jmharvey1/SdrCwXcvr/Eagle/SDR 74HC4052/SDR 74HC4052_Si5351R1Board.pdf

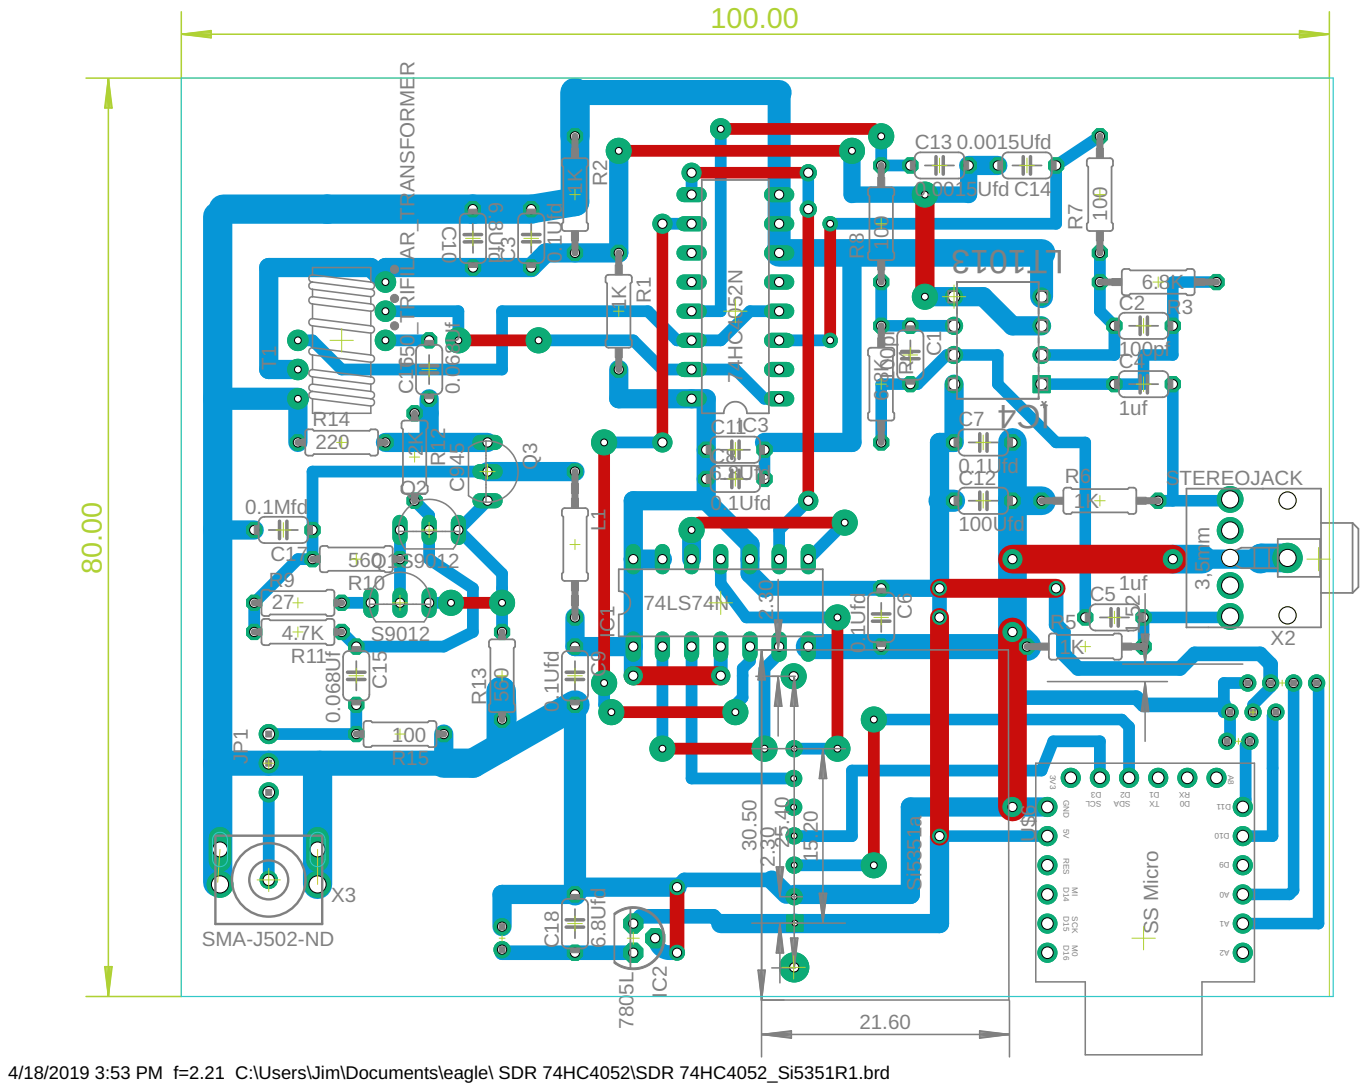
[picture p1: page 1]

4/18/2019 3:53 PM f=2.21 C:\Users\Jim\Documents\eagle\ SDR 74HC4052\SDR 74HC4052_Si5351R1.brd
