jmharvey1/SdrCwXcvr/Eagle/SDR 74HC4052/SDR 74HC4052_Si5351R1Schem.pdf

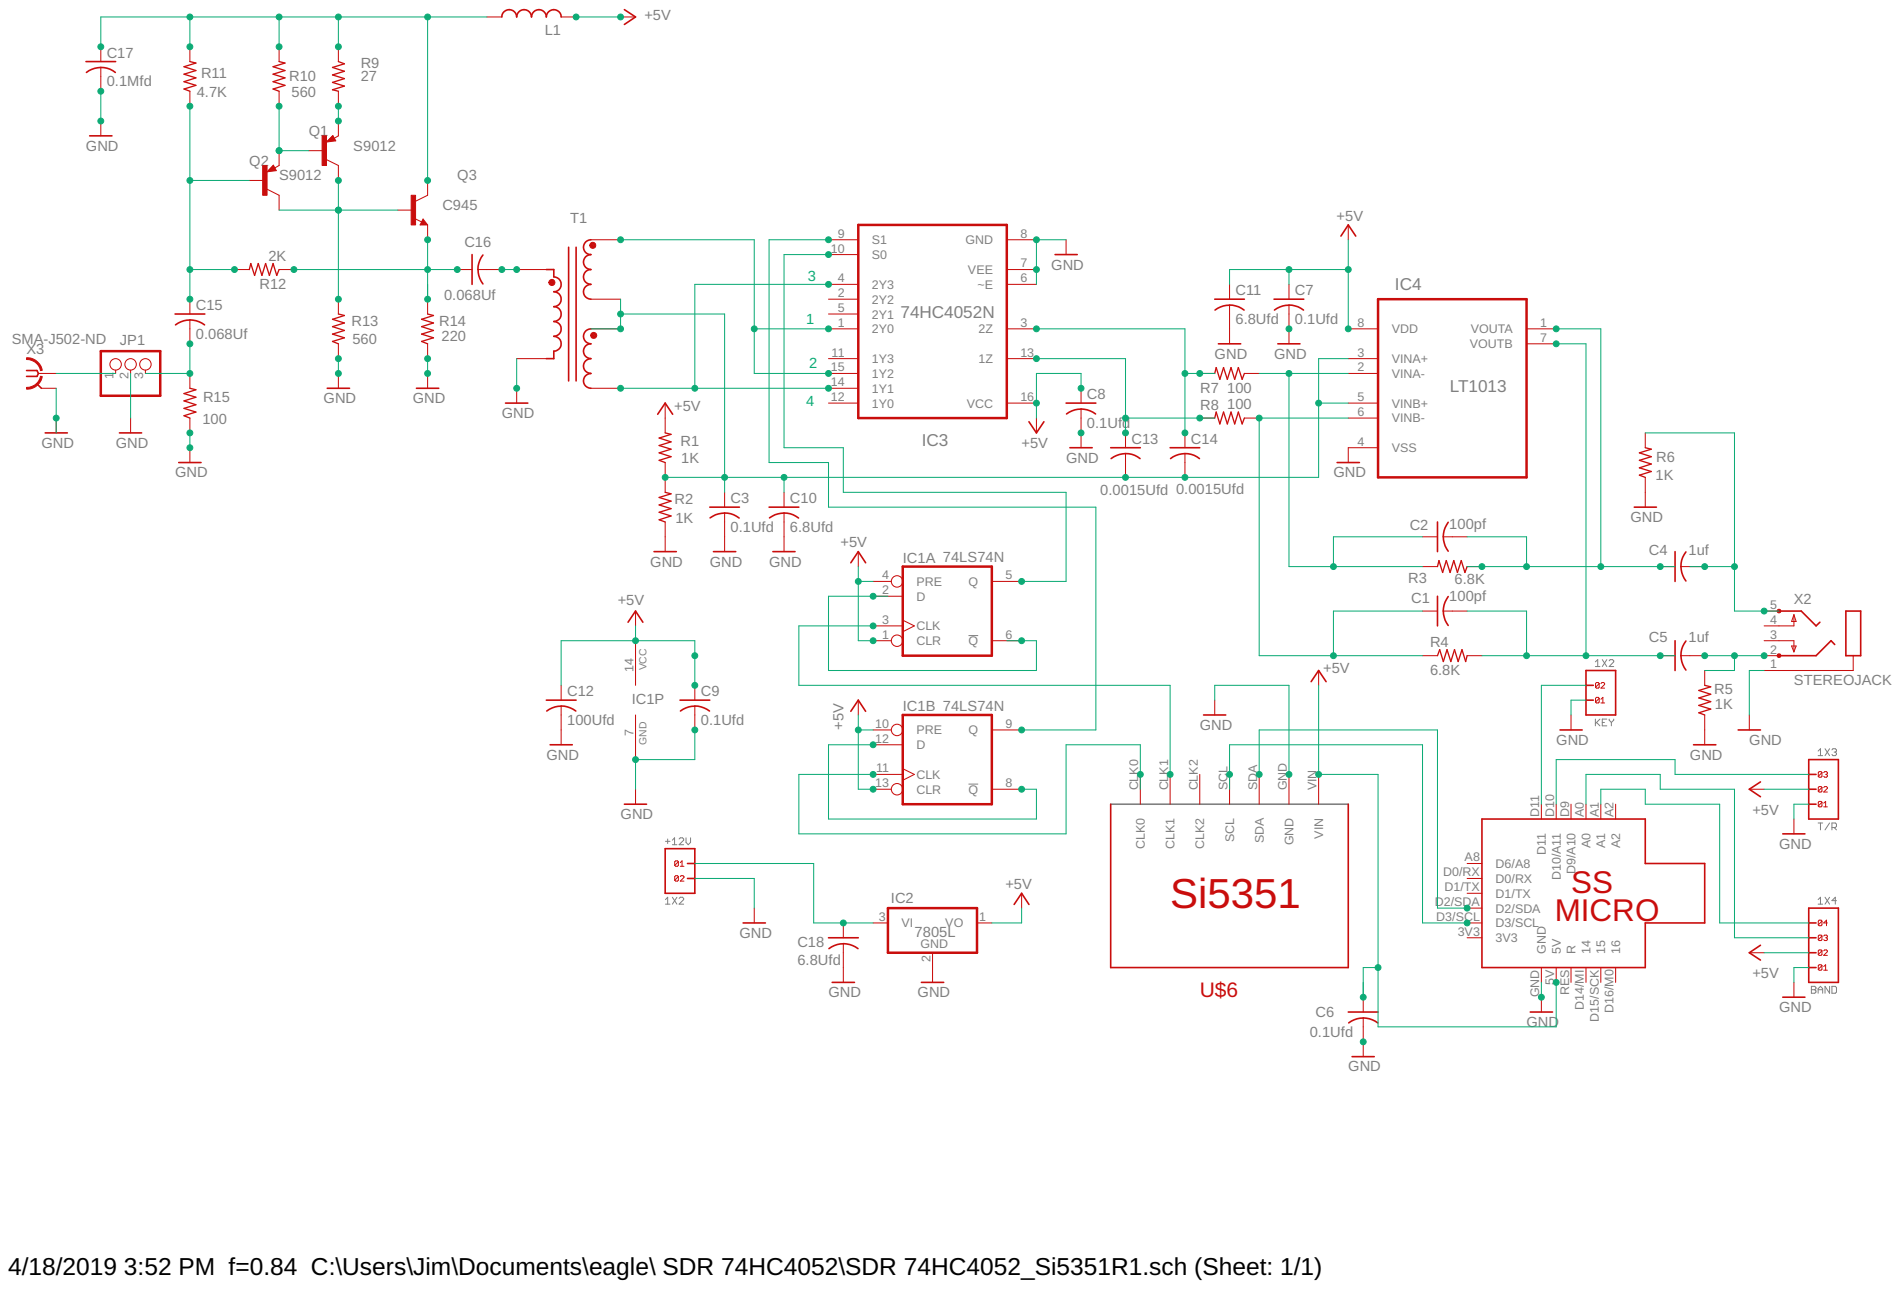
[picture p2: page 1]

4/18/2019 3:52 PM f=0.84 C:\Users\Jim\Documents\eagle\ SDR 74HC4052\SDR 74HC4052_Si5351R1.sch (Sheet: 1/1)
