jmharvey1/SdrCwXcvr/Eagle/100mwPA/40M_100mWattWSPRamp.pdf

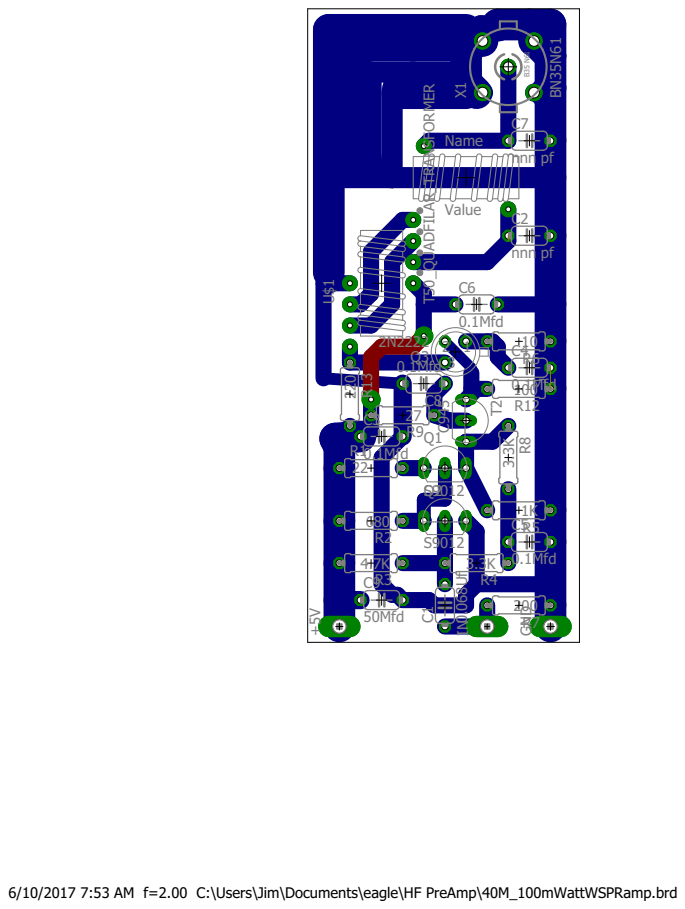
[picture p3: page 1]

6/10/2017 7:53 AM f=2.00 C:\Users\Jim\Documents\eagle\HF PreAmp\40M_100mWattWSPRamp.brd
