jmharvey1/SdrCwXcvr/Eagle/SDR 74HC4052/SDR 74HC4052_Si5351SchemR0.pdf

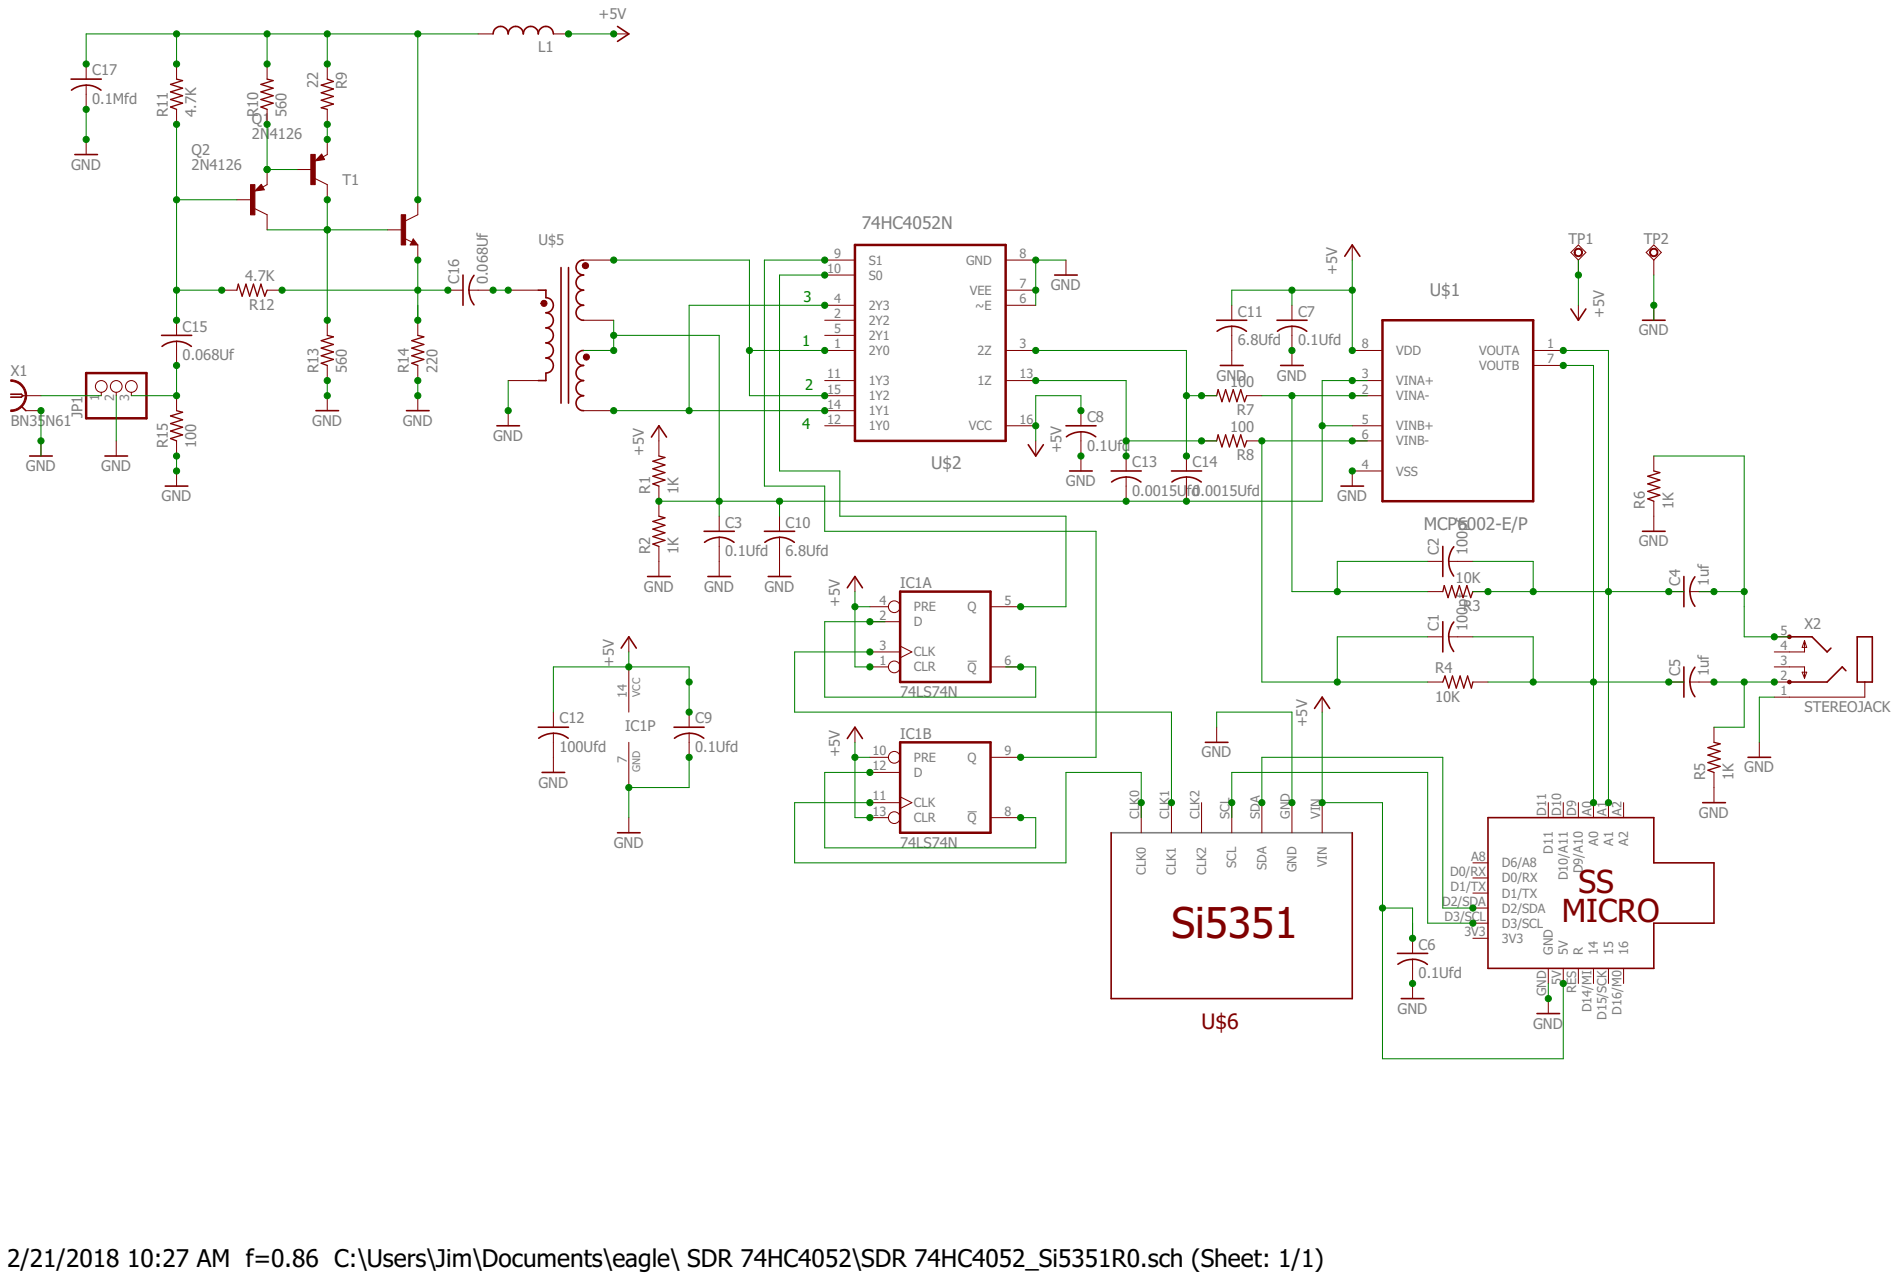
[picture p4: page 1]

2/21/2018 10:27 AM f=0.86 C:\Users\Jim\Documents\eagle\ SDR 74HC4052\SDR 74HC4052_Si5351R0.sch (Sheet: 1/1)
