jmharvey1/SdrCwXcvr/Eagle/SDR 74HC4052/SDR 74HC4052_Si5351R1.brd

## EAGLE design Eagle/SDR 74HC4052/SDR 74HC4052_Si5351R1.brd (2019-04-18)

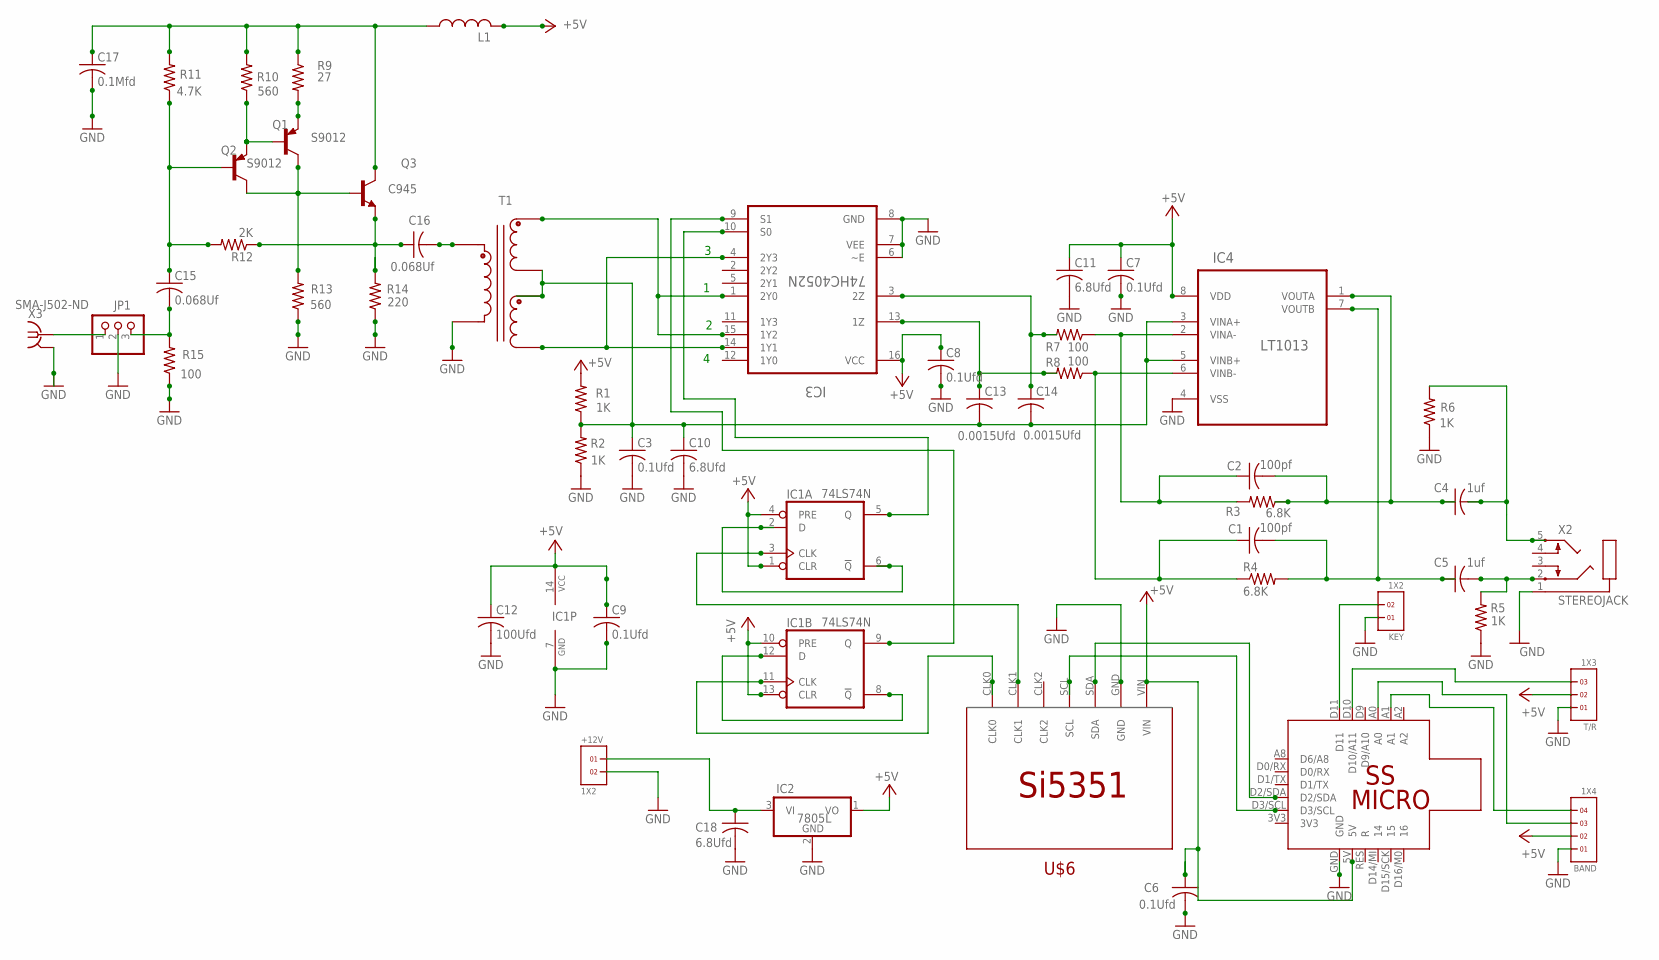
[picture p5: schematic SDR 74HC4052_Si5351R1.sch]

Parts:
+12V: 1X2
BAND: 1X4
C1, C2: 100pf; C050-024X044
C3, C6, C7, C8, C9: 0.1Ufd; C050-024X044
C4, C5: 1uf; C050-024X044
C10, C11, C18: 6.8Ufd; C050-024X044
C12: 100Ufd; C050-024X044
C13, C14: 0.0015Ufd; C050-024X044
C15, C16: 0.068Uf; C050-024X044
C17: 0.1Mfd; C050-024X044
IC1: 74LS74N; DIL14
IC2: 7805L; TO92
IC3: 74HC4052N; DIL16
IC4: LT1013; DIP254P762X533-8
JP1: PINHD-1X3CB; 1X03-CLEANBIG
KEY: 1X2
L1: L-US0207/12; 0207/12
Q1, Q2: S9012; TO92-CBE
Q3: C945; TO92-ECB
R1, R2, R5, R6: 1K; 0207/10
R3, R4: 6.8K; 0207/10
R7, R8: 100; 0207/10
R9: 27; 0207/7
R10, R13: 560; 0207/7
R11: 4.7K; 0207/7
R12: 2K; 0207/7
R14: 220; 0207/7
R15: 100; 0207/7
T1: T50_TRIFILAR_TRANSFORMER
T/R: 1X3
U$4: SS_MICRO
U$6: SI5351-BKBD; SI5351-BKOUT-BRD
X2: STEREOJACK; STX3100
X3: SMA-J502-ND; J502-ND

Connections:
+5V: BAND.2, C6.1, C7.1, C8.1, C9.1, C11.1, C12.1, IC1.1 (CLR), IC1.4 (PRE), IC1.10 (PRE), IC1.13 (CLR), IC1.14 (VCC), IC2.1 (VO), IC3.16 (VCC), IC4.8 (VDD), L1.2, R1.2, T/R.2, U$4.5V, U$6.VIN
GND: +12V.2, BAND.1, C3.2, C6.2, C7.2, C8.2, C9.2, C10.2, C11.2, C12.2, C17.2, C18.2, IC1.7 (GND), IC2.2 (GND), IC3.6 (~E), IC3.7 (VEE), IC3.8 (GND), IC4.4 (VSS), JP1.2, KEY.1, R2.1, R5.1, R6.1, R13.1, R14.1, R15.1, T1.C1A, T/R.1, U$4.GND, U$6.GND, X2.1, X3.2, X3.3 (2), X3.4 (2), X3.5 (2)
unnamed: C1.1, IC4.6 (VINB-), R4.1, R8.1
unnamed: C13.1, IC3.13 (1Z), R8.2
unnamed: C2.1, IC4.2 (VINA-), R3.2, R7.1
unnamed: C14.1, IC3.3 (2Z), R7.2
unnamed: C16.2, T1.C1B
unnamed: IC1.11 (CLK), U$6.CLK0
unnamed: IC1.5 (Q), IC3.10 (S0)
unnamed: IC3.1 (2Y0), IC3.15 (1Y2), T1.C2B
unnamed: C2.2, C4.1, IC4.1 (VOUTA), R3.1
unnamed: C1.2, C5.1, IC4.7 (VOUTB), R4.2
unnamed: Q1.E, R9.2
unnamed: U$4.D3/SCL, U$6.SCL
unnamed: U$4.D2/SDA, U$6.SDA
unnamed: C3.1, C10.1, C13.2, C14.2, IC4.3 (VINA+), IC4.5 (VINB+), R1.1, R2.2, T1.C2A, T1.C3B
unnamed: Q1.B, Q2.E, R10.1
unnamed: IC1.3 (CLK), U$6.CLK1
unnamed: IC3.4 (2Y3), IC3.14 (1Y1), T1.C3A
unnamed: IC1.9 (Q), IC3.9 (S1)
unnamed: C5.2, R5.2, X2.2
unnamed: C4.2, R6.2, X2.5
unnamed: IC1.2 (D), IC1.6 (!Q)
unnamed: IC1.8 (!Q), IC1.12 (D)
unnamed: Q1.C, Q2.C, Q3.B, R13.2
unnamed: C15.1, Q2.B, R11.1, R12.2
unnamed: C15.2, JP1.3, R15.2
unnamed: JP1.1, X3.1
unnamed: C16.1, Q3.E, R12.1, R14.2
unnamed: C17.1, L1.1, Q3.C, R9.1, R10.2, R11.2
unnamed: +12V.1, C18.1, IC2.3 (VI)
unnamed: T/R.3, U$4.D10 (D10/A11)
unnamed: BAND.3, U$4.A0
unnamed: BAND.4, U$4.A1
unnamed: KEY.2, U$4.D11

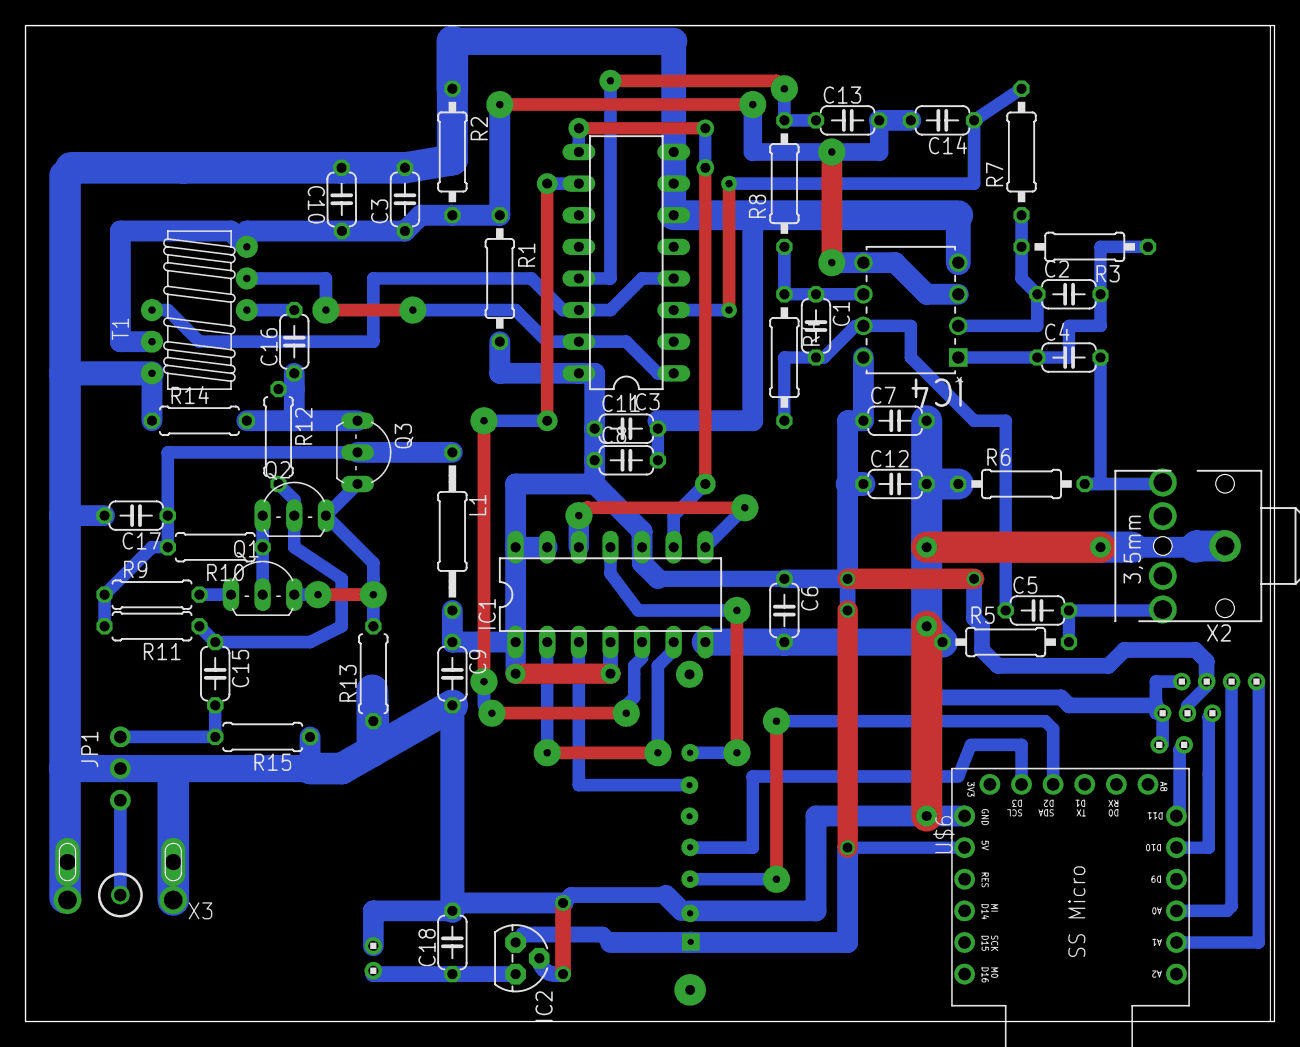
[picture p6: board SDR 74HC4052_Si5351R1.brd from above]

Board: 2 copper layers, 100.3 x 80.0 mm, 51 parts (0 on the bottom side), 35 nets.
