jmharvey1/SdrCwXcvr/Eagle/100mwPA/40M_100mWattWSPRamp.brd

## EAGLE design Eagle/100mwPA/40M_100mWattWSPRamp.brd (2018-12-15)

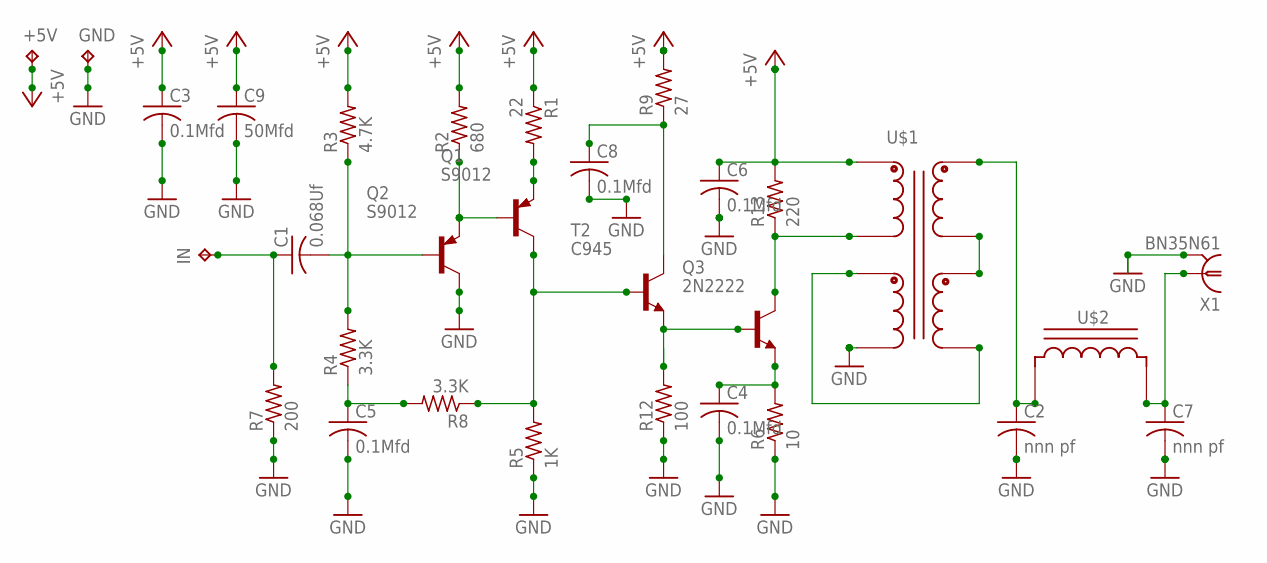
[picture p7: schematic 40M_100mWattWSPRamp.sch]

Parts:
+5V: TPPAD1-17Y; P1-17Y
C1: 0.068Uf; C050-024X044
C2, C7: nnn pf; C050-024X044
C3, C4, C5, C6, C8: 0.1Mfd; C050-024X044
C9: 50Mfd; C050-024X044
GND: TPPAD1-17Y; P1-17Y
IN: TPPAD1-17Y; P1-17Y
Q1, Q2: S9012; TO92-CBE
Q3: 2N2222; TO18
R1: 22; 0207/7
R2: 680; 0207/7
R3: 4.7K; 0207/7
R4, R8: 3.3K; 0207/7
R5: 1K; 0207/7
R6: 10; 0207/7
R7: 200; 0207/7
R9: 27; 0207/7
R12: 100; 0207/7
R13: 220; 0207/7
T2: C945; TO92-ECB
U$1: T50_QUADFILAR_TRANSFORMER
U$2: T50_INDUCTOR
X1: BN35N61; B35N61

Connections:
+5V: +5V.TP, C3.1, C6.1, C9.1, R1.1, R2.2, R3.2, R9.2, R13.2, U$1.C1B
+5V1: C5.1, R4.1, R8.2
+5V2: C2.1, U$1.C2B, U$2.CB
+5V3: C7.1, U$2.CA, X1.1
+5V4: C8.1, R9.1, T2.C
GND: C2.2, C3.2, C4.2, C5.2, C6.2, C7.2, C8.2, C9.2, GND.TP, Q2.C, R5.1, R6.1, R7.1, R12.1, U$1.C4A, X1.2, X1.3 (2), X1.4 (2), X1.5 (2)
unnamed: Q1.E, R1.2
unnamed: Q1.B, Q2.E, R2.1
unnamed: Q3.2 (B), R12.2, T2.E
unnamed: C1.2, Q2.B, R3.1, R4.2
unnamed: C1.1, IN.TP, R7.2
unnamed: U$1.C3A, U$1.C4B
unnamed: C4.1, Q3.1 (E), R6.2
unnamed: U$1.C2A, U$1.C3B
unnamed: Q1.C, R5.2, R8.1, T2.B
unnamed: Q3.3 (C), R13.1, U$1.C1A

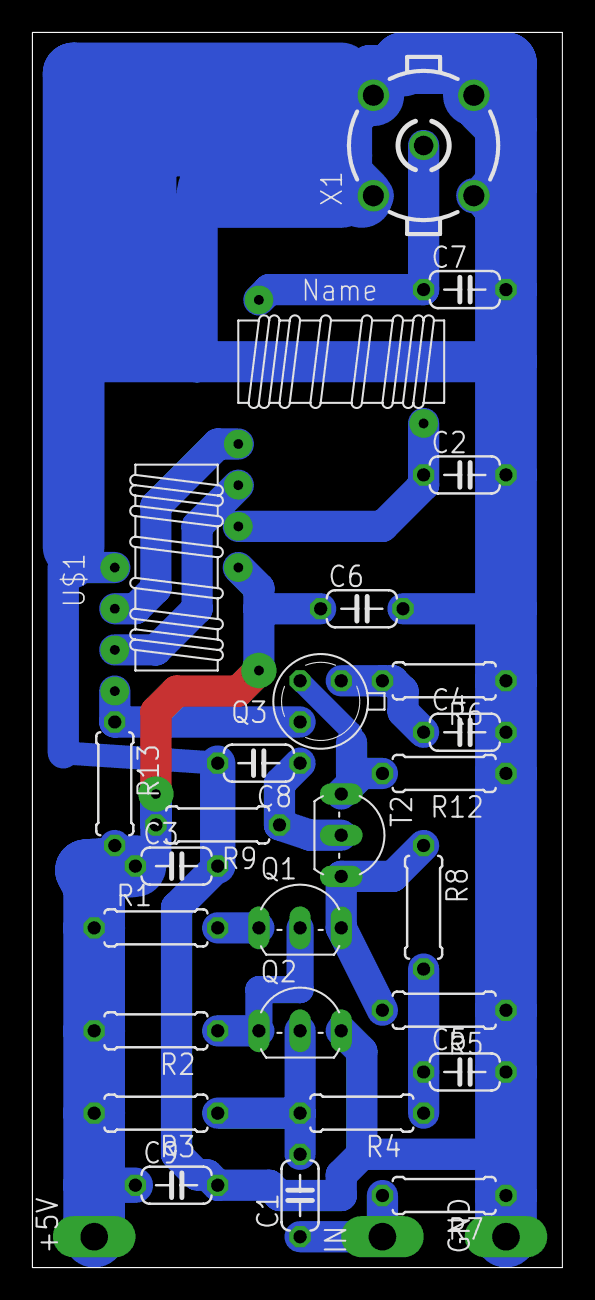
[picture p8: board 40M_100mWattWSPRamp.brd from above]

Board: 2 copper layers, 32.7 x 76.2 mm, 30 parts (0 on the bottom side), 16 nets.
