jmharvey1/SdrCwXcvr/Eagle/74145SDRbandCntrlBd/74145SDRbandCntrlBd.brd

## EAGLE design Eagle/74145SDRbandCntrlBd/74145SDRbandCntrlBd.brd (2018-12-14)

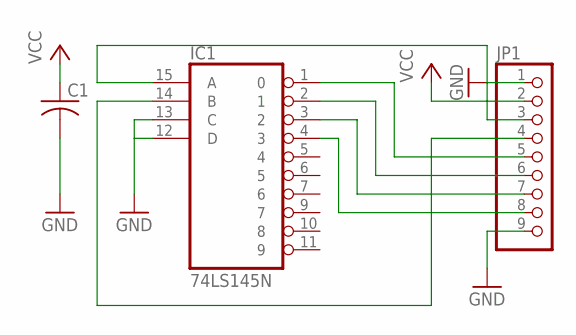
[picture p9: schematic 74145SDRbandCntrlBd.sch]

Parts:
C1: C-US050-024X044; C050-024X044
IC1: 74LS145N; DIL16
JP1: PINHD-1X9; 1X09-BIG

Connections:
GND: C1.2, IC1.8 (GND), IC1.12 (D), IC1.13 (C), JP1.1, JP1.9
unnamed: IC1.15 (A), JP1.3
unnamed: IC1.14 (B), JP1.4
unnamed: IC1.4 (3), JP1.8
unnamed: IC1.3 (2), JP1.7
unnamed: IC1.2 (1), JP1.6
unnamed: IC1.1 (0), JP1.5
VCC: C1.1, IC1.16 (VCC), JP1.2

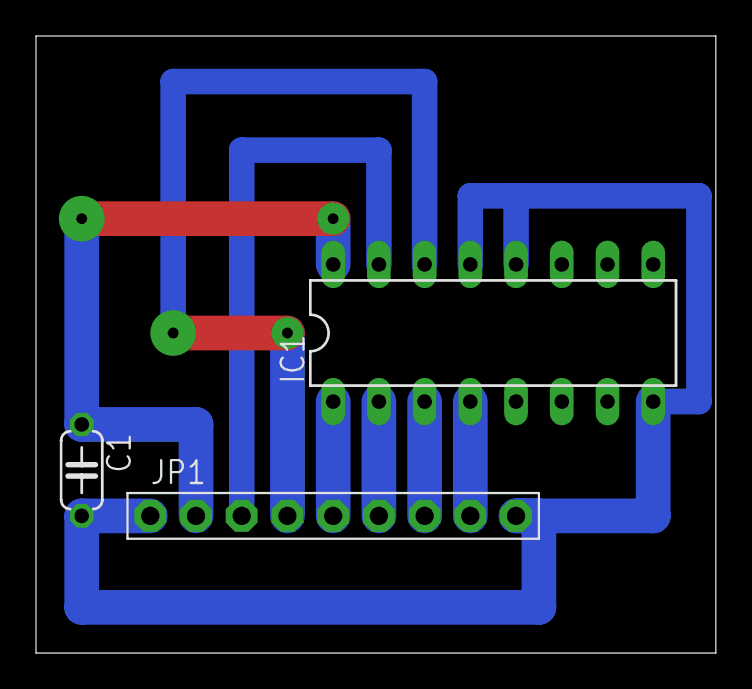
[picture p10: board 74145SDRbandCntrlBd.brd from above]

Board: 2 copper layers, 37.8 x 34.3 mm, 3 parts (0 on the bottom side), 8 nets.
