jmharvey1/SdrCwXcvr/Quisk/quisk.py

#! /usr/bin/python

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
"""The main program for Quisk, a software defined radio.

Usage:  python quisk.py [-c | --config config_file_path]
This can also be installed as a package and run as quisk.main().
"""

from __future__ import print_function
from __future__ import absolute_import
from __future__ import division

# Change to the directory of quisk.py.  This is necessary to import Quisk packages
# and to load other extension modules that link against _quisk.so.  It also helps to
# find ./__init__.py and ./help.html.
import sys, os
os.chdir(os.path.normpath(os.path.dirname(__file__)))
if sys.path[0] != "'.'":		# Make sure the current working directory is on path
  sys.path.insert(0, '.')

import wx, wx.html, wx.lib.stattext, wx.lib.colourdb, wx.grid, wx.richtext
import math, cmath, time, traceback, string, select, subprocess
import threading, pickle, webbrowser
try:
  from xmlrpc.client import ServerProxy
except ImportError:
  from xmlrpclib import ServerProxy
import _quisk as QS
from types import *
from quisk_widgets import *
from filters import Filters
import dxcluster
import configure

DEBUGSHELL = False
if DEBUGSHELL:
  from wx.py.crust import CrustFrame
  from wx.py.shell import ShellFrame

# Fldigi XML-RPC control opens a local socket.  If socket.setdefaulttimeout() is not
# called, the timeout on Linux is zero (1 msec) and on Windows is 2 seconds.  So we
# call it to insure consistent behavior.
import socket
socket.setdefaulttimeout(0.005)

HAMLIB_DEBUG = 0

application = None

# Command line parsing: be able to specify the config file.
from optparse import OptionParser
parser = OptionParser()
parser.add_option('-c', '--config', dest='config_file_path',
		help='Specify the configuration file path')
parser.add_option('', '--config2', dest='config_file_path2', default='',
		help='Specify a second configuration file to read after the first')
parser.add_option('-a', '--ask', action="store_true", dest='AskMe', default=False,
		help='Ask which radio to use when starting')
parser.add_option('', '--local', dest='local_option', default='',
		help='Specify a custom option that you have programmed yourself')
argv_options = parser.parse_args()[0]
ConfigPath = argv_options.config_file_path	# Get config file path
ConfigPath2 = argv_options.config_file_path2
LocalOption = argv_options.local_option
if sys.platform == 'win32':
  path = os.getenv('HOMEDRIVE', '') + os.getenv('HOMEPATH', '')
  for dir in ("Documents", "My Documents", "Eigene Dateien", "Documenti", "Mine Dokumenter"):
    config_dir = os.path.join(path, dir)
    if os.path.isdir(config_dir):
      break
  else:
    config_dir = os.path.join(path, "My Documents")
  try:
    try:
      import winreg as Qwinreg
    except ImportError:
      import _winreg as Qwinreg
    key = Qwinreg.OpenKey(Qwinreg.HKEY_CURRENT_USER,
       r"Software\Microsoft\Windows\CurrentVersion\Explorer\User Shell Folders")
    val = Qwinreg.QueryValueEx(key, "Personal")
    val = Qwinreg.ExpandEnvironmentStrings(val[0])
    Qwinreg.CloseKey(key)
    if os.path.isdir(val):
      DefaultConfigDir = val
    else:
      DefaultConfigDir = config_dir
  except:
    traceback.print_exc()
    DefaultConfigDir = config_dir
  if not ConfigPath:
    ConfigPath = os.path.join(DefaultConfigDir, "quisk_conf.py")
    if not os.path.isfile(ConfigPath):
      path = os.path.join(config_dir, "quisk_conf.py")
      if os.path.isfile(path):
        ConfigPath = path
  del config_dir
else:
  DefaultConfigDir = os.path.expanduser('~')
  if not ConfigPath:
    ConfigPath = os.path.join(DefaultConfigDir, ".quisk_conf.py")

# These FFT sizes have multiple small factors, and are prefered for efficiency.  FFT size must be an even number.
fftPreferedSizes = []
for f2 in range(1, 13):
  for y in (1, 3, 5, 7, 9, 11, 13, 15):
    for z in (1, 3, 5, 7, 9, 11, 13, 15):
      x = 2**f2 * y * z
      if 300 <= x <= 5000 and x not in fftPreferedSizes:
        fftPreferedSizes.append(x)
fftPreferedSizes.sort()

def round(x):	# round float to nearest integer
  if x >= 0:
    return int(x + 0.5)
  else:
    return - int(-x + 0.5)
    
def str2freq (freq):
  if '.' in freq:
    freq = int(float(freq) * 1E6 + 0.1)
  else:
    freq = int(freq)
  return freq    

def get_filter_tx(mode):	# Return the bandwidth, center of the Tx filters
  if mode in ('LSB', 'USB'):
    bw = 2700
    center = 1650
  elif mode in ('CWL', 'CWU'):
    bw = 10
    center = 0
  elif mode in ('AM', 'DGT-IQ'):
    bw = 6000
    center = 0
  elif mode in ('FM', 'DGT-FM'):
    bw = 10000
    center = 0
  elif mode in ('FDV-L', 'FDV-U'):
    bw = 2700
    center = 1500
  else:
    bw = 2700
    center = 1650
  if mode in ('CWL', 'LSB', 'DGT-L', 'FDV-L'):
    center = - center
  return bw, center

Mode2Index = {'CWL':0, 'CWU':1, 'LSB':2, 'USB':3, 'AM':4, 'FM':5, 'EXT':6, 'DGT-U':7, 'DGT-L':8, 'DGT-IQ':9,
      'IMD':10, 'FDV-U':11, 'FDV-L':12, 'DGT-FM':13}

class Timer:
  """Debug: measure and print times every ptime seconds.

  Call with msg == '' to start timer, then with a msg to record the time.
  """
  def __init__(self, ptime = 1.0):
    self.ptime = ptime		# frequency to print in seconds
    self.time0 = 0			# time zero; measure from this time
    self.time_print = 0		# last time data was printed
    self.timers = {}		# one timer for each msg
    self.names = []			# ordered list of msg
    self.heading = 1		# print heading on first use
  def __call__(self, msg):
    tm = time.time()
    if msg:
      if not self.time0:		# Not recording data
        return
      if msg in self.timers:
        count, average, highest = self.timers[msg]
      else:
        self.names.append(msg)
        count = 0
        average = highest = 0.0
      count += 1
      delta = tm - self.time0
      average += delta
      if highest < delta:
        highest = delta
      self.timers[msg] = (count, average, highest)
      if tm - self.time_print > self.ptime:	# time to print results
        self.time0 = 0		# end data recording, wait for reset
        self.time_print = tm
        if self.heading:
          self.heading = 0
          print ("count, msg, avg, max (msec)")
        print("%4d" % count, end=' ')
        for msg in self.names:		# keep names in order
          count, average, highest = self.timers[msg]
          if not count:
            continue
          average /= count
          print("  %s  %7.3f  %7.3f" % (msg, average * 1e3, highest * 1e3), end=' ')
          self.timers[msg] = (0, 0.0, 0.0)
        print()
    else:	# reset the time to zero
      self.time0 = tm		# Start timer
      if not self.time_print:
        self.time_print = tm

## T = Timer()		# Make a timer instance

class HamlibHandlerSerial:
  "Create a serial port for Hamlib control that emulates the FlexRadio PowerSDR 2.x command set."
  # This implements some Kenwood TS-2000 commands, but it is far from complete.
  Mo2CoKen = {'CWL':7, 'CWU':3, 'LSB':1, 'USB':2, 'AM':5, 'FM':4, 'DGT-U':9, 'DGT-L':6, 'DGT-FM':4, 'DGT-IQ':9}
  Co2MoKen = {1:'LSB', 2:'USB', 3:'CWU', 4:'FM', 5:'AM', 6:'DGT-L', 7:'CWL', 9:'DGT-U'}
  Mo2CoFlex = {'CWL':3, 'CWU':4, 'LSB':0, 'USB':1, 'AM':6, 'FM':5, 'DGT-U':7, 'DGT-L':9, 'DGT-FM':5, 'DGT-IQ':7}
  Co2MoFlex = {0:'LSB', 1:'USB', 3:'CWL', 4:'CWU', 5:'FM', 6:'AM', 7:'DGT-U', 9:'DGT-L'}
  def __init__(self, app, public_name):
    self.app = app
    self.port = None
    self.received = ''
    self.radio_id = '019'
    self.public_name = public_name	# the public name for the serial port
    if sys.platform == 'win32':
      try:
        import serial
      except:
        print ("Please install the pyserial module.")
      else:
        try:
          self.port = serial.Serial(public_name, timeout=0, write_timeout=0)
        except:
          print ("The serial port %s could not be opened." % public_name)
    else:
      import tty
      if os.path.lexists(public_name):
        try:
          os.remove(public_name)
        except:
          print ("Can not remove the file", public_name)
      try:
        self.port, slave = os.openpty()	# we are the master device fd, slave is a pseudo tty
        tty.setraw(self.port)
        tty.setraw(slave)
      except:
        print ("Can not create the serial port")
        self.port = None
      else:
        try:
          os.symlink(os.ttyname(slave), public_name)	# create a link from the specified name to the slave device
        except:
          print ("Can not create a link named", public_name)
          self.port = None
        else:
          if HAMLIB_DEBUG: print ("Create", public_name, "from", os.ttyname(slave))
  def open(self):
    return
  def close(self):
    if sys.platform != 'win32':
      if self.public_name:
        try:
          os.remove(self.public_name)
        except:
          pass
  def Read(self):
    if self.port is None:
      return
    if sys.platform == 'win32':
      self.received += str(self.port.read(99))
    else:
      while True:
        r, w, x = select.select((self.port,), (), (), 0)
        if not r:
          break
        self.received += os.read(self.port, 1)
  def Process(self):
    """This is the main processing loop, and is called frequently.  It reads and satisfies requests."""
    self.Read()
    if ';' in self.received:	# A complete command ending with semicolon is available
      cmd, self.received = self.received.split(';', 1)	# Split off the command, save any further characters
    else:
      return
    cmd = cmd.strip()		# Here is our command and data
    if cmd[0:2] in ('ZZ', 'zz', 'Zz', 'zZ'):
      data = cmd[4:]
      cmd = cmd[0:4].upper()
      func = cmd
    else:
      data = cmd[2:]
      cmd = cmd[0:2].upper()
      if cmd in ('FA', 'FB', 'IF', 'PS'):	# Use the ZZxx command method
        func = 'ZZ' + cmd
      else:			# Use the two-letter method
        func = cmd
    if data:
      if HAMLIB_DEBUG: print ("Process command  :", cmd, data)
    try:
      func = getattr(self, func)
    except:
      print ("Unimplemented serial port function", func, 'cmd', cmd, 'data', data)
      self.Write('?;')
      return
    func(cmd, data, len(data))
  def Error(self, cmd, data):
    self.Write('?;')
    print ("*** Error for cmd %s data %s" % (cmd, data))
  def Write(self, data):
    if HAMLIB_DEBUG: print ("Serial port write:", data)
    if self.port is None:
      return
    if sys.platform == 'win32':
      self.port.write(data)
    else:
      r, w, x = select.select((), (self.port,), (), 0)
      if w:
        os.write(self.port, data)
  def AG(self, cmd, data, length):	# audio gain
    if length == 1:
      self.Write("%s%s120;" % (cmd, data[0]))
  def ZZAG(self, cmd, data, length):	# audio gain
    if length == 0:
      self.Write("%s050;" % cmd)
  def ZZAI(self, cmd, data, length):	# broadcast changes
    if length == 0:
      self.Write("%s0;" % cmd)
    elif length == 1 and data[0] == '0':
      pass
    else:
      self.Error(cmd, data)
  def ZZFA(self, cmd, data, length):	# frequency of VFO A, the receive frequency
    if length == 0:
      self.Write("%s%011d;" % (cmd, self.app.rxFreq + self.app.VFO))
    elif length == 11:
      freq = int(data, base=10)
      tune = freq - self.app.VFO
      d = self.app.sample_rate * 45 // 100
      if -d <= tune <= d:	# Frequency is on-screen
        vfo = self.app.VFO
      else:					# Change the VFO
        vfo = (freq // 5000) * 5000 - 5000
        tune = freq - vfo
      self.app.BandFromFreq(freq)
      self.app.ChangeHwFrequency(tune, vfo, 'FreqEntry')
      if HAMLIB_DEBUG: print ("New Freq rx,tx", self.app.txFreq + self.app.VFO, self.app.rxFreq + self.app.VFO)
    else:
      self.Error(cmd, data)
  def ZZFB(self, cmd, data, length):	# frequency of VFO B
    if length == 0:
      self.Write("%s%011d;" % (cmd, self.app.txFreq + self.app.VFO))
    elif length == 11:
      freq = int(data, base=10)
      tune = freq - self.app.VFO
      d = self.app.sample_rate * 45 // 100
      if -d <= tune <= d:	# Frequency is on-screen
        vfo = self.app.VFO
      else:					# Change the VFO
        vfo = (freq // 5000) * 5000 - 5000
        tune = freq - vfo
      self.app.BandFromFreq(freq)
      self.app.ChangeHwFrequency(tune, vfo, 'FreqEntry')
    else:
      self.Error(cmd, data)
  def FR(self, cmd, data, length):	# receive VFO is always VFO A
    if length == 0:
      self.Write("%s0;" % cmd)
    elif length == 1 and data[0] == '0':
      pass
    else:
      self.Error(cmd, data)
  def FT(self, cmd, data, length):	# transmit VFO
    if self.app.split_rxtx:
      vfo = '1'
    else:
      vfo = '0'
    if length == 0:
      self.Write("%s%s;" % (cmd, vfo))
    elif length == 1 and data[0] == vfo:
      pass
    else:
      self.Error(cmd, data)
  def ID(self, cmd, data, length):	# return radio ID
    if length == 0:
      self.Write('%s%s;' % (cmd, self.radio_id))
    else:
      self.Error(cmd, data)
  def ZZID(self, cmd, data, length):	# set radio id to Flex
    if length == 0:
      self.radio_id = '900'
    else:
      self.Error(cmd, data)
  def ZZIF(self, cmd, data, length):	# return information for ZZIF and IF
    ritFreq = self.app.ritScale.GetValue()
    if self.app.ritButton.GetValue():
      rit = 1
    else:
      rit = 0
    mode = self.app.mode
    info = cmd
    info += "%011d" % (self.app.rxFreq + self.app.VFO)	# frequency, ZZFA
    info += '0000'
    if ritFreq < 0:	# RIT freq
      info += "-%05d" % -ritFreq
    else:
      info += "+%05d" % ritFreq
    info += "%d" % rit	# RIT status
    info += '0000'
    if QS.is_key_down():	# MOX, key down
      info += '1'
    else:
      info += '0'
    if len(cmd) == 4:	# Flex ZZIF
      code = self.Mo2CoFlex.get(mode, 1)
      info += "%02d" % code	# operating mode
    else:		# Kenwood IF
      code = self.Mo2CoKen.get(mode, 1)
      info += "%d" % code	# operating mode
    info += '00'
    if self.app.split_rxtx:	# VFO split status
      info += '1'
    else:
      info += '0'
    info += '0000'
    info += ';'
    self.Write(info)
  def MD(self, cmd, data, length):	# the mode; USB, CW, etc.
    if length == 0:
      mode = self.app.mode
      code = self.Mo2CoKen.get(mode, 2)
      self.Write("%s%d;" % (cmd, code))
    elif length == 1:
      code = int(data, base=10)
      mode = self.Co2MoKen.get(code, 'USB')
      self.app.OnBtnMode(None, mode)		# Set mode
    else:
      self.Error(cmd, data)
  def ZZMD(self, cmd, data, length):	# the mode; USB, CW, etc.
    if length == 0:
      mode = self.app.mode
      code = self.Mo2CoFlex.get(mode, 1)
      self.Write("%s%02d;" % (cmd, code))
    elif length == 2:
      code = int(data, base=10)
      mode = self.Co2MoFlex.get(code, 'USB')
      self.app.OnBtnMode(None, mode)	# Set mode
    else:
      self.Error(cmd, data)
  def ZZMU(self, cmd, data, length):	# MultiRx on/off
    if length == 0:
      self.Write("%s0;" % cmd)
  def OI(self, cmd, data, length):      # return information
    self.ZZIF(cmd, data, length)
  def ZZPS(self, cmd, data, length):	# power status
    if length == 0:
      self.Write("%s1;" % cmd)
  def ZZRS(self, cmd, data, length):	# the RX2 status
    if length == 0:
      self.Write("%s0;" % cmd)
    elif length == 1 and data[0] == '0':
      pass
    else:
      self.Error(cmd, data)
  def RX(self, cmd, data, length):	# turn off MOX
    if length == 0:
      if self.app.pttButton:
        self.app.pttButton.SetValue(0, True)
      else:
        self.Error(cmd, data)
    else:
      self.Error(cmd, data)
  def ZZSP(self, cmd, data, length):	# the split status
    if length == 0:
      if self.app.split_rxtx:
        self.Write("%s1;" % cmd)
      else:
        self.Write("%s0;" % cmd)
    else:
      self.Error(cmd, data)
  def ZZSW(self, cmd, data, length):	# transmit VFO is A or B
    if length == 0:
      if self.app.split_rxtx:
        self.Write("%s1;" % cmd)
      else:
        self.Write("%s0;" % cmd)
  def TX(self, cmd, data, length):	# turn on MOX
    if length == 0:
      if self.app.pttButton:
        self.app.pttButton.SetValue(1, True)
      else:
        self.Error(cmd, data)
    else:
      self.Error(cmd, data)
  def ZZTX(self, cmd, data, length):	# the MOX status
    if length == 0:
      if QS.is_key_down():
        self.Write("%s1;" % cmd)
      else:
        self.Write("%s0;" % cmd)
    elif length == 1:
      if self.app.pttButton:
        if data[0] == '0':
          self.app.pttButton.SetValue(0, True)
        else:
          self.app.pttButton.SetValue(1, True)
      else:
        self.Error(cmd, data)
    else:
      self.Error(cmd, data)
  def ZZVE(self, cmd, data, length):	# is VOX enabled
    if length == 0:
      if self.app.useVOX:
        self.Write("%s1;" % cmd)
      else:
        self.Write("%s0;" % cmd)
    else:
      self.Error(cmd, data)
  def XT(self, cmd, data, length):	# the XIT
    if length == 0:
      self.Write("%s0;" % cmd)
    elif length == 1 and data[0] == '0':
      pass
    else:
      self.Error(cmd, data)

class HamlibHandlerRig2:
  """This class is created for each connection to the server.  It services requests from each client"""
  SingleLetters = {		# convert single-letter commands to long commands
    '_':'info',
    'f':'freq',
    'i':'split_freq',
    'm':'mode',
    's':'split_vfo',
    't':'ptt',
    'v':'vfo',
    }
# I don't understand the need for dump_state, nor what it means.
# A possible response to the "dump_state" request:
  dump1 = """ 2
2
2
150000.000000 1500000000.000000 0x1ff -1 -1 0x10000003 0x3
0 0 0 0 0 0 0
0 0 0 0 0 0 0
0x1ff 1
0x1ff 0
0 0
0x1e 2400
0x2 500
0x1 8000
0x1 2400
0x20 15000
0x20 8000
0x40 230000
0 0
9990
9990
10000
0
10 
10 20 30 
0x3effffff
0x3effffff
0x7fffffff
0x7fffffff
0x7fffffff
0x7fffffff
"""

# Another possible response to the "dump_state" request:
  dump2 = """ 0
2
2
150000.000000 30000000.000000  0x900af -1 -1 0x10 000003 0x3
0 0 0 0 0 0 0
150000.000000 30000000.000000  0x900af -1 -1 0x10 000003 0x3
0 0 0 0 0 0 0
0 0
0 0
0
0
0
0


0x0
0x0
0x0
0x0
0x0
0
"""
  def __init__(self, app, sock, address):
    self.app = app		# Reference back to the "hardware"
    self.sock = sock
    sock.settimeout(0.0)
    self.address = address
    self.received = ''
    h = self.Handlers = {}
    h[''] = self.ErrProtocol
    h['dump_state']	= self.DumpState
    h['chk_vfo']	= self.ChkVfo	# Thanks to Franco Spinelli, IW2DHW
    h['get_freq']	= self.GetFreq
    h['set_freq']	= self.SetFreq
    h['get_info']	= self.GetInfo
    h['get_mode']	= self.GetMode
    h['set_mode']	= self.SetMode
    h['get_vfo']	= self.GetVfo
    h['get_ptt']	= self.GetPtt
    h['set_ptt']	= self.SetPtt
    h['get_split_freq']	= self.GetSplitFreq
    h['set_split_freq']	= self.SetSplitFreq
    h['get_split_vfo']	= self.GetSplitVfo
    h['set_split_vfo']	= self.SetSplitVfo
  def Send(self, text):
    """Send text back to the client."""
    try:
      self.sock.sendall(text)
    except socket.error:
      self.sock.close()
      self.sock = None
  def Reply(self, *args):	# args is name, value, name, value, ..., int
    """Create a string reply of name, value pairs, and an ending integer code."""
    if self.extended:			# Use extended format
      t = "%s:" % self.cmd		# Extended format echoes the command and parameters
      for param in self.params:
        t = "%s %s" % (t, param)
      t += self.extended
      for i in range(0, len(args) - 1, 2):
        t = "%s%s: %s%c" % (t, args[i], args[i+1], self.extended)
      t += "RPRT %d\n" % args[-1]
    elif len(args) > 1:		# Use simple format
      t = ''
      for i in range(1, len(args) - 1, 2):
        t = "%s%s\n" % (t, args[i])
    else:		# No names; just the required integer code
      t = "RPRT %d\n" % args[0]
    # print 'Reply', t
    self.Send(t)
  def ErrParam(self):		# Invalid parameter
    self.Reply(-1)
  def UnImplemented(self):	# Command not implemented
    self.Reply(-4)
  def ErrProtocol(self):	# Protocol error
    self.Reply(-8)
  def Process(self):
    """This is the main processing loop, and is called frequently.  It reads and satisfies requests."""
    if not self.sock:
      return 0
    try:	# Read any data from the socket
      text = self.sock.recv(1024)
    except socket.timeout:	# This does not work
      pass
    except socket.error:	# Nothing to read
      pass
    else:					# We got some characters
      self.received += text
    if '\n' in self.received:	# A complete command ending with newline is available
      cmd, self.received = self.received.split('\n', 1)	# Split off the command, save any further characters
    else:
      return 1
    cmd = cmd.strip()		# Here is our command
    # print 'Get', cmd
    if not cmd:			# ??? Indicates a closed connection?
      # print 'empty command'
      self.sock.close()
      self.sock = None
      return 0
    # Parse the command and call the appropriate handler
    if cmd[0] == '+':			# rigctld Extended Response Protocol
      self.extended = '\n'
      cmd = cmd[1:].strip()
    elif cmd[0] in ';|,':		# rigctld Extended Response Protocol
      self.extended = cmd[0]
      cmd = cmd[1:].strip()
    else:
      self.extended = None
    if cmd[0:1] == '\\':		# long form command starting with backslash
      args = cmd[1:].split()
      self.cmd = args[0]
      self.params = args[1:]
      self.Handlers.get(self.cmd, self.UnImplemented)()
    else:						# single-letter command
      self.params = cmd[1:].strip()
      cmd = cmd[0:1]
      if cmd in 'Qq':	# Quit command
        return 0
      try:
        t = self.SingleLetters[cmd.lower()]
      except KeyError:
        self.UnImplemented()
      else:
        if cmd in string.uppercase:
          self.cmd = 'set_' + t
        else:
          self.cmd = 'get_' + t
        self.Handlers.get(self.cmd, self.UnImplemented)()
    return 1
  # These are the handlers for each request
  def DumpState(self):
    self.Send(self.dump2)
  def ChkVfo(self):
    self.Send('CHKVFO 0')
  def GetFreq(self):
    self.Reply('Frequency', self.app.rxFreq + self.app.VFO, 0)
  def SetFreq(self):
    try:
      freq = float(self.params)
      self.Reply(0)
    except:
      self.ErrParam()
    else:
      freq = int(freq + 0.5)
      self.app.ChangeRxTxFrequency(freq, None)
  def GetSplitFreq(self):
    self.Reply('TX Frequency', self.app.txFreq + self.app.VFO, 0)
  def SetSplitFreq(self):
    try:
      freq = float(self.params)
      self.Reply(0)
    except:
      self.ErrParam()
    else:
      freq = int(freq + 0.5)
      if self.app.split_rxtx and not self.app.split_hamlib_tx:
        self.app.ChangeRxTxFrequency(freq, None)
      else:
        self.app.ChangeRxTxFrequency(None, freq)
  def GetSplitVfo(self):
    # I am not sure if "VFO" is a suitable response
    if self.app.split_rxtx:
      self.Reply('Split', 1, 'TX VFO', 'VFO', 0)
    else:
      self.Reply('Split', 0, 'TX VFO', 'VFO', 0)
  def SetSplitVfo(self):
    # Currently (Aug 2012) hamlib fails to send the "split" parameter, so this fails
    try:
      split, vfo = self.params.split()
      split = int(split)
      self.Reply(0)
    except:
      # traceback.print_exc()
      self.ErrParam()
    else:
      self.app.splitButton.SetValue(split, True)
  def GetInfo(self):
    self.Reply("Info", self.app.main_frame.title, 0)
  def GetMode(self):
    mode = self.app.mode
    if mode == 'CWU':
      mode = 'CW'
    elif mode == 'CWL':		# Is this what CWR means?
      mode = 'CWR'
    elif mode == 'DGT-FM':
      mode = 'FM'
    elif mode[0:4] == 'DGT-':
      mode = 'USB'
    self.Reply('Mode', mode, 'Passband', self.app.filter_bandwidth, 0)
  def SetMode(self):
    try:
      mode, bw = self.params.split()
      bw = int(float(bw) + 0.5)
    except:
      self.ErrParam()
      return
    if mode in ('USB', 'LSB', 'AM', 'FM'):
      self.Reply(0)
    elif mode[0:4] == 'DGT-':
      self.Reply(0)
    elif mode == 'CW':
      mode = 'CWU'
      self.Reply(0)
    elif mode == 'CWR':
      mode = 'CWL'
      self.Reply(0)
    else:
      self.ErrParam()
      return
    self.app.OnBtnMode(None, mode)		# Set mode
    if bw <= 0:		# use default bandwidth
      return
    # Choose button closest to requested bandwidth
    buttons = self.app.filterButns.GetButtons()
    Lab = buttons[0].GetLabel()
    diff = abs(int(Lab) - bw)
    for i in range(1, len(buttons) - 1):
      label = buttons[i].GetLabel()
      df = abs(int(label) - bw)
      if df < diff:
        Lab = label
        diff = df
    self.app.OnBtnFilter(None, int(Lab))
  def GetVfo(self):
    self.Reply('VFO', "VFO", 0)		# The type of VFO we have
  def GetPtt(self):
    if QS.is_key_down():
      self.Reply('PTT', 1, 0)
    else:
      self.Reply('PTT', 0, 0)
  def SetPtt(self):
    if not self.app.pttButton:
      self.UnImplemented()
      return
    try:
      ptt = int(self.params)
      self.Reply(0)
    except:
      self.ErrParam()
    else:
      self.app.pttButton.SetValue(ptt, True)

class SoundThread(threading.Thread):
  """Create a second (non-GUI) thread to read, process and play sound."""
  def __init__(self):
    self.do_init = 1
    threading.Thread.__init__(self)
    self.doQuit = threading.Event()
    self.doQuit.clear()
  def run(self):
    """Read, process, play sound; then notify the GUI thread to check for FFT data."""
    if self.do_init:	# Open sound using this thread
      self.do_init = 0
      QS.start_sound()
      wx.CallAfter(application.PostStartup)
    while not self.doQuit.isSet():
      QS.read_sound()
      wx.CallAfter(application.OnReadSound)
    QS.close_sound()
  def stop(self):
    """Set a flag to indicate that the sound thread should end."""
    self.doQuit.set()

class ConfigScreen(wx.Panel):
  """Display a notebook with status and configuration data"""
  def __init__(self, parent, width, fft_size):
    self.y_scale = 0
    self.y_zero = 0
    self.finish_pages = True
    self.width = width
    wx.Panel.__init__(self, parent)
    self.notebook = notebook = wx.Notebook(self)
    font = wx.Font(conf.config_font_size, wx.FONTFAMILY_SWISS, wx.NORMAL,
          wx.FONTWEIGHT_NORMAL, False, conf.quisk_typeface)
    notebook.SetFont(font)
    sizer = wx.BoxSizer()
    sizer.Add(notebook, 1, wx.EXPAND)
    self.SetSizer(sizer)
    # create the page windows
    self.status = ConfigStatus(notebook, width, fft_size)
    self.SetBackgroundColour(self.status.bg_color)
    self.SetForegroundColour(self.status.tfg_color)
    notebook.bg_color = self.status.bg_color
    notebook.tfg_color = self.status.tfg_color
    notebook.AddPage(self.status, "Status")
    self.config = ConfigConfig(notebook, width)
    notebook.AddPage(self.config, "Config")
    self.sound = ConfigSound(notebook, width)
    notebook.AddPage(self.sound, "Sound")
    self.favorites = ConfigFavorites(notebook, width)
    notebook.AddPage(self.favorites, "Favorites")
    self.tx_audio = ConfigTxAudio(notebook, width)
    notebook.AddPage(self.tx_audio, "Tx Audio")
    self.tx_audio.status = self.status
  def FinishPages(self):
    if self.finish_pages:
      self.finish_pages = False
      application.local_conf.AddPages(self.notebook, self.width)
  def ChangeYscale(self, y_scale):
    pass
  def ChangeYzero(self, y_zero):
    pass
  def OnIdle(self, event):
    pass
  def SetTxFreq(self, tx_freq, rx_freq):
    pass
  def OnGraphData(self, data=None):
    self.status.OnGraphData(data)
    self.tx_audio.OnGraphData(data)
  def InitBitmap(self):		# Initial construction of bitmap
    self.status.InitBitmap()

class ConfigStatus(wx.ScrolledWindow):
  """Display the status screen."""
  def __init__(self, parent, width, fft_size):
    wx.ScrolledWindow.__init__(self, parent)
    self.Bind(wx.EVT_PAINT, self.OnPaint)
    self.bg_color = self.GetBackgroundColour()
    self.tfg_color = wx.Colour(20, 20, 20)	# use for text foreground
    self.width = width
    self.fft_size = fft_size
    self.scroll_height = None
    self.interupts = 0
    self.read_error = -1
    self.write_error = -1
    self.underrun_error = -1
    self.fft_error = -1
    self.latencyCapt = -1
    self.latencyPlay = -1
    self.y_scale = 0
    self.y_zero = 0
    self.rate_min = -1
    self.rate_max = -1
    self.chan_min = -1
    self.chan_max = -1
    self.mic_max_display = 0
    self.err_msg = "No response"
    self.msg1 = ""
    self.font = wx.Font(conf.status_font_size, wx.FONTFAMILY_SWISS, wx.NORMAL,
          wx.FONTWEIGHT_NORMAL, False, conf.quisk_typeface)
    if wxVersion in ('2', '3'):
      self.SetBackgroundStyle(wx.BG_STYLE_CUSTOM)
    else:
      self.SetBackgroundStyle(wx.BG_STYLE_PAINT)
    self.SetFont(self.font)
    charx = self.charx = self.GetCharWidth()
    chary = self.chary = self.GetCharHeight()
    self.dy = chary		# line spacing
    self.rjustify1 = (0, 1, 0)
    self.tabstops1 = [0] * 3
    self.tabstops1[0] = x = charx
    self.tabstops1[1] = x = x + self.GetTextExtent("FFT number of errors 1234567890")[0]
    self.tabstops1[2] = x = x + self.GetTextExtent("XXXX")[0]
    self.rjustify2 = (0, 0, 1, 1, 1)
    self.tabstops2 = []
  def MakeTabstops(self):
    luse = lname = 0
    for use, name, rate, latency, errors in QS.sound_errors():
      name = self.TrimName(name)
      w, h = self.GetTextExtent(use)
      luse = max(luse, w)
      w, h = self.GetTextExtent(name)
      lname = max(lname, w)
    if luse == 0:
      return
    charx = self.charx
    self.tabstops2 = [0] * 5
    self.tabstops2[0] = x = charx
    self.tabstops2[1] = x = x + luse + charx * 6
    self.tabstops2[2] = x = x + lname + self.GetTextExtent("Sample rateXXXXXX")[0]
    self.tabstops2[3] = x = x + charx * 12
    self.tabstops2[4] = x = x + charx * 12
  def TrimName(self, name):
    if len(name) > 50:
      name = name[0:30] + '|||' + name[-17:]
    return name
  def OnPaint(self, event):
    # Make and blit variable data
    self.MakeBitmap()
    dc = wx.AutoBufferedPaintDC(self)
    x, y = self.GetViewStart()
    dc.Blit(0, 0, self.mem_width, self.mem_height, self.mem_dc, x, y)
  def MakeRow2(self, *args):
    for col in range(len(args)):
      t = args[col]
      if t is None:
        continue
      t = str(t)
      x = self.tabstops[col]
      if self.rjustify[col]:
        w, h = self.mem_dc.GetTextExtent(t)
        x -= w
      if ("Error" in t or "Stream error" in t) and t != "Errors":
        self.mem_dc.SetTextForeground('Red')
        self.mem_dc.DrawText(t, x, self.mem_y)
        self.mem_dc.SetTextForeground(self.tfg_color)
      else:
        self.mem_dc.DrawText(t, x, self.mem_y)
    self.mem_y += self.dy
  def InitBitmap(self):		# Initial construction of bitmap
    self.mem_height = application.screen_height
    self.mem_width = application.screen_width
    self.bitmap = EmptyBitmap(self.mem_width, self.mem_height)
    self.mem_dc = wx.MemoryDC()
    self.mem_rect = wx.Rect(0, 0, self.mem_width, self.mem_height)
    self.mem_dc.SelectObject(self.bitmap)
    br = wx.Brush(self.bg_color)
    self.mem_dc.SetBackground(br)
    self.mem_dc.SetFont(self.font)
    self.mem_dc.SetTextForeground(self.tfg_color)
    self.mem_dc.Clear()
  def MakeBitmap(self):
    self.mem_dc.Clear()
    self.mem_y = self.charx
    self.tabstops = self.tabstops1
    self.rjustify = self.rjustify1
    if conf.config_file_exists:
      cfile = "Configuration file:  %s" % conf.config_file_path
    else:
      cfile = "Configuration file not found %s" % conf.config_file_path
    if conf.microphone_name:
      level = "%3.0f" % self.mic_max_display
    else:
      level = "None"
    if self.err_msg:
      err_msg = self.err_msg
    else:
      err_msg = None
    self.MakeRow2("Sample interrupts", self.interupts, cfile)
    self.MakeRow2("Microphone or DGT level dB", level, application.config_text)
    self.MakeRow2("FFT number of points", self.fft_size, err_msg)
    if conf.dxClHost:		# connection to dx cluster
      nSpots = len(application.dxCluster.dxSpots)
      if nSpots > 0:
        msg = str(nSpots) + ' DX spot' + ('' if nSpots==1 else 's') + ' received from ' + application.dxCluster.getHost()
      else:
        msg = "No DX Cluster data from %s" % conf.dxClHost
      self.MakeRow2("FFT number of errors", self.fft_error, msg)
    else:
      self.MakeRow2("FFT number of errors", self.fft_error)
    self.mem_y += self.dy
    if not self.tabstops2:
      return
    self.tabstops = self.tabstops2
    self.rjustify = self.rjustify2
    self.font.SetUnderlined(True)
    self.mem_dc.SetFont(self.font)
    self.MakeRow2("Device", "Name", "Sample rate", "Latency", "Errors")
    self.font.SetUnderlined(False)
    self.mem_dc.SetFont(self.font)
    self.mem_y += self.dy * 3 // 10
    if conf.use_sdriq:
      self.MakeRow2("Capture radio samples", "SDR-IQ", application.sample_rate, self.latencyCapt, self.read_error)
    elif conf.use_rx_udp:
      self.MakeRow2("Capture radio samples", "UDP", application.sample_rate, self.latencyCapt, self.read_error)
    elif conf.use_soapy:
      self.MakeRow2("Capture radio samples", "SoapySDR", application.sample_rate, self.latencyCapt, self.read_error)
    for use, name, rate, latency, errors in QS.sound_errors():
      self.MakeRow2(use, self.TrimName(name), rate, latency, errors)
    if self.scroll_height is None:
      self.scroll_height = self.mem_y + self.dy
      self.SetScrollbars(1, 1, 100, self.scroll_height)
  def OnGraphData(self, data=None):
    if not self.tabstops2:      # Must wait for sound to start
      self.MakeTabstops()
    (self.rate_min, self.rate_max, sample_rate, self.chan_min, self.chan_max,
         self.msg1, self.unused, self.err_msg,
         self.read_error, self.write_error, self.underrun_error,
         self.latencyCapt, self.latencyPlay, self.interupts, self.fft_error, self.mic_max_display,
         self.data_poll_usec
     ) = QS.get_state()
    self.mic_max_display = 20.0 * math.log10((self.mic_max_display + 1) / 32767.0)
    self.RefreshRect(self.mem_rect)

class ConfigConfig(wx.ScrolledWindow):
  def __init__(self, parent, width):
    wx.ScrolledWindow.__init__(self, parent)
    self.width = width
    self.font = wx.Font(conf.config_font_size, wx.FONTFAMILY_SWISS, wx.NORMAL,
          wx.FONTWEIGHT_NORMAL, False, conf.quisk_typeface)
    self.SetFont(self.font)
    self.SetBackgroundColour(parent.bg_color)
    self.charx = charx = self.GetCharWidth()
    self.chary = chary = self.GetCharHeight()
    self.dy = self.chary
    self.rx_phase = None
    self.radio_group = None
    # Make controls FIRST column
    tab0 = charx * 4
    # Receive phase
    rx = wx.StaticText(self, -1, "Adjust receive amplitude and phase")
    tx = wx.StaticText(self, -1, "Adjust transmit amplitude and phase")
    x1, y1 = tx.GetSize().Get()
    self.rx_phase = ctrl = QuiskPushbutton(self, self.OnBtnPhase, "Rx Phase...")
    ctrl.SetColorGray()
    if not conf.name_of_sound_capt:
      ctrl.Enable(0)
    x2, y2 = ctrl.GetSize().Get()
    tab1 = tab0 + x1 + charx * 2
    tab2 = tab1 + x2
    tab3 = tab2 + charx * 8
    self.y = self.yyy = y2 + self.chary
    self.dy = y2 * 12 // 10
    self.offset = (y2 - y1) // 2
    rx.SetPosition((tab0, self.y))
    ctrl.SetPosition((tab1, self.y - self.offset))
    self.y += self.dy
    # Transmit phase
    self.tx_phase = ctrl = QuiskPushbutton(self, self.OnBtnPhase, "Tx Phase...")
    ctrl.SetColorGray()
    if not conf.name_of_mic_play:
      ctrl.Enable(0)
    tx.SetPosition((tab0, self.y))
    ctrl.SetPosition((tab1, self.y - self.offset))
    self.y += self.dy
    # Choice (combo) box for decimation
    lst = Hardware.VarDecimGetChoices()
    if lst:
      txt = Hardware.VarDecimGetLabel()
      index = Hardware.VarDecimGetIndex()
    else:
      txt = "Variable decimation"
      lst = ["None"]
      index = 0
    t = wx.StaticText(self, -1, txt)
    ctrl = wx.Choice(self, -1, choices=lst, size=(x2, y2))
    if lst:
      self.Bind(wx.EVT_CHOICE, application.OnBtnDecimation, ctrl)
      ctrl.SetSelection(index)
    t.SetPosition((tab0, self.y))
    ctrl.SetPosition((tab1, self.y - self.offset))
    self.y += self.dy
    # Transmit level controls
    if hasattr(Hardware, "SetTxLevel"):
      SliderBoxH(self, "Tx level %d%%  ", 100, 0, 100, self.OnTxLevel, True, (tab0, self.y), tab2-tab0)
      self.y += self.dy
      level = conf.digital_tx_level
      SliderBoxH(self, "Digital Tx level %d%%  ", level, 0, level, self.OnDigitalTxLevel, True, (tab0, self.y), tab2-tab0)
      self.y += self.dy
    # mic_out_volume
    if conf.name_of_mic_play:
      level = int(conf.mic_out_volume * 100.0 + 0.1)
      SliderBoxH(self, "SftRock Tx level %d%%  ", level, 0, 100, self.OnSrTxLevel, True, (tab0, self.y), tab2-tab0)
      self.y += self.dy
    self.scroll_height = self.y
    #### Make controls SECOND column
    self.y = self.yyy
    self.tab3 = tab3
    self.charx = charx
    ## Record buttons
    self.st = st = wx.StaticText(self, -1, "The file-record button will:", pos=(tab3 - charx * 2, self.y))
    self.dy = st.GetSize().GetHeight() * 14 // 10
    self.y += self.dy
    # File for recording speaker audio
    text = "Record Rx audio to WAV file "
    path = conf.file_name_audio
    self.file_button_rec_speaker = self.MakeFileButton(text, path, 0)
    # File for recording samples
    text = "Record I/Q samples to WAV file "
    path = conf.file_name_samples
    self.file_button_rec_iq = self.MakeFileButton(text, path, 1)
    # File for recording the microphone
    text = "Record the mic to make a CQ message"
    path = ''
    self.file_button_rec_mic = self.MakeFileButton(text, path, 2)
    ## Play buttons
    wx.StaticText(self, -1, "The file-play button will:", pos=(tab3 - charx * 2, self.y))
    self.y += self.dy
    # File for playing speaker audio
    text = "Play Rx audio from a WAV file"
    path = ''
    self.file_button_play_speaker = self.MakeFileButton(text, path, 10)
    # file for playing samples
    text = "Receive saved I/Q samples from a file"
    path = ''
    self.file_button_play_iq = self.MakeFileButton(text, path, 11)
    # File for playing a file to the mic input for a CQ message
    text = "Repeat a CQ message until a station answers"
    path = conf.file_name_playback
    self.file_button_play_mic = self.MakeFileButton(text, path, 12)
    SliderBoxH(self, "Repeat secs %.1f  ", 0, 0, 100, self.OnPlayFileRepeat, True, (tab3 + charx * 4, self.y), tab2-tab0, 0.1)
    self.y += self.dy
    if self.y > self.scroll_height:
      self.scroll_height = self.y
    self.SetScrollbars(1, 1, 100, self.scroll_height)
  def MakeFileButton(self, text, path, index):
    if index < 10:	# record buttons
      cb = wx.CheckBox(self, -1, text, pos=(self.tab3, self.y))
      self.Bind(wx.EVT_CHECKBOX, self.OnCheckRecPlay, cb)
    elif self.radio_group:
      cb = wx.RadioButton(self, -1, text, pos=(self.tab3, self.y))
      self.Bind(wx.EVT_RADIOBUTTON, self.OnCheckRecPlay, cb)
    else:
      self.radio_group = True
      cb = wx.RadioButton(self, -1, text, pos=(self.tab3, self.y), style=wx.RB_GROUP)
      self.Bind(wx.EVT_RADIOBUTTON, self.OnCheckRecPlay, cb)
    x = self.tab3 + cb.GetSize().GetWidth()
    bsz = wx.Size(self.charx * 3, cb.GetSize().GetHeight())
    b = wx.Button(self, -1, "...", pos=(x, self.y), size=bsz)
    b.check_box = cb
    b.index = cb.index = index
    b.path = cb.path = path
    QS.set_file_name(b.index, name=path, enable=0)
    self.Bind(wx.EVT_BUTTON, self.OnBtnFileName, b)
    x = x + b.GetSize().GetWidth() + self.charx
    dddy = (cb.GetSize().GetHeight() - self.st.GetSize().GetHeight()) // 2
    if not path:
      cb.Enable(False)
      path = "(No file)"
    b.txt_ctrl = wx.StaticText(self, -1, path, pos=(x, self.y + dddy))
    self.y += self.dy
    return b
  def OnTxLevel(self, event):
    application.tx_level = event.GetEventObject().GetValue()
    Hardware.SetTxLevel()
  def OnSrTxLevel(self, event):
    level = event.GetEventObject().GetValue()
    QS.set_mic_out_volume(level)
  def OnDigitalTxLevel(self, event):
    application.digital_tx_level = event.GetEventObject().GetValue()
    Hardware.SetTxLevel()
  def OnBtnPhase(self, event):
    btn = event.GetEventObject()
    if btn.GetLabel()[0:2] == 'Tx':
      rx_tx = 'tx'
    else:
      rx_tx = 'rx'
    application.screenBtnGroup.SetLabel('Graph', do_cmd=True)
    if application.w_phase:
      application.w_phase.Raise()
    else:
      application.w_phase = QAdjustPhase(self, self.width, rx_tx)
  def OnBtnFileName(self, event):
    btn = event.GetEventObject()
    dr, fn = os.path.split(btn.path)
    if btn.index < 10:	# record buttons
      dlg = wx.FileDialog(self, 'Choose WAV file', dr, fn, style=wx.FD_SAVE|wx.FD_OVERWRITE_PROMPT, wildcard="Wave files (*.wav)|*.wav")
    else:
      dlg = wx.FileDialog(self, 'Choose WAV file', dr, fn, style=wx.FD_OPEN, wildcard="Wave files (*.wav)|*.wav")
    if dlg.ShowModal() == wx.ID_OK:
      path = dlg.GetPath()
      if path[-4:].lower() != '.wav':
        path = path + '.wav'
      QS.set_file_name(btn.index, name=path)
      btn.txt_ctrl.SetLabel(path)
      btn.path = path
      btn.check_box.path = path
      btn.check_box.Enable(True)
      if btn.index >= 10:	# play buttons
        btn.check_box.SetValue(True)
        application.file_play_source = btn.index
        QS.set_file_name(btn.index, enable=1)
        QS.open_wav_file_play(path)
      self.EnableRecPlay()
    dlg.Destroy()
  def EnableRecPlay(self):
    enable_rec = (self.file_button_rec_speaker.check_box.GetValue() or
        self.file_button_rec_iq.check_box.GetValue() or
        self.file_button_rec_mic.check_box.GetValue())
    enable_play = ((self.file_button_play_speaker.path and self.file_button_play_speaker.check_box.GetValue()) or
        self.file_button_play_iq.check_box.GetValue() or
        self.file_button_play_mic.check_box.GetValue())
    application.btn_file_record.Enable(enable_rec)
    application.btnFilePlay.Enable(enable_play)
  def OnCheckRecPlay(self, event):
    btn = event.GetEventObject()
    if btn.GetValue():
      if btn.index >= 10:	# play button
        QS.open_wav_file_play(btn.path)
        application.file_play_source = btn.index
      QS.set_file_name(btn.index, enable=1)
    else:
      QS.set_file_name(btn.index, enable=0)
    self.EnableRecPlay()
  def OnPlayFileRepeat(self, event):
    application.file_play_repeat = event.GetEventObject().GetValue() * 0.1

class ConfigSound(wx.ScrolledWindow):
  """Display the available sound devices."""
  def __init__(self, parent, width):
    wx.ScrolledWindow.__init__(self, parent)
    self.Bind(wx.EVT_PAINT, self.OnPaint)
    self.width = width
    self.dev_capt, self.dev_play = QS.sound_devices()
    self.tfg_color = parent.tfg_color
    self.font = wx.Font(conf.config_font_size, wx.FONTFAMILY_SWISS, wx.NORMAL,
          wx.FONTWEIGHT_NORMAL, False, conf.quisk_typeface)
    self.SetFont(self.font)
    self.SetBackgroundColour(parent.bg_color)
    self.charx = self.GetCharWidth()
    self.chary = self.GetCharHeight()
    self.dy = self.chary
    height = self.chary * (3 + len(self.dev_capt) + len(self.dev_play))
    if sys.platform != 'win32' and conf.show_pulse_audio_devices:
      height += self.chary * (3 + 3 * len(application.pa_dev_capt) + 3 * len(application.pa_dev_play))
    self.SetScrollbars(1, 1, 100, height)
  def OnPaint(self, event):
    dc = wx.PaintDC(self)
    dc.Clear()
    self.DoPrepareDC(dc)
    dc.SetFont(self.font)
    dc.SetTextForeground(self.tfg_color)
    x0 = self.charx
    self.y = self.chary // 3
    dc.DrawText("Available devices for capture:", x0, self.y)
    self.y += self.dy
    for name in self.dev_capt:
      dc.DrawText('    ' + name, x0, self.y)
      self.y += self.dy
    dc.DrawText("Available devices for playback:", x0, self.y)
    self.y += self.dy
    for name in self.dev_play:
      dc.DrawText('    ' + name, x0, self.y)
      self.y += self.dy
    if sys.platform != 'win32' and conf.show_pulse_audio_devices:
      dc.DrawText("Available PulseAudio devices for capture (sources):", x0, self.y)
      self.y += self.dy
      for n0, n1, n2 in application.pa_dev_capt:
        dc.DrawText(' ' * 4 + n1, x0, self.y)
        self.y += self.dy
        dc.DrawText(' ' * 8 + n0, x0, self.y)
        self.y += self.dy
        if n2:
          dc.DrawText(' ' * 8 + n2, x0, self.y)
          self.y += self.dy
      dc.DrawText("Available PulseAudio devices for playback (sinks):", x0, self.y)
      self.y += self.dy
      for n0, n1, n2 in application.pa_dev_play:
        dc.DrawText(' ' * 4 + n1, x0, self.y)
        self.y += self.dy
        dc.DrawText(' ' * 8 + n0, x0, self.y)
        self.y += self.dy
        if n2:
          dc.DrawText(' ' * 8 + n2, x0, self.y)
          self.y += self.dy

class ConfigFavorites(wx.grid.Grid):
  def __init__(self, parent, width):
    wx.grid.Grid.__init__(self, parent)
    self.changed = False
    self.RepeaterDict = {}
    font = wx.Font(conf.favorites_font_size, wx.FONTFAMILY_SWISS, wx.NORMAL,
          wx.FONTWEIGHT_BOLD, False, conf.quisk_typeface)
    self.SetFont(font)
    self.SetBackgroundColour(parent.bg_color)
    self.SetLabelFont(font)
    font = wx.Font(conf.favorites_font_size, wx.FONTFAMILY_SWISS, wx.NORMAL,
          wx.FONTWEIGHT_NORMAL, False, conf.quisk_typeface)
    self.SetDefaultCellFont(font)
    self.SetDefaultRowSize(self.GetCharHeight()+3)
    self.Bind(wx.grid.EVT_GRID_LABEL_RIGHT_CLICK, self.OnRightClickLabel)
    self.Bind(wx.grid.EVT_GRID_LABEL_LEFT_CLICK, self.OnLeftClickLabel)
    if wxVersion in ('2', '3'):
      self.Bind(wx.grid.EVT_GRID_CELL_CHANGE, self.OnChange)    # wxPython 3
    else:
      self.Bind(wx.grid.EVT_GRID_CELL_CHANGED, self.OnChange)   # wxPython 4
    self.Bind(wx.grid.EVT_GRID_LABEL_LEFT_DCLICK, self.OnLeftDClick)
    self.CreateGrid(0, 6)
    self.EnableDragRowSize(False)
    w = self.GetTextExtent(' 999 ')[0]
    self.SetRowLabelSize(w)
    self.SetColLabelValue(0,  'Name')
    self.SetColLabelValue(1,  'Freq MHz')
    self.SetColLabelValue(2,  'Mode')	# This column has a choice editor
    self.SetColLabelValue(3,  'Description')
    self.SetColLabelValue(4,  'Offset kHz')
    self.SetColLabelValue(5,  'Tone Hz')
    w = self.GetTextExtent("xFrequencyx")[0]
    self.SetColSize(0, w * 3 // 2)
    self.SetColSize(1, w)
    self.SetColSize(4, w)
    self.SetColSize(5, w)
    self.SetColSize(2, w)
    ww = width - w * 7 - self.GetRowLabelSize() - 20
    if ww < w:
      ww = w
    self.SetColSize(3, ww)
    if conf.favorites_file_path:
      self.init_path = conf.favorites_file_path
    else:
      self.init_path = os.path.join(os.path.dirname(ConfigPath), 'quisk_favorites.txt')
    conf.favorites_file_in_use = self.init_path
    self.ReadIn()
    if self.GetNumberRows() < 1:
      self.AppendRows()
    # Make a popup menu
    self.popupmenu = wx.Menu()
    item = self.popupmenu.Append(-1, 'Tune to')
    self.Bind(wx.EVT_MENU, self.OnPopupTuneto, item)
    self.popupmenu.AppendSeparator()
    item = self.popupmenu.Append(-1, 'Append')
    self.Bind(wx.EVT_MENU, self.OnPopupAppend, item)
    item = self.popupmenu.Append(-1, 'Insert')
    self.Bind(wx.EVT_MENU, self.OnPopupInsert, item)
    item = self.popupmenu.Append(-1, 'Delete')
    self.Bind(wx.EVT_MENU, self.OnPopupDelete, item)
    self.popupmenu.AppendSeparator()
    item = self.popupmenu.Append(-1, 'Move Up')
    self.Bind(wx.EVT_MENU, self.OnPopupMoveUp, item)
    item = self.popupmenu.Append(-1, 'Move Down')
    self.Bind(wx.EVT_MENU, self.OnPopupMoveDown, item)
    # Make a timer
    self.timer = wx.Timer(self)
    self.Bind(wx.EVT_TIMER, self.OnTimer)
  def SetModeEditor(self, mode_names):
    self.mode_names = mode_names
    for row in range(self.GetNumberRows()):
      self.SetCellEditor(row, 2, wx.grid.GridCellChoiceEditor(mode_names, True))
  def FormatFloat(self, freq):
    freq = "%.6f" % freq
    for i in range(3):
      if freq[-1] == '0':
        freq = freq[:-1]
      else:
        break
    return freq
  def ReadIn(self):
    try:
      fp = open(self.init_path, 'rb')
      lines = fp.readlines()
      fp.close()
    except:
      lines = ("my net|7210000|LSB|My net 2030 UTC every Thursday",
               "10m FM 1|29.620|FM|Fm local 10 meter repeater")
    for row in range(len(lines)):
      self.AppendRows()
      fields = lines[row].split('|')
      for col in range(len(fields)):
        if col == 1:    # Correct old entries made in Hertz
          freq = fields[1]
          try:
            freq = float(freq)
          except:
            pass
          else:
            if freq > 30000.0:    # Must be in Hertz
              freq *= 1E-6
              fields[1] = self.FormatFloat(freq)
        if col <= 5:
          self.SetCellValue(row, col, fields[col].strip())
    self.MakeRepeaterDict()
  def WriteOut(self):
    ncols = self.GetNumberCols()
    if ncols != 6:
      print ("Bad logic in favorites WriteOut()")
      return
    self.changed = False
    try:
      fp = open(self.init_path, 'wb')
    except:
      return
    for row in range(self.GetNumberRows()):
      out = []
      for col in range(0, ncols):
        cell = self.GetCellValue(row, col)
        cell = cell.replace('|', ';')
        out.append(cell)
      t = "%20s | %10s | %10s | %30s | %10s | %10s\r\n" % tuple(out)
      fp.write(t)
    fp.close()
  def AddNewFavorite(self):
    self.InsertRows(0)
    self.SetCellValue(0, 0, 'New station');
    freq = (application.rxFreq + application.VFO) * 1E-6    # convert to megahertz
    freq = self.FormatFloat(freq)
    self.SetCellValue(0, 1, freq)
    self.SetCellValue(0, 2, application.mode);
    self.SetCellEditor(0, 2, wx.grid.GridCellChoiceEditor(self.mode_names, True))
    self.OnChange()
  def OnRightClickLabel(self, event):
    event.Skip()
    self.menurow = event.GetRow()
    if self.menurow >= 0:
      pos = event.GetPosition()
      self.PopupMenu(self.popupmenu, pos)
  def OnLeftClickLabel(self, event):
    pass
  def OnLeftDClick(self, event):		# Thanks to Christof, DJ4CM
    self.menurow = event.GetRow()
    if self.menurow >= 0:
      self.OnPopupTuneto(event)
  def OnPopupAppend(self, event):
    self.InsertRows(self.menurow + 1)
    self.SetCellEditor(self.menurow + 1, 2, wx.grid.GridCellChoiceEditor(self.mode_names, True))
    self.OnChange()
  def OnPopupInsert(self, event):
    self.InsertRows(self.menurow)
    self.SetCellEditor(self.menurow, 2, wx.grid.GridCellChoiceEditor(self.mode_names, True))
    self.OnChange()
  def OnPopupDelete(self, event):
    self.DeleteRows(self.menurow)
    if self.GetNumberRows() < 1:
      self.AppendRows()
      self.SetCellEditor(0, 2, wx.grid.GridCellChoiceEditor(self.mode_names, True))
    self.OnChange()
  def OnPopupMoveUp(self, event):
    row = self.menurow
    if row < 1:
      return
    for i in range(self.GetNumberCols()):
      c = self.GetCellValue(row - 1, i)
      self.SetCellValue(row - 1, i, self.GetCellValue(row, i))
      self.SetCellValue(row, i, c)
  def OnPopupMoveDown(self, event):
    row = self.menurow
    if row == self.GetNumberRows() - 1:
      return
    for i in range(self.GetNumberCols()):
      c = self.GetCellValue(row + 1, i)
      self.SetCellValue(row + 1, i, self.GetCellValue(row, i))
      self.SetCellValue(row, i, c)
  def OnPopupTuneto(self, event):
    freq = self.GetCellValue(self.menurow, 1)
    if not freq:
      return
    try:
      freq = str2freq (freq)
    except ValueError:
      print('Bad frequency')
      return
    if self.changed:
      if self.timer.IsRunning():
        self.timer.Stop()
      self.WriteOut()
    application.ChangeRxTxFrequency(None, freq)
    mode = self.GetCellValue(self.menurow, 2)
    mode = mode.upper()
    application.OnBtnMode(None, mode)
    application.screenBtnGroup.SetLabel(conf.default_screen, do_cmd=True)
  def MakeRepeaterDict(self):
    self.RepeaterDict = {}
    for row in range(self.GetNumberRows()):
      offset = self.GetCellValue(row, 4)
      offset = offset.strip()
      if not offset:
        continue
      freq = self.GetCellValue(row, 1)
      tone = self.GetCellValue(row, 5)
      tone = tone.strip()
      if not tone:
        tone = '0'
      try:
        offset = float(offset)
        freq = float(freq)
        tone = float(tone)
      except:
        traceback.print_exc()
      else:
        freq = int(freq * 1E6 + 0.5)	# frequency in Hertz
        freq = (freq + 500) // 1000		# frequency in units of 1 kHz
        self.RepeaterDict[freq * 1000] = (offset, tone)
  def OnChange(self, event=None):
    self.MakeRepeaterDict()
    self.changed = True
    if self.timer.IsRunning():
      self.timer.Stop()
    self.timer.Start(5000, oneShot=True)
  def OnTimer(self, event):
    if self.changed:
      self.WriteOut()

class ConfigTxAudio(wx.ScrolledWindow):
  """Display controls for the transmit audio."""
  def __init__(self, parent, width):
    wx.ScrolledWindow.__init__(self, parent)
    self.width = width
    self.font = wx.Font(conf.config_font_size, wx.FONTFAMILY_SWISS, wx.NORMAL,
          wx.FONTWEIGHT_NORMAL, False, conf.quisk_typeface)
    self.SetFont(self.font)
    self.SetBackgroundColour(parent.bg_color)
    self.charx = charx = self.GetCharWidth()
    self.chary = chary = self.GetCharHeight()
    self.tmp_playing = False
    # Make controls
    tab0 = charx * 4
    self.y = chary
    t = "This is a test screen for transmit audio.  SSB, AM and FM have separate settings."
    wx.StaticText(self, -1, t, pos=(tab0, self.y))
    self.btn_record = QuiskCheckbutton(self, self.OnBtnRecord, "Record")
    self.btn_record.SetColorGray()
    x2, y2 = self.btn_record.GetSize().Get()
    self.dy = y2 * 12 // 10
    self.offset = (y2 - chary) // 2
    self.y += self.dy
    # Record and Playback
    ctl = wx.StaticText(self, -1, "Listen to transmit audio", pos=(tab0, self.y))
    x1, y1 = ctl.GetSize().Get()
    x = tab0 + x1 + charx * 3
    y = self.y - self.offset
    self.btn_record.SetPosition((x, y))
    self.btn_playback = QuiskCheckbutton(self, self.OnBtnPlayback, "Playback")
    self.btn_playback.SetColorGray()
    self.btn_playback.SetPosition((x + x2 + charx * 3, y))
    self.btn_playback.Enable(0)
    if not conf.microphone_name:
      self.btn_record.Enable(0)
    tab1 = x + x2
    tab2 = tab1 + charx * 3
    self.y += self.dy
    # mic level
    self.mic_text = wx.StaticText(self, -1, "Peak microphone audio level   None", pos=(tab0, self.y))
    t = "Adjust the peak audio level to a few dB below zero."
    wx.StaticText(self, -1, t, pos=(tab2, self.y))
    self.y += self.dy
    # Vox level
    SliderBoxH(self, "VOX %d dB  ", application.levelVOX, -40, 0, application.OnLevelVOX, True, (tab0, self.y), tab1-tab0)
    t = "Audio level that triggers VOX (all modes)."
    wx.StaticText(self, -1, t, pos=(tab2, self.y))
    self.y += self.dy
    # VOX hang
    SliderBoxH(self, "VOX %0.2f  ", application.timeVOX, 0, 4000, application.OnTimeVOX, True, (tab0, self.y), tab1-tab0, 0.001)
    t = "Time to hold VOX after end of audio in seconds."
    wx.StaticText(self, -1, t, pos=(tab2, self.y))
    self.y += self.dy
    # Tx Audio clipping
    application.CtrlTxAudioClip = SliderBoxH(self, "Clip %2d  ", 0, 0, 20, application.OnTxAudioClip, True, (tab0, self.y), tab1-tab0)
    t = "Tx audio clipping level in dB for this mode."
    wx.StaticText(self, -1, t, pos=(tab2, self.y))
    self.y += self.dy
    # Tx Audio preemphasis
    application.CtrlTxAudioPreemph = SliderBoxH(self, "Preemphasis %4.2f  ", 0, 0, 100, application.OnTxAudioPreemph, True, (tab0, self.y), tab1-tab0, 0.01)
    t = "Tx audio preemphasis of high frequencies."
    wx.StaticText(self, -1, t, pos=(tab2, self.y))
    self.y += self.dy
    self.SetScrollbars(1, 1, 100, self.y)
  def OnGraphData(self, data=None):
    if conf.microphone_name:
      txt = "Peak microphone audio level %3.0f dB" % self.status.mic_max_display
      self.mic_text.SetLabel(txt)
    if self.tmp_playing and QS.set_record_state(-1):	# poll to see if playback is finished
      self.tmp_playing = False
      self.btn_playback.SetValue(False)
      self.btn_record.Enable(1)
  def OnBtnRecord(self, event):
    if event.GetEventObject().GetValue():
      QS.set_kill_audio(1)
      self.btn_playback.Enable(0)
      QS.set_record_state(4)
    else:
      QS.set_kill_audio(0)
      self.btn_playback.Enable(1)
      QS.set_record_state(1)
  def OnBtnPlayback(self, event):
    if event.GetEventObject().GetValue():
      self.btn_record.Enable(0)
      QS.set_record_state(2)
      self.tmp_playing = True
    else:
      self.btn_record.Enable(1)
      QS.set_record_state(3)
      self.tmp_playing = False

class GraphDisplay(wx.Window):
  """Display the FFT graph within the graph screen."""
  def __init__(self, parent, x, y, graph_width, height, chary):
    wx.Window.__init__(self, parent,
       pos = (x, y),
       size = (graph_width, height),
       style = wx.NO_BORDER)
    self.parent = parent
    self.chary = chary
    self.graph_width = graph_width
    self.display_text = ""
    self.line = [(0, 0), (1,1)]		# initial fake graph data
    self.SetBackgroundColour(conf.color_graph)
    self.Bind(wx.EVT_PAINT, self.OnPaint)
    self.Bind(wx.EVT_LEFT_DOWN, parent.OnLeftDown)
    self.Bind(wx.EVT_RIGHT_DOWN, parent.OnRightDown)
    self.Bind(wx.EVT_LEFT_UP, parent.OnLeftUp)
    self.Bind(wx.EVT_MOTION, parent.OnMotion)
    self.Bind(wx.EVT_MOUSEWHEEL, parent.OnWheel)
    self.tune_tx = graph_width // 2	# Current X position of the Tx tuning line
    self.tune_rx = 0				# Current X position of Rx tuning line or zero
    self.scale = 20				# pixels per 10 dB
    self.peak_hold = 9999		# time constant for holding peak value
    self.height = 10
    self.y_min = 1000
    self.y_max = 0
    self.max_height = application.screen_height
    self.backgroundPen = wx.Pen(self.GetBackgroundColour(), 1)
    self.tuningPenTx = wx.Pen(conf.color_txline, 1)
    self.tuningPenRx = wx.Pen(conf.color_rxline, 1)
    self.backgroundBrush = wx.Brush(self.GetBackgroundColour())
    self.filterBrush = wx.Brush(conf.color_bandwidth, wx.SOLID)
    self.horizPen = wx.Pen(conf.color_gl, 1, wx.SOLID)
    self.font = wx.Font(conf.graph_msg_font_size, wx.FONTFAMILY_SWISS, wx.NORMAL,
          wx.FONTWEIGHT_NORMAL, False, conf.quisk_typeface)
    self.SetFont(self.font)
    if sys.platform == 'win32':
      self.Bind(wx.EVT_ENTER_WINDOW, self.OnEnter)
    if wxVersion in ('2', '3'):
      self.SetBackgroundStyle(wx.BG_STYLE_CUSTOM)
    else:
      self.SetBackgroundStyle(wx.BG_STYLE_PAINT)
  def OnEnter(self, event):
    if not application.w_phase:
      self.SetFocus()	# Set focus so we get mouse wheel events
  def OnPaint(self, event):
    #print 'GraphDisplay', self.GetUpdateRegion().GetBox()
    dc = wx.AutoBufferedPaintDC(self)
    dc.Clear()
    # Draw the tuning line and filter display to the screen.
    # If self.tune_rx is zero, draw the Rx filter at the Tx tuning line. There is no separate Rx display.
    # Otherwise draw both an Rx and Tx tuning display.
    self.DrawFilter(dc)
    dc.SetPen(wx.Pen(conf.color_graphline, 1))
    dc.DrawLines(self.line)
    dc.SetPen(self.horizPen)
    for y in self.parent.y_ticks:
      dc.DrawLine(0, y, self.graph_width, y)	# y line
    if self.display_text:
      dc.SetFont(self.font)
      dc.SetTextBackground(conf.color_graph_msg_bg)
      dc.SetTextForeground(conf.color_graph_msg_fg)
      dc.SetBackgroundMode(wx.SOLID)
      dc.DrawText(self.display_text, 0, 0)
  def DrawFilter(self, dc):
    dc.SetPen(wx.TRANSPARENT_PEN)
    dc.SetLogicalFunction(wx.COPY)
    scale = 1.0 / self.parent.zoom / self.parent.sample_rate * self.graph_width
    dc.SetBrush(self.filterBrush)
    if self.tune_rx:
      x, w, rit = self.parent.GetFilterDisplayXWR(rx_filters=False)
      dc.DrawRectangle(self.tune_tx + x, 0, w, self.height)
      x, w, rit = self.parent.GetFilterDisplayXWR(rx_filters=True)
      dc.DrawRectangle(self.tune_rx + rit + x, 0, w, self.height)
      dc.SetPen(self.tuningPenRx)
      dc.DrawLine(self.tune_rx, 0, self.tune_rx, self.height)
    else:
      x, w, rit = self.parent.GetFilterDisplayXWR(rx_filters=True)
      dc.DrawRectangle(self.tune_tx + rit + x, 0, w, self.height)
    dc.SetPen(self.tuningPenTx)
    dc.DrawLine(self.tune_tx, 0, self.tune_tx, self.height)
    return rit
  def SetHeight(self, height):
    self.height = height
    self.SetSize((self.graph_width, height))
  def OnGraphData(self, data):
    x = 0
    for y in data:	# y is in dB, -130 to 0
      y = self.zeroDB - int(y * self.scale / 10.0 + 0.5)
      try:
        y0 = self.line[x][1]
      except IndexError:
        self.line.append([x, y])
      else:
        if y > y0:
          y = min(y, y0 + self.peak_hold)
        self.line[x] = [x, y]
      x = x + 1
    self.Refresh()
  def SetTuningLine(self, tune_tx, tune_rx):
    dc = wx.ClientDC(self)
    rit = self.parent.GetFilterDisplayRit()
    # Erase the old display
    dc.SetPen(self.backgroundPen)
    if self.tune_rx:
      dc.DrawLine(self.tune_rx, 0, self.tune_rx, self.height)
    dc.DrawLine(self.tune_tx, 0, self.tune_tx, self.height)
    # Draw a new display
    if self.tune_rx:
      dc.SetPen(self.tuningPenRx)
      dc.DrawLine(tune_rx, 0, tune_rx, self.height)
    dc.SetPen(self.tuningPenTx)
    dc.DrawLine(tune_tx, 0, tune_tx, self.height)
    self.tune_tx = tune_tx
    self.tune_rx = tune_rx

class GraphScreen(wx.Window):
  """Display the graph screen X and Y axis, and create a graph display."""
  def __init__(self, parent, data_width, graph_width, in_splitter=0):
    wx.Window.__init__(self, parent, pos = (0, 0))
    self.in_splitter = in_splitter	# Are we in the top of a splitter window?
    self.split_unavailable = False		# Are we a multi receive graph or waterfall window?
    if in_splitter:
      self.y_scale = conf.waterfall_graph_y_scale
      self.y_zero = conf.waterfall_graph_y_zero
    else:
      self.y_scale = conf.graph_y_scale
      self.y_zero = conf.graph_y_zero
    self.y_ticks = []
    self.VFO = 0
    self.filter_mode = 'AM'
    self.filter_bandwidth = 0
    self.filter_center = 0
    self.ritFreq = 0				# receive incremental tuning frequency offset
    self.mouse_x = 0
    self.WheelMod = conf.mouse_wheelmod		# Round frequency when using mouse wheel
    self.txFreq = 0
    self.sample_rate = application.sample_rate
    self.zoom = 1.0
    self.zoom_deltaf = 0
    self.data_width = data_width
    self.graph_width = graph_width
    self.doResize = False
    self.pen_tick = wx.Pen(conf.color_graphticks, 1)
    self.pen_label = wx.Pen(conf.color_graphlabels, 1)
    self.font = wx.Font(conf.graph_font_size, wx.FONTFAMILY_SWISS, wx.NORMAL,
          wx.FONTWEIGHT_NORMAL, False, conf.quisk_typeface)
    self.SetFont(self.font)
    w = self.GetCharWidth() * 14 // 10
    h = self.GetCharHeight()
    self.charx = w
    self.chary = h
    self.tick = max(2, h * 3 // 10)
    self.originX = w * 5
    self.offsetY = h + self.tick
    self.width = self.originX + self.graph_width + self.tick + self.charx * 2
    self.height = application.screen_height * 3 // 10
    self.x0 = self.originX + self.graph_width // 2		# center of graph
    self.tuningX = self.x0
    self.originY = 10
    self.zeroDB = 10	# y location of zero dB; may be above the top of the graph
    self.scale = 10
    self.mouse_is_rx = False
    self.SetSize((self.width, self.height))
    self.SetSizeHints(self.width, 1, self.width)
    self.SetBackgroundColour(conf.color_graph)
    self.backgroundBrush = wx.Brush(conf.color_graph)
    self.Bind(wx.EVT_SIZE, self.OnSize)
    self.Bind(wx.EVT_PAINT, self.OnPaint)
    self.Bind(wx.EVT_LEFT_DOWN, self.OnLeftDown)
    self.Bind(wx.EVT_RIGHT_DOWN, self.OnRightDown)
    self.Bind(wx.EVT_LEFT_UP, self.OnLeftUp)
    self.Bind(wx.EVT_MOTION, self.OnMotion)
    self.Bind(wx.EVT_MOUSEWHEEL, self.OnWheel)
    self.MakeDisplay()
  def MakeDisplay(self):
    self.display = GraphDisplay(self, self.originX, 0, self.graph_width, 5, self.chary)
    self.display.zeroDB = self.zeroDB
  def SetDisplayMsg(self, text=''):
    self.display.display_text = text
    self.display.Refresh()
  def ScrollMsg(self, chars):	# Add characters to a scrolling message
    self.display.display_text = self.display.display_text + chars
    self.display.display_text = self.display.display_text[-50:]
    self.display.Refresh()
  def OnPaint(self, event):
    dc = wx.PaintDC(self)
    dc.SetBackground(self.backgroundBrush)
    dc.Clear()
    dc.SetFont(self.font)
    dc.SetTextForeground(conf.color_graphlabels)
    if self.in_splitter:
      self.MakeYTicks(dc)
    else:
      self.MakeYTicks(dc)
      self.MakeXTicks(dc)
  def OnIdle(self, event):
    if self.doResize:
      self.ResizeGraph()
  def OnSize(self, event):
    self.doResize = True
    event.Skip()
  def ResizeGraph(self):
    """Change the height of the graph.

    Changing the width interactively is not allowed because the FFT size is fixed.
    Call after changing the zero or scale to recalculate the X and Y axis marks.
    """
    w, h = self.GetClientSize()
    if self.in_splitter:	# Splitter window has no X axis scale
      self.height = h
      self.originY = h
    else:
      self.height = h - self.chary		# Leave space for X scale
      self.originY = self.height - self.offsetY
    if self.originY < 0:
      self.originY = 0
    self.MakeYScale()
    self.display.SetHeight(self.originY)
    self.display.scale = self.scale
    self.doResize = False
    self.Refresh()
  def ChangeYscale(self, y_scale):
    self.y_scale = y_scale
    self.doResize = True
  def ChangeYzero(self, y_zero):
    self.y_zero = y_zero
    self.doResize = True
  def ChangeZoom(self, zoom, deltaf):
    self.zoom = zoom
    self.zoom_deltaf = deltaf
    self.doResize = True
  def MakeYScale(self):
    chary = self.chary
    scale = (self.originY - chary)  * 10 // (self.y_scale + 20)	# Number of pixels per 10 dB
    scale = max(1, scale)
    q = (self.originY - chary ) // scale // 2
    zeroDB = chary + q * scale - self.y_zero * scale // 10
    if zeroDB > chary:
      zeroDB = chary
    self.scale = scale
    self.zeroDB = zeroDB
    self.display.zeroDB = self.zeroDB
    QS.record_graph(self.originX, self.zeroDB, self.scale)
  def MakeYTicks(self, dc):
    chary = self.chary
    x1 = self.originX - self.tick * 3	# left of tick mark
    x2 = self.originX - 1		# x location of y axis
    x3 = self.originX + self.graph_width	# end of graph data
    dc.SetPen(self.pen_tick)
    dc.DrawLine(x2, 0, x2, self.originY + 1)	# y axis
    y = self.zeroDB
    del self.y_ticks[:]
    y_old = y
    for i in range(0, -99999, -10):
      if y >= chary // 2:
        dc.SetPen(self.pen_tick)
        dc.DrawLine(x1, y, x2, y)	# y tick
        self.y_ticks.append(y)
        t = repr(i)
        w, h = dc.GetTextExtent(t)
        # draw text on Y axis
        if y - y_old > h:
          if y + h // 2 <= self.originY:	
            dc.DrawText(repr(i), x1 - w, y - h // 2)
          elif h < self.scale:
            dc.DrawText(repr(i), x1 - w, self.originY - h)
          y_old = y
      y = y + self.scale
      if y >= self.originY - 3:
        break
  def MakeXTicks(self, dc):
    sample_rate = int(self.sample_rate * self.zoom)
    VFO = self.VFO + self.zoom_deltaf
    originY = self.originY
    x3 = self.originX + self.graph_width	# end of fft data
    charx , z = dc.GetTextExtent('-30000XX')
    tick0 = self.tick
    tick1 = tick0 * 2
    tick2 = tick0 * 3
    # Draw the X axis
    dc.SetPen(self.pen_tick)
    dc.DrawLine(self.originX, originY, x3, originY)
    # Draw the band plan colors below the X axis
    x = self.originX
    f = float(x - self.x0) * sample_rate / self.data_width
    c = None
    y = originY + 1
    for freq, color in conf.BandPlan:
      freq -= VFO
      if f < freq:
        xend = int(self.x0 + float(freq) * self.data_width / sample_rate + 0.5)
        if c is not None:
          dc.SetPen(wx.TRANSPARENT_PEN)
          dc.SetBrush(wx.Brush(c))
          dc.DrawRectangle(x, y, min(x3, xend) - x, tick0)  # x axis
        if xend >= x3:
          break
        x = xend
        f = freq
      c = color
    # check the width of the frequency label versus frequency span
    df = charx * sample_rate // self.data_width
    if VFO >= 10E9:     # Leave room for big labels
      df *= 1.33
    elif VFO >= 1E9:
      df *= 1.17
    # tfreq: tick frequency for labels in Hertz
    # stick: small tick in Hertz
    # mtick: medium tick
    # ltick: large tick
    s2 = 1000
    tfreq = None
    while tfreq is None:
      if df < s2:
        tfreq = s2
        stick = s2 // 10
        mtick = s2 // 2
        ltick = tfreq
      elif df < s2 * 2:
        tfreq = s2 * 2
        stick = s2 // 10
        mtick = s2 // 2
        ltick = s2
      elif df < s2 * 5:
        tfreq = s2 * 5
        stick = s2 // 2
        mtick = s2
        ltick = tfreq
      s2 *= 10
    # Draw the X axis ticks and frequency in kHz
    dc.SetPen(self.pen_tick)
    freq1 = VFO - sample_rate // 2
    freq1 = (freq1 // stick) * stick
    freq2 = freq1 + sample_rate + stick + 1
    y_end = 0
    for f in range (freq1, freq2, stick):
      x = self.x0 + int(float(f - VFO) / sample_rate * self.data_width)
      if self.originX <= x <= x3:
        if f % ltick == 0:		# large tick
          dc.DrawLine(x, originY, x, originY + tick2)
        elif f % mtick == 0:	# medium tick
          dc.DrawLine(x, originY, x, originY + tick1)
        else:					# small tick
          dc.DrawLine(x, originY, x, originY + tick0)
        if f % tfreq == 0:		# place frequency label
          t = str(f//1000)
          w, h = dc.GetTextExtent(t)
          dc.DrawText(t, x - w // 2, originY + tick2)
          y_end = originY + tick2 + h
    if y_end:		# mark the center of the display
      dc.DrawLine(self.x0, y_end, self.x0, application.screen_height)
  def OnGraphData(self, data):
    i1 = (self.data_width - self.graph_width) // 2
    i2 = i1 + self.graph_width
    self.display.OnGraphData(data[i1:i2])
  def SetVFO(self, vfo):
    self.VFO = vfo
    self.doResize = True
  def SetTxFreq(self, tx_freq, rx_freq):
    sample_rate = int(self.sample_rate * self.zoom)
    self.txFreq = tx_freq
    tx_x = self.x0 + int(float(tx_freq - self.zoom_deltaf) / sample_rate * self.data_width)
    self.tuningX = tx_x
    rx_x = self.x0 + int(float(rx_freq - self.zoom_deltaf) / sample_rate * self.data_width)
    if abs(tx_x - rx_x) < 2:		# Do not display Rx line for small frequency offset
      self.display.SetTuningLine(tx_x - self.originX, 0)
    else:
      self.display.SetTuningLine(tx_x - self.originX, rx_x - self.originX)
  def GetFilterDisplayXWR(self, rx_filters):
    mode = self.filter_mode
    rit = self.ritFreq
    if rx_filters:	# return Rx filter
      bandwidth = self.filter_bandwidth
      center = self.filter_center
    else:	# return Tx filter
      bandwidth, center = get_filter_tx(mode)
    x = center - bandwidth // 2
    scale = 1.0 / self.zoom / self.sample_rate * self.data_width
    x = int(x * scale + 0.5)
    bandwidth = int(bandwidth * scale + 0.5)
    if bandwidth < 2:
      bandwidth = 1
    rit = int(rit * scale + 0.5)
    #print(mode, x, bandwidth, rit, center )
    return x, bandwidth, rit		# Starting x, bandwidth and RIT frequency
  def GetFilterDisplayRit(self):
    rit = self.ritFreq
    scale = 1.0 / self.zoom / self.sample_rate * self.data_width
    rit = int(rit * scale + 0.5)
    return rit
  def GetMousePosition(self, event):
    """For mouse clicks in our display, translate to our screen coordinates."""
    mouse_x, mouse_y = event.GetPosition()
    win = event.GetEventObject()
    if win is not self:
      x, y = win.GetPosition().Get()
      mouse_x += x
      mouse_y += y
    return mouse_x, mouse_y
  def FreqRound(self, tune, vfo):
    if conf.freq_spacing and not conf.freq_round_ssb:
      freq = tune + vfo
      n = int(freq) - conf.freq_base
      if n >= 0:
        n = (n + conf.freq_spacing // 2) // conf.freq_spacing
      else:
        n = - ( - n + conf.freq_spacing // 2) // conf.freq_spacing
      freq = conf.freq_base + n * conf.freq_spacing
      return freq - vfo
    else:
      return tune
  def OnRightDown(self, event):
    sample_rate = int(self.sample_rate * self.zoom)
    VFO = self.VFO + self.zoom_deltaf
    mouse_x, mouse_y = self.GetMousePosition(event)
    freq = float(mouse_x - self.x0) * sample_rate / self.data_width
    freq = int(freq)
    if VFO > 0:
      vfo = VFO + freq - self.zoom_deltaf
      if sample_rate > 40000:
        vfo = (vfo + 5000) // 10000 * 10000	# round to even number
      elif sample_rate > 5000:
        vfo = (vfo + 500) // 1000 * 1000
      else:
        vfo = (vfo + 50) // 100 * 100
      tune = freq + VFO - vfo
      tune = self.FreqRound(tune, vfo)
      self.ChangeHwFrequency(tune, vfo, 'MouseBtn3', event=event)
  def OnLeftDown(self, event):
    sample_rate = int(self.sample_rate * self.zoom)
    mouse_x, mouse_y = self.GetMousePosition(event)
    if mouse_x <= self.originX:		# click left of Y axis
      return
    if mouse_x >= self.originX + self.graph_width:	# click past FFT data
      return
    shift = wx.GetKeyState(wx.WXK_SHIFT)
    if shift:
      mouse_x -= self.filter_center * self.data_width / sample_rate
    self.mouse_x = mouse_x
    x = mouse_x - self.originX
    if self.split_unavailable:
      self.mouse_is_rx = False
    elif application.split_rxtx and application.split_locktx:
      self.mouse_is_rx = True
    elif self.display.tune_rx and abs(x - self.display.tune_tx) > abs(x - self.display.tune_rx):
      self.mouse_is_rx = True
    else:
      self.mouse_is_rx = False
    if mouse_y < self.originY:		# click above X axis
      freq = float(mouse_x - self.x0) * sample_rate / self.data_width + self.zoom_deltaf
      freq = int(freq)
      if self.mouse_is_rx:
        application.rxFreq = freq
        application.screen.SetTxFreq(self.txFreq, freq)
        QS.set_tune(freq + application.ritFreq, self.txFreq)
      else:
        rnd = conf.freq_round_ssb
        if rnd and not shift:
          if application.mode in ('LSB', 'USB', 'AM', 'FM', 'FDV-U', 'FDV-L'):
            freq = (freq + rnd//2) // rnd * rnd
        else:
          freq = self.FreqRound(freq, self.VFO)
        self.ChangeHwFrequency(freq, self.VFO, 'MouseBtn1', event=event)
    self.CaptureMouse()
  def OnLeftUp(self, event):
    if self.HasCapture():
      self.ReleaseMouse()
      freq = self.FreqRound(self.txFreq, self.VFO)
      if freq != self.txFreq:
        self.ChangeHwFrequency(freq, self.VFO, 'MouseMotion', event=event)
  def OnMotion(self, event):
    sample_rate = int(self.sample_rate * self.zoom)
    if event.Dragging() and event.LeftIsDown():
      mouse_x, mouse_y = self.GetMousePosition(event)
      if wx.GetKeyState(wx.WXK_SHIFT):
        mouse_x -= self.filter_center * self.data_width / sample_rate
      if conf.mouse_tune_method:		# Mouse motion changes the VFO frequency
        x = (mouse_x - self.mouse_x)	# Thanks to VK6JBL
        self.mouse_x = mouse_x
        freq = float(x) * sample_rate / self.data_width
        freq = int(freq)
        self.ChangeHwFrequency(self.txFreq, self.VFO - freq, 'MouseMotion', event=event)
      else:		# Mouse motion changes the tuning frequency
        # Frequency changes more rapidly for higher mouse Y position
        speed = max(10, self.originY - mouse_y) / float(self.originY + 1)
        x = (mouse_x - self.mouse_x)
        self.mouse_x = mouse_x
        freq = speed * x * sample_rate / self.data_width
        freq = int(freq)
        if self.mouse_is_rx:	# Mouse motion changes the receive frequency
          application.rxFreq += freq
          application.screen.SetTxFreq(self.txFreq, application.rxFreq)
          QS.set_tune(application.rxFreq + application.ritFreq, self.txFreq)
        else:					# Mouse motion changes the transmit frequency
          self.ChangeHwFrequency(self.txFreq + freq, self.VFO, 'MouseMotion', event=event)
  def OnWheel(self, event):
    if conf.freq_spacing:
      wm = conf.freq_spacing
    else:
      wm = self.WheelMod		# Round frequency when using mouse wheel
    mouse_x, mouse_y = self.GetMousePosition(event)
    x = mouse_x - self.originX
    if self.split_unavailable:
      self.mouse_is_rx = False
    elif application.split_rxtx and application.split_locktx:
      self.mouse_is_rx = True
    elif self.display.tune_rx and abs(x - self.display.tune_tx) > abs(x - self.display.tune_rx):
      self.mouse_is_rx = True
    else:
      self.mouse_is_rx = False
    if self.mouse_is_rx:
      freq = application.rxFreq + self.VFO + wm * event.GetWheelRotation() // event.GetWheelDelta()
      if conf.freq_spacing:
        freq = self.FreqRound(freq, 0)
      elif freq >= 0:
        freq = freq // wm * wm
      else:		# freq can be negative when the VFO is zero
        freq = - (- freq // wm * wm)
      tune = freq - self.VFO
      application.rxFreq = tune
      application.screen.SetTxFreq(self.txFreq, tune)
      QS.set_tune(tune + application.ritFreq, self.txFreq)
    else:
      freq = self.txFreq + self.VFO + wm * event.GetWheelRotation() // event.GetWheelDelta()
      if conf.freq_spacing:
        freq = self.FreqRound(freq, 0)
      elif freq >= 0:
        freq = freq // wm * wm
      else:		# freq can be negative when the VFO is zero
        freq = - (- freq // wm * wm)
      tune = freq - self.VFO
      self.ChangeHwFrequency(tune, self.VFO, 'MouseWheel', event=event)
  def ChangeHwFrequency(self, tune, vfo, source='', band='', event=None):
    application.ChangeHwFrequency(tune, vfo, source, band, event)
  def PeakHold(self, name):
    if name == 'GraphP1':
      self.display.peak_hold = int(self.display.scale * conf.graph_peak_hold_1)
    elif name == 'GraphP2':
      self.display.peak_hold = int(self.display.scale * conf.graph_peak_hold_2)
    else:
      self.display.peak_hold = 9999
    if self.display.peak_hold < 1:
      self.display.peak_hold = 1

class StationScreen(wx.Window):		# This code was contributed by Christof, DJ4CM.  Many Thanks!!
  """Create a window below the graph X axis to display interesting frequencies."""
  def __init__(self, parent, width, lines):
    self.lineMargin = 2
    self.lines = lines
    self.mouse_x = 0
    self.stationList = []
    graph = self.graph = application.graph
    height = lines * (graph.GetCharHeight() + self.lineMargin)	# The height may be zero
    wx.Window.__init__(self, parent, size=(graph.width, height), style = wx.NO_BORDER)
    self.font = wx.Font(conf.graph_font_size, wx.FONTFAMILY_SWISS, wx.NORMAL,
          wx.FONTWEIGHT_NORMAL, False, conf.quisk_typeface)
    self.SetFont(self.font)
    self.SetBackgroundColour(conf.color_graph)
    self.width = application.screen_width
    self.Bind(wx.EVT_PAINT, self.OnPaint)
    if lines:
      self.Bind(wx.EVT_LEFT_DOWN, self.OnLeftDown)
      self.Bind(wx.EVT_MOTION, self.OnMotion)
      self.Bind(wx.EVT_LEAVE_WINDOW, self.OnLeaveWindow)
      # handle station info
      self.stationWindow = wx.PopupWindow (parent)
      self.stationInfo = wx.richtext.RichTextCtrl(self.stationWindow)
      self.stationInfo.SetFont(wx.Font(conf.status_font_size, wx.FONTFAMILY_SWISS, wx.NORMAL,
          wx.FONTWEIGHT_NORMAL, False, conf.quisk_typeface))
      self.stationWindow.Hide(); 
      self.firstStationInRange = None
      self.lastStationX = 0
      self.nrStationInRange = 0
      self.tunedStation = 0
  def OnPaint(self, event):
    dc = wx.PaintDC(self)
    if not self.lines:
      return
    dc.SetFont(self.font)
    graph = self.graph
    dc.SetTextForeground(conf.color_graphlabels)
    dc.SetPen(graph.pen_tick)
    originX = graph.originX
    originY = graph.originY
    endX = originX + graph.graph_width    # end of fft data
    sample_rate = int(graph.sample_rate * graph.zoom)
    VFO = graph.VFO + graph.zoom_deltaf
    hl = self.GetCharHeight()
    y = 0
    for i in range (self.lines):
      dc.DrawLine(originX, y, endX, y)
      y += hl + self.lineMargin
    # create a sorted list of favorites in the frequency range  
    freq1 = VFO - sample_rate // 2
    freq2 = VFO + sample_rate // 2
    self.stationList = []
    fav = application.config_screen.favorites
    for row in range (fav.GetNumberRows()):
      fav_f = fav.GetCellValue(row, 1) 
      if fav_f:
        try:
          fav_f = str2freq(fav_f)
          if freq1 < fav_f < freq2:
            self.stationList.append((fav_f, conf.Xsym_stat_fav, fav.GetCellValue(row, 0),
                fav.GetCellValue(row, 2), fav.GetCellValue(row, 3)))
        except ValueError:
          pass            
    # add memory stations
    for mem_f, mem_band, mem_vfo, mem_txfreq, mem_mode in application.memoryState:
      if freq1 < mem_f < freq2:
        self.stationList.append((mem_f, conf.Xsym_stat_mem, '', mem_mode, ''))
    #add dx spots
    if application.dxCluster:
      for entry in application.dxCluster.dxSpots:
        if freq1 < entry.getFreq() < freq2:
          for i in range (0, entry.getLen()):
            descr = entry.getSpotter(i) + '\t' + entry.getTime(i) + '\t' + entry.getLocation(i) + '\n' + entry.getComment(i)
            if i < entry.getLen()-1:
              descr += '\n'
          self.stationList.append((entry.freq, conf.Xsym_stat_dx, entry.dx, '', descr))           
    # draw stations on graph
    self.stationList.sort(cmp=None, key=None, reverse=False)
    lastX = []
    line = 0
    for i in range (0, self.lines):
      lastX.append(graph.width)
    for statFreq, symbol, statName, statMode, statDscr in reversed (self.stationList):
      ws = dc.GetTextExtent(symbol)[0]
      statX = graph.x0 + int(float(statFreq - VFO) / sample_rate * graph.data_width)
      w, h = dc.GetTextExtent(statName)
      # shorten name until it fits into remaining space
      maxLen = 25
      tName = statName 
      while (w > lastX[line] - statX - ws - 4) and maxLen > 0:
        maxLen -= 1
        tName = statName[:maxLen] + '..'
        w, h = dc.GetTextExtent(tName)
      dc.DrawLine(statX, line * (hl+self.lineMargin), statX, line * (hl+self.lineMargin) + 4)                    
      dc.DrawText(symbol + ' ' + tName, statX - ws//2, line * (hl+self.lineMargin) + self.lineMargin//2+1)
      lastX[line] = statX
      line = (line+1)%self.lines
  def OnLeftDown(self, event):
    if self.firstStationInRange != None:
      # tune to station
      if self.tunedStation >= self.nrStationInRange:
        self.tunedStation = 0      
      freq, symbol, name, mode, dscr = self.stationList[self.firstStationInRange+self.tunedStation]
      self.tunedStation += 1
      if mode != '': # information about mode available
        mode = mode.upper()
        application.OnBtnMode(None, mode)
      application.ChangeRxTxFrequency(None, freq)
  def OnMotion(self, event):
    mouse_x, mouse_y = event.GetPosition()
    x = (mouse_x - self.mouse_x)
    application.isTuning = False
    # show detailed station info
    if abs(self.lastStationX - mouse_x) > 30:
      self.firstStationInRange = None   
    found = False
    graph = self.graph
    sample_rate = int(graph.sample_rate * graph.zoom)
    VFO = graph.VFO + graph.zoom_deltaf
    if abs(x) > 5: # ignore small mouse moves
      for index in range (0, len(self.stationList)):
        statFreq, symbol, statName, statMode, statDscr = self.stationList[index]
        statX = graph.x0 + int(float(statFreq - VFO) / sample_rate * graph.data_width)
        if abs(mouse_x-statX) < 10: 
          self.lastStationX = mouse_x
          if found == False:
            self.firstStationInRange = index
            self.nrStationInRange = 0
            self.stationInfo.Clear()
            found = True
          self.nrStationInRange += 1
          attr = self.stationInfo.GetBasicStyle()
          attr.SetFlags(wx.TEXT_ATTR_TABS)
          attr.SetTabs((40, 400, 700))
          self.stationInfo.SetBasicStyle(attr)
          self.stationInfo.BeginSymbolBullet(symbol, 0, 40) 
          self.stationInfo.BeginBold()      
          self.stationInfo.WriteText(statName + '\t')
          self.stationInfo.EndBold()
          self.stationInfo.WriteText (str(statFreq) + ' Hz\t' + statMode)
          self.stationInfo.Newline()
          self.stationInfo.EndSymbolBullet() 
          self.stationInfo.BeginLeftIndent(40)
          if len(statDscr) > 0:
            self.stationInfo.WriteText(statDscr)
            self.stationInfo.Newline()
          self.stationInfo.EndLeftIndent()   
          self.mouse_x = mouse_x   
    if self.firstStationInRange != None:
      line = self.stationInfo.GetVisibleLineForCaretPosition(self.stationInfo.GetCaretPosition()) 
      cy = line.GetAbsolutePosition()[1]
      self.stationWindow.SetClientSize((340, cy+2))
      self.stationInfo.SetClientSize((340, cy+2))
      # convert coordinates to screen
      sx, sy = self.ClientToScreen(wx.Point(mouse_x, mouse_y))
      w, h = self.stationInfo.GetClientSize()
      self.stationWindow.Move((sx - w * sx//graph.width, sy - h - 4)) 
      if not self.stationWindow.IsShown():
        self.stationWindow.Show()
    else:
      self.stationWindow.Hide()
  def OnLeaveWindow(self, event):
    self.stationWindow.Hide() 
                              

class WaterfallDisplay(wx.Window):
  """Create a waterfall display within the waterfall screen."""
  def __init__(self, parent, x, y, graph_width, height, margin):
    wx.Window.__init__(self, parent,
       pos = (x, y),
       size = (graph_width, height),
       style = wx.NO_BORDER)
    self.parent = parent
    self.graph_width = graph_width
    self.margin = margin
    self.height = 10
    self.zoom = 1.0
    self.zoom_deltaf = 0
    self.rf_gain = 0	# Keep waterfall colors constant for variable RF gain
    self.sample_rate = application.sample_rate
    self.SetBackgroundColour('Black')
    self.Bind(wx.EVT_PAINT, self.OnPaint)
    self.Bind(wx.EVT_LEFT_DOWN, parent.OnLeftDown)
    self.Bind(wx.EVT_RIGHT_DOWN, parent.OnRightDown)
    self.Bind(wx.EVT_LEFT_UP, parent.OnLeftUp)
    self.Bind(wx.EVT_MOTION, parent.OnMotion)
    self.Bind(wx.EVT_MOUSEWHEEL, parent.OnWheel)
    self.tune_tx = graph_width // 2	# Current X position of the Tx tuning line
    self.tune_rx = 0				# Current X position of Rx tuning line or zero
    self.marginPen = wx.Pen(conf.color_graph, 1)
    self.tuningPen = wx.Pen('White', 3)
    self.tuningPenTx = wx.Pen(conf.color_txline, 3)
    self.tuningPenRx = wx.Pen(conf.color_rxline, 3)
    self.filterBrush = wx.Brush(conf.color_bandwidth, wx.SOLID)
    #self.backgroundBrush = wx.Brush(conf.color_graph)
    # Size of top faster scroll region is (top_key + 2) * (top_key - 1) // 2
    self.top_key = 8
    self.top_size = (self.top_key + 2) * (self.top_key - 1) // 2
    # Make the palette
    if conf.waterfall_palette == 'B':
      pal2 = conf.waterfallPaletteB
    elif conf.waterfall_palette == 'C':
      pal2 = conf.waterfallPaletteC
    else:
      pal2 = conf.waterfallPalette
    red = []
    green = []
    blue = []
    n = 0
    for i in range(256):
      if i > pal2[n+1][0]:
         n = n + 1
      red.append((i - pal2[n][0]) *
       (pal2[n+1][1] - pal2[n][1]) //
       (pal2[n+1][0] - pal2[n][0]) + pal2[n][1])
      green.append((i - pal2[n][0]) *
       (pal2[n+1][2] - pal2[n][2]) //
       (pal2[n+1][0] - pal2[n][0]) + pal2[n][2])
      blue.append((i - pal2[n][0]) *
       (pal2[n+1][3] - pal2[n][3]) //
       (pal2[n+1][0] - pal2[n][0]) + pal2[n][3])
    self.red = red
    self.green = green
    self.blue = blue
    row = "\000\000\000\000"
    if wxVersion in ('2', '3'):
      bmp = wx.BitmapFromBufferRGBA(1, 1, row)
    else:
      bmp = wx.Bitmap().FromBufferRGBA(1, 1, row)
    bmp.x_origin = 0
    self.bitmaps = [bmp] * application.screen_height
    if sys.platform == 'win32':
      self.Bind(wx.EVT_ENTER_WINDOW, self.OnEnter)
  def OnEnter(self, event):
    if not application.w_phase:
      self.SetFocus()	# Set focus so we get mouse wheel events
  def OnPaint(self, event):
    sample_rate = int(self.sample_rate * self.zoom)
    dc = wx.BufferedPaintDC(self)
    dc.SetTextForeground(conf.color_graphlabels)
    dc.SetBackground(wx.Brush('Black'))
    dc.Clear()
    rit = self.DrawFilter(dc)
    dc.SetLogicalFunction(wx.COPY)
    x_origin = int(float(self.VFO) / sample_rate * self.data_width + 0.5)
    y = self.margin
    index = 0
    if conf.waterfall_scroll_mode:	# Draw the first few lines multiple times
      for i in range(self.top_key, 1, -1):
        b = self.bitmaps[index]
        x = b.x_origin - x_origin
        for j in range(0, i):
          dc.DrawBitmap(b, x, y)
          y += 1
        index += 1
    while y < self.height:
      b = self.bitmaps[index]
      x = b.x_origin - x_origin
      dc.DrawBitmap(b, x, y)
      y += 1
      index += 1
    dc.SetPen(self.tuningPen)
    dc.SetLogicalFunction(wx.XOR)
    dc.DrawLine(self.tune_tx, self.margin, self.tune_tx, self.height)
    if self.tune_rx:
      dc.DrawLine(self.tune_rx, self.margin, self.tune_rx, self.height)
  def SetHeight(self, height):
    self.height = height
    self.SetSize((self.graph_width, height))
  def DrawFilter(self, dc):
    # Erase area at the top of the waterfall
    dc.SetPen(wx.TRANSPARENT_PEN)
    dc.SetLogicalFunction(wx.COPY)
    dc.SetBrush(self.parent.backgroundBrush)
    dc.DrawRectangle(0, 0, self.graph_width, self.margin)
    # Draw the filter and top tuning lines
    scale = 1.0 / self.zoom / self.sample_rate * self.data_width
    dc.SetBrush(self.filterBrush)
    if self.tune_rx:
      x, w, rit = self.parent.GetFilterDisplayXWR(rx_filters=False)
      dc.DrawRectangle(self.tune_tx + x, 0, w, self.margin)
      x, w, rit = self.parent.GetFilterDisplayXWR(rx_filters=True)
      dc.DrawRectangle(self.tune_rx + rit + x, 0, w, self.margin)
      dc.SetPen(self.tuningPenRx)
      dc.DrawLine(self.tune_rx, 0, self.tune_rx, self.margin)
    else:
      x, w, rit = self.parent.GetFilterDisplayXWR(rx_filters=True)
      dc.DrawRectangle(self.tune_tx + rit + x, 0, w, self.margin)
    dc.SetPen(self.tuningPenTx)
    dc.DrawLine(self.tune_tx, 0, self.tune_tx, self.margin)
    return rit
  def OnGraphData(self, data, y_zero, y_scale):
    sample_rate = int(self.sample_rate * self.zoom)
    #T('graph start')
    row = ''		# Make a new row of pixels for a one-line image
    gain = self.rf_gain
    for x in data:	# x is -130 to 0, or so (dB)
      l = int((x - gain + y_zero // 3 + 100) * y_scale / 10)
      l = max(l, 0)
      l = min(l, 255)
      row = row + "%c%c%c%c" % (chr(self.red[l]), chr(self.green[l]), chr(self.blue[l]), chr(255))
    #T('graph string')
    if wxVersion in ('2', '3'):
      bmp = wx.BitmapFromBufferRGBA(len(row) // 4, 1, row)
    else:
      bmp = wx.Bitmap().FromBufferRGBA(len(row) // 4, 1, row)
    bmp.x_origin = int(float(self.VFO) / sample_rate * self.data_width + 0.5)
    self.bitmaps.insert(0, bmp)
    del self.bitmaps[-1]
    #self.ScrollWindow(0, 1, None)
    #self.Refresh(False, (0, 0, self.graph_width, self.top_size + self.margin))
    self.Refresh(False)
    #T('graph end')
  def SetTuningLine(self, tune_tx, tune_rx):
    dc = wx.ClientDC(self)
    rit = self.DrawFilter(dc)
    dc.SetPen(self.tuningPen)
    dc.SetLogicalFunction(wx.XOR)
    dc.DrawLine(self.tune_tx, self.margin, self.tune_tx, self.height)
    if self.tune_rx:
      dc.DrawLine(self.tune_rx, self.margin, self.tune_rx, self.height)
      dc.DrawLine(tune_rx, self.margin, tune_rx, self.height)
    dc.DrawLine(tune_tx, self.margin, tune_tx, self.height)
    self.tune_tx = tune_tx
    self.tune_rx = tune_rx
  def ChangeZoom(self, zoom, deltaf):
    self.zoom = zoom
    self.zoom_deltaf = deltaf

class WaterfallScreen(wx.SplitterWindow):
  """Create a splitter window with a graph screen and a waterfall screen"""
  def __init__(self, frame, width, data_width, graph_width):
    self.y_scale = conf.waterfall_y_scale
    self.y_zero = conf.waterfall_y_zero
    wx.SplitterWindow.__init__(self, frame)
    self.SetSizeHints(width, -1, width)
    self.SetSashGravity(0.50)
    self.SetMinimumPaneSize(1)
    self.SetSize((width, conf.waterfall_graph_size + 100))	# be able to set sash size
    self.pane1 = GraphScreen(self, data_width, graph_width, 1)
    self.pane2 = WaterfallPane(self, data_width, graph_width)
    self.SplitHorizontally(self.pane1, self.pane2, conf.waterfall_graph_size)
  def SetDisplayMsg(self, text=''):
    self.pane1.SetDisplayMsg(text)
  def ScrollMsg(self, char):	# Add a character to a scrolling message
    self.pane1.ScrollMsg(char)
  def OnIdle(self, event):
    self.pane1.OnIdle(event)
    self.pane2.OnIdle(event)
  def SetTxFreq(self, tx_freq, rx_freq):
    self.pane1.SetTxFreq(tx_freq, rx_freq)
    self.pane2.SetTxFreq(tx_freq, rx_freq)
  def SetVFO(self, vfo):
    self.pane1.SetVFO(vfo)
    self.pane2.SetVFO(vfo) 
  def ChangeYscale(self, y_scale):		# Test if the shift key is down
    if wx.GetKeyState(wx.WXK_SHIFT):	# Set graph screen
      self.pane1.ChangeYscale(y_scale)
    else:			# Set waterfall screen
      self.y_scale = y_scale
      self.pane2.ChangeYscale(y_scale)
  def ChangeYzero(self, y_zero):		# Test if the shift key is down
    if wx.GetKeyState(wx.WXK_SHIFT):	# Set graph screen
      self.pane1.ChangeYzero(y_zero)
    else:			# Set waterfall screen
      self.y_zero = y_zero
      self.pane2.ChangeYzero(y_zero)
  def SetPane2(self, ysz):
    y_scale, y_zero = ysz
    self.y_scale = y_scale
    self.pane2.ChangeYscale(y_scale)
    self.y_zero = y_zero
    self.pane2.ChangeYzero(y_zero)
  def OnGraphData(self, data):
    self.pane1.OnGraphData(data)
    self.pane2.OnGraphData(data)
  def ChangeRfGain(self, gain):		# Set the correction for RF gain
    self.pane2.display.rf_gain = gain

class WaterfallPane(GraphScreen):
  """Create a waterfall screen with an X axis and a waterfall display."""
  def __init__(self, frame, data_width, graph_width):
    GraphScreen.__init__(self, frame, data_width, graph_width)
    self.y_scale = conf.waterfall_y_scale
    self.y_zero = conf.waterfall_y_zero
    self.oldVFO = self.VFO
    self.filter_mode = 'AM'
    self.filter_bandwidth = 0
    self.filter_center = 0
    self.ritFreq = 0				# receive incremental tuning frequency offset
  def MakeDisplay(self):
    self.display = WaterfallDisplay(self, self.originX, 0, self.graph_width, 5, self.chary)
    self.display.VFO = self.VFO
    self.display.data_width = self.data_width
  def SetVFO(self, vfo):
    GraphScreen.SetVFO(self, vfo)
    self.display.VFO = vfo
    if self.oldVFO != vfo:
      self.oldVFO = vfo
      self.Refresh()
  def MakeYTicks(self, dc):
    pass
  def ChangeYscale(self, y_scale):
    self.y_scale = y_scale
  def ChangeYzero(self, y_zero):
    self.y_zero = y_zero
  def OnGraphData(self, data):
    i1 = (self.data_width - self.graph_width) // 2
    i2 = i1 + self.graph_width
    self.display.OnGraphData(data[i1:i2], self.y_zero, self.y_scale)

class MultiRxGraph(GraphScreen):
  # The screen showing each added receiver
  the_modes = ('CWL', 'CWU', 'LSB', 'USB', 'AM', 'FM', 'DGT-U', 'DGT-L', 'DGT-FM', 'DGT-IQ')
  def __init__(self, parent, data_width, graph_width, index):
    multi_rx = application.multi_rx_screen
    width = multi_rx.rx_data_width
    GraphScreen.__init__(self, parent, width, width)
    self.graph_display = self.display
    self.waterfall_display = WaterfallDisplay(self, self.originX, 0, self.graph_width, 5, self.chary)
    self.waterfall_display.Hide()
    self.waterfall_display.VFO = self.VFO
    self.waterfall_display.data_width = self.data_width
    self.waterfall_y_scale = conf.waterfall_y_scale
    self.waterfall_y_zero = conf.waterfall_y_zero
    self.split_unavailable = True
    width = self.originX + self.graph_width
    self.tabX = width + (multi_rx.graph.width - width - multi_rx.rx_btn_width) // 2
    self.popupX = self.tabX - multi_rx.rx_btn_width * 2
    self.multirx_index = index
    self.is_playing = False
    self.mode_index = 0
    self.band = '40'
    # Create controls
    posY = 0
    half_width = multi_rx.rx_btn_width // 2
    half_size = half_width, multi_rx.rx_btn_height
    self.rx_btn = QuiskPushbutton(self, self.OnPopButton, "Rx %d .." % (index + 1))
    self.rx_btn.SetSize(half_size)
    self.rx_btn.SetPosition((self.tabX, posY))
    self.play_btn = QuiskCheckbutton(self, self.OnPlayButton, "Play")
    self.play_btn.SetSize(half_size)
    self.play_btn.SetPosition((self.tabX + half_width, posY))
    posY += multi_rx.rx_btn_height
    btn1 = QuiskPushbutton(self, self.OnBtnDownBand, conf.Xbtn_text_range_dn, use_right=True)
    btn2 = QuiskPushbutton(self, self.OnBtnUpBand, conf.Xbtn_text_range_up, use_right=True)
    btn1.SetSize(half_size)
    btn2.SetSize(half_size)
    btn1.SetPosition((self.tabX, posY))
    btn2.SetPosition((self.tabX + half_width, posY))
    posY += multi_rx.rx_btn_height
    self.sliderYs = SliderBoxV(self, 'Ys', self.y_scale, 160, self.OnChangeYscale, True)
    self.sliderYz = SliderBoxV(self, 'Yz', self.y_zero, 160, self.OnChangeYzero, True)
    x = self.tabX + (half_width * 2 - self.sliderYs.width - self.sliderYz.width) // 2
    self.sliderYs.SetDimension(x, posY, self.sliderYs.width, 100)
    x += self.sliderYs.width
    self.sliderYz.SetDimension(x, posY, self.sliderYz.width, 100)
    # Create menu
    self.multi_rx_menu = wx.Menu()
    item = self.multi_rx_menu.Append(-1, 'Show graph')
    self.Bind(wx.EVT_MENU, self.OnShowGraph, item)
    item = self.multi_rx_menu.Append(-1, 'Show waterfall')
    self.Bind(wx.EVT_MENU, self.OnShowWaterfall, item)
    self.multi_rx_menu.AppendSeparator()
    menu = wx.Menu()
    self.multi_rx_menu.AppendSubMenu(menu, "Band")
    for band in conf.bandLabels:
      if type(band) not in (UnicodeType, StringType):
        band = band[0]
        if band == 'Time':
          continue
      item = menu.Append(-1, band)
      self.Bind(wx.EVT_MENU, self.OnChangeBand, item)
    self.mode_menu = wx.Menu()
    self.multi_rx_menu.AppendSubMenu(self.mode_menu, "Mode")
    for mode in self.the_modes:
      item = self.mode_menu.AppendRadioItem(-1, mode)
      self.Bind(wx.EVT_MENU, self.OnChangeMode, item)
    self.filter_menu = wx.Menu()
    self.multi_rx_menu.AppendSubMenu(self.filter_menu, "Filter")
    for i in range(6):
      item = self.filter_menu.AppendRadioItem(-1, '0')
      self.Bind(wx.EVT_MENU, self.OnChangeFilter, item)
    self.multi_rx_menu.AppendSeparator()
    item = self.multi_rx_menu.Append(-1, 'Delete receiver')
    self.Bind(wx.EVT_MENU, self.OnDeleteReceiver, item)
    self.ChangeBand(application.lastBand)
    if multi_rx.rx_zero == multi_rx.waterfall:
      self.OnShowWaterfall()
  def ResizeGraph(self):
    GraphScreen.ResizeGraph(self)
    w, h = self.GetClientSize()
    x, y = self.sliderYs.GetPosition()
    height = max(h - y, self.sliderYs.text_height * 2)
    self.sliderYs.SetDimension(x, y, self.sliderYs.width, height)
    x, y = self.sliderYz.GetPosition()
    self.sliderYz.SetDimension(x, y, self.sliderYz.width, height)
  def MakeYTicks(self, dc):
    if self.display == self.graph_display:
      GraphScreen.MakeYTicks(self, dc)
  def OnPopButton(self, event):
    pos = (self.popupX, 10)
    self.PopupMenu(self.multi_rx_menu, pos)
  def OnDeleteReceiver(self, event):
    if self.is_playing:
      QS.set_multirx_play_channel(-1)
    application.multi_rx_screen.DeleteReceiver(self)
  def OnShowGraph(self, event):
    self.waterfall_display.Hide()
    self.display = self.graph_display
    self.SetTxFreq(self.txFreq, self.txFreq)
    self.sliderYs.SetValue(self.y_scale)
    self.sliderYz.SetValue(self.y_zero)
    self.display.Show()
    self.doResize = True
  def OnShowWaterfall(self, event=None):
    self.graph_display.Hide()
    self.display = self.waterfall_display
    self.SetTxFreq(self.txFreq, self.txFreq)
    self.sliderYs.SetValue(self.waterfall_y_scale)
    self.sliderYz.SetValue(self.waterfall_y_zero)
    self.display.Show()
    self.doResize = True
  def OnGraphData(self, data):
    if self.display == self.graph_display:
      self.display.OnGraphData(data)
    else:
      self.display.OnGraphData(data, self.waterfall_y_zero, self.waterfall_y_scale)
  def OnPlayButton(self, event):
    application.multi_rx_screen.StopPlaying(self)
    self.is_playing = event.GetEventObject().GetValue()
    if self.is_playing:
      QS.set_filters(self.filter_I, self.filter_Q, self.filter_bandwidth, 0, 1)
      QS.set_multirx_play_channel(self.multirx_index)
    else:
      QS.set_multirx_play_channel(-1)
  def SetVFO(self, vfo):
    GraphScreen.SetVFO(self, vfo)
    self.waterfall_display.VFO = self.VFO
    self.waterfall_display.Refresh()
  def OnChangeBand(self, event):
    idd = event.GetId()
    band = event.GetEventObject().GetLabel(idd)
    self.ChangeBand(band)
  def OnChangeMode(self, event=None):
    if event is None:
      try:
        idx = self.the_modes.index(self.mode)
      except ValueError:
        self.mode = 'USB'
        idx = self.the_modes.index(self.mode)
      self.mode_menu.FindItemByPosition(idx).Check(True)
    else:
      idd = event.GetId()
      self.mode = event.GetEventObject().GetLabel(idd)
    bws = application.Mode2Filters(self.mode)
    self.mode_index = Mode2Index.get(self.mode, 3)
    QS.set_multirx_mode(self.multirx_index, self.mode_index)
    for i in range(6):
      item = self.filter_menu.FindItemByPosition(i)
      item.SetItemLabel(str(bws[i]))
      if i == 2:
        item.Check(True)
    self.filter_bandwidth = bws[2]
    self.OnChangeFilter()
  def OnChangeFilter(self, event=None):
    if event is not None:
      idd = event.GetId()
      self.filter_bandwidth = int(event.GetEventObject().GetLabel(idd))
    center = application.GetFilterCenter(self.mode, self.filter_bandwidth)
    frate = QS.get_filter_rate(Mode2Index.get(self.mode, 3), self.filter_bandwidth)
    self.filter_I, self.filter_Q = application.MakeFilterCoef(frate, None, self.filter_bandwidth, center)
    if self.is_playing:
      QS.set_filters(self.filter_I, self.filter_Q, self.filter_bandwidth, 0, 1)	# filter for receiver that is playing sound
    if self.multirx_index == 0:
      QS.set_filters(self.filter_I, self.filter_Q, self.filter_bandwidth, 0, 2)	# filter for digital mode output to sound device
    self.filter_mode = self.mode
    self.filter_center = center
  def ChangeBand(self, band):
    self.band = band
    try:
      vfo, tune, self.mode = application.bandState[band]
      #print (vfo, tune, self.mode)
    except:
      try:
        f1, f2 = conf.BandEdge[band]
      except KeyError:
        f1, f2 = 10000000, 12000000
      vfo = (f1 + f2) // 2
      vfo = vfo // 10000
      vfo *= 10000
      if vfo < 9000000:
        self.mode = 'LSB'
      else:
        self.mode = 'USB'
      tune = 0
    self.OnChangeMode()
    self.ChangeHwFrequency(tune, vfo, 'ChangeBand')
    if hasattr(application.Hardware, "ChangeBandFilters"):
      application.Hardware.ChangeBandFilters()
  def OnBtnDownBand(self, event):
    self.OnBtnUpBand(event, True)
  def OnBtnUpBand(self, event, is_band_down=False):
    sample_rate = application.sample_rate
    btn = event.GetEventObject()
    oldvfo = self.VFO
    if btn.direction > 0:		# left button was used, move a bit
      d = int(sample_rate // 9)
    else:						# right button was used, move to edge
      d = int(sample_rate * 45 // 100)
    if is_band_down:
      d = -d
    vfo = self.VFO + d
    if sample_rate > 40000:
      vfo = (vfo + 5000) // 10000 * 10000	# round to even number
      delta = 10000
    elif sample_rate > 5000:
      vfo = (vfo + 500) // 1000 * 1000
      delta = 1000
    else:
      vfo = (vfo + 50) // 100 * 100
      delta = 100
    if oldvfo == vfo:
      if is_band_down:
        d = -delta
      else:
        d = delta
    else:
      d = vfo - oldvfo
    self.ChangeHwFrequency(self.txFreq - d, self.VFO + d, 'BandUpDown', event=event)
  def OnChangeYscale(self, event):
    y_scale = self.sliderYs.GetValue()
    if self.display == self.graph_display:
      self.ChangeYscale(y_scale)
    else:
      self.waterfall_y_scale = y_scale
  def OnChangeYzero(self, event):
    y_zero = self.sliderYz.GetValue()
    if self.display == self.graph_display:
      self.ChangeYzero(y_zero)
    else:
      self.waterfall_y_zero = y_zero
  def ChangeHwFrequency(self, tune, vfo, source='', band='', event=None):
    self.SetTxFreq(tune, tune)
    self.SetVFO(vfo)
    Hardware.MultiRxFrequency(self.multirx_index, vfo)
    QS.set_multirx_freq(self.multirx_index, tune)

class MultiReceiverScreen(wx.SplitterWindow):
  # The top level screen showing a graph, waterfall and any additional receivers.
  # The first receiver is zero; additional receivers are in self.receiver_list[]
  def __init__(self, frame, data_width, graph_width):
    application.multi_rx_screen = self		# prevent phase error
    self.data_width = data_width
    self.graph_width = graph_width
    wx.SplitterWindow.__init__(self, frame)
    self.SetSashGravity(0.50)
    self.receiver_list = []
    self.graph = GraphScreen(self, data_width, graph_width)
    self.width = self.graph.width
    self.waterfall = WaterfallScreen(self, self.width, data_width, graph_width)
    self.rx_zero = self.graph
    self.Initialize(self.rx_zero)
    self.waterfall.Hide()
    self.SetSizeHints(self.width, -1, self.width)
    # Calculate control width
    rx_btn = QuiskPushbutton(self, None, "Rx 8....", style=wx.BU_EXACTFIT)
    self.rx_btn_width, self.rx_btn_height = rx_btn.GetSize().Get()
    self.rx_btn_width *= 2
    rx_btn.Destroy()
    del rx_btn
    self.SetMinimumPaneSize(self.rx_btn_height)
    self.rx_btn_border = 5
    width = data_width - self.rx_btn_width - self.rx_btn_border * 2
    self.rx_data_width = fftPreferedSizes[0]
    for x in fftPreferedSizes:
      if x >= width:
        break
      else:
        self.rx_data_width = x
  def __getattr__(self, name):
    return getattr(self.rx_zero, name)
  def ChangeRxZero(self, show_graph):
    if self.IsSplit():
      old = self.GetWindow2()
    else:
      old = self.GetWindow1()
    if show_graph:
      new = self.graph
    else:
      new = self.waterfall
    if old != new:
      self.ReplaceWindow(old, new)
      new.Show()
      old.Hide()
      self.rx_zero = new
  def StopPlaying(self, excpt):		# change to not playing on all panes except excpt
    for pane in self.receiver_list:
      if pane != excpt:
        pane.play_btn.SetValue(False)
        pane.is_playing = False
  def OnAddReceiver(self, event):
    index = len(self.receiver_list)
    if index >= 7:
      return
    if index == 0:
      pane2 = self.rx_zero
      splitter = pane2.GetParent()
      pane1 = MultiRxGraph(self, self.data_width, self.graph_width, index)
      self.receiver_list.append(pane1)
      splitter.SplitHorizontally(pane1, self.rx_zero)
    else:
      pane2 = self.receiver_list[-1]
      parent = pane2.GetParent()
      splitter = wx.SplitterWindow(parent)
      splitter.SetSizeHints(self.width, -1, self.width)
      splitter.SetMinimumPaneSize(self.rx_btn_height)
      splitter.SetSashGravity(0.50)
      pane1 = MultiRxGraph(splitter, self.data_width, self.graph_width, index)
      self.receiver_list.append(pane1)
      pane2.Reparent(splitter)
      parent.ReplaceWindow(pane2, splitter)
      splitter.SplitHorizontally(pane1, pane2)
    self.SizeEqually()
    index += 1		# len(self.receiver_list)
    Hardware.MultiRxCount(index)
    pane1.ChangeBand(application.lastBand)
  def DeleteReceiver(self, pane):
    Hardware.MultiRxCount(len(self.receiver_list) - 1)
    if len(self.receiver_list) == 1:
      self.Unsplit(pane)
      self.receiver_list.remove(pane)
      del pane
    elif pane in self.receiver_list[-2:]:
      self.receiver_list.remove(pane)
      splitter2 = pane.GetParent()
      splitter1 = splitter2.GetParent()
      del pane
      pane = self.receiver_list[-1]
      pane.Reparent(splitter1)
      splitter1.ReplaceWindow(splitter2, pane)
      splitter2.Destroy()
    else:
      self.receiver_list.remove(pane)
      splitter2 = pane.GetParent()
      splitter1 = splitter2.GetParent()
      splitter3 = splitter2.GetWindow1()
      del pane
      splitter3.Reparent(splitter1)
      splitter1.ReplaceWindow(splitter2, splitter3)
      splitter2.Destroy()
    index = 0
    for pane in self.receiver_list:
      pane.multirx_index = index
      pane.rx_btn.SetLabel("Rx %d" % (index + 1))
      QS.set_multirx_mode(index, pane.mode_index)
      QS.set_multirx_freq(index, pane.txFreq)
      index += 1
    if hasattr(application.Hardware, "ChangeBandFilters"):
      application.Hardware.ChangeBandFilters()
  def SizeEqually(self):
    w, h = self.GetClientSize()
    num = len(self.receiver_list)
    self.SetSashPosition(h * num // (num + 1))
    for rx in self.receiver_list[:-1]:
      splitter = rx.GetParent()
      w, h = splitter.GetClientSize()
      num -= 1
      splitter.SetSashPosition(h * num // (num + 1))
  def OnIdle(self, event):
    self.rx_zero.OnIdle(event)
    for pane in self.receiver_list:
      pane.OnIdle(event)
  def OnGraphData(self, data, index=None):
    if index is None:		# data is for the principal receiver
      self.waterfall.OnGraphData(data)	# Save data for switch to waterfall
      if self.rx_zero == self.graph:
        self.graph.OnGraphData(data)
    elif index < len(self.receiver_list):
      self.receiver_list[index].OnGraphData(data)
  def ChangeSampleRate(self, rate):
    self.graph.sample_rate = rate
    self.waterfall.pane1.sample_rate = rate
    self.waterfall.pane2.sample_rate = rate
    self.waterfall.pane2.display.sample_rate = rate
    for pane in self.receiver_list:
      pane.sample_rate = rate
      tune = pane.txFreq
      vfo = pane.VFO
      pane.txFreq = pane.VFO = -1		# demand change
      pane.ChangeHwFrequency(tune, vfo, 'NewDecim')

class ScopeScreen(wx.Window):
  """Create an oscilloscope screen (mostly used for debug)."""
  def __init__(self, parent, width, data_width, graph_width):
    wx.Window.__init__(self, parent, pos = (0, 0),
       size=(width, -1), style = wx.NO_BORDER)
    self.SetBackgroundColour(conf.color_graph)
    self.font = wx.Font(conf.config_font_size, wx.FONTFAMILY_SWISS, wx.NORMAL,
          wx.FONTWEIGHT_NORMAL, False, conf.quisk_typeface)
    self.SetFont(self.font)
    self.Bind(wx.EVT_SIZE, self.OnSize)
    self.Bind(wx.EVT_PAINT, self.OnPaint)
    self.horizPen = wx.Pen(conf.color_gl, 1, wx.SOLID)
    self.y_scale = conf.scope_y_scale
    self.y_zero = conf.scope_y_zero
    self.yscale = 1
    self.running = 1
    self.doResize = False
    self.width = width
    self.height = 100
    self.originY = self.height // 2
    self.data_width = data_width
    self.graph_width = graph_width
    w = self.charx = self.GetCharWidth()
    h = self.chary = self.GetCharHeight()
    tick = max(2, h * 3 // 10)
    self.originX = w * 3
    self.width = self.originX + self.graph_width + tick + self.charx * 2
    self.line = [(0,0), (1,1)]	# initial fake graph data
    self.fpout = None #open("jim96.txt", "w")
  def OnIdle(self, event):
    if self.doResize:
      self.ResizeGraph()
  def OnSize(self, event):
    self.doResize = True
    event.Skip()
  def ResizeGraph(self, event=None):
    # Change the height of the graph.  Changing the width interactively is not allowed.
    w, h = self.GetClientSize()
    self.height = h
    self.originY = h // 2
    self.doResize = False
    self.Refresh()
  def OnPaint(self, event):
    dc = wx.PaintDC(self)
    dc.SetFont(self.font)
    dc.SetTextForeground(conf.color_graphlabels)
    self.MakeYTicks(dc)
    self.MakeXTicks(dc)
    self.MakeText(dc)
    dc.SetPen(wx.Pen(conf.color_graphline, 1))
    dc.DrawLines(self.line)
  def MakeYTicks(self, dc):
    chary = self.chary
    originX = self.originX
    x3 = self.x3 = originX + self.graph_width	# end of graph data
    dc.SetPen(wx.Pen(conf.color_graphticks,1))
    dc.DrawLine(originX, 0, originX, self.originY * 3)	# y axis
    # Find the size of the Y scale markings
    themax = 2.5e9 * 10.0 ** - ((160 - self.y_scale) / 50.0)	# value at top of screen
    themax = int(themax)
    l = []
    for j in (5, 6, 7, 8):
      for i in (1, 2, 5):
        l.append(i * 10 ** j)
    for yvalue in l:
      n = themax // yvalue + 1			# Number of lines
      ypixels = self.height // n
      if n < 20:
        break
    dc.SetPen(self.horizPen)
    for i in range(1, 1000):
      y = self.originY - ypixels * i
      if y < chary:
        break
      # Above axis
      dc.DrawLine(originX, y, x3, y)	# y line
      # Below axis
      y = self.originY + ypixels * i
      dc.DrawLine(originX, y, x3, y)	# y line
    self.yscale = float(ypixels) / yvalue
    self.yvalue = yvalue
  def MakeXTicks(self, dc):
    originY = self.originY
    x3 = self.x3
    # Draw the X axis
    dc.SetPen(wx.Pen(conf.color_graphticks,1))
    dc.DrawLine(self.originX, originY, x3, originY)
    # Find the size of the X scale markings in microseconds
    for i in (20, 50, 100, 200, 500, 1000, 2000, 5000, 10000, 20000, 50000, 100000):
      xscale = i			# X scale in microseconds
      if application.sample_rate * xscale * 0.000001 > self.width // 30:
        break
    # Draw the X lines
    dc.SetPen(self.horizPen)
    for i in range(1, 999):
      x = int(self.originX + application.sample_rate * xscale * 0.000001 * i + 0.5)
      if x > x3:
        break
      dc.DrawLine(x, 0, x, self.height)	# x line
    self.xscale = xscale
  def MakeText(self, dc):
    if self.running:
      t = "   RUN"
    else:
      t = "   STOP"
    if self.xscale >= 1000:
      t = "%s    X: %d millisec/div" % (t, self.xscale // 1000)
    else:
      t = "%s    X: %d microsec/div" % (t, self.xscale)
    t = "%s   Y: %.0E/div" % (t, self.yvalue)
    dc.DrawText(t, self.originX, self.height - self.chary)
  def OnGraphData(self, data):
    if not self.running:
      if self.fpout:
        for cpx in data:
          re = int(cpx.real)
          im = int(cpx.imag)
          ab = int(abs(cpx))
          ph = math.atan2(im, re) * 360. / (2.0 * math.pi)
          self.fpout.write("%12d %12d %12d %12.1d\n" % (re, im, ab, ph))
      return		# Preserve data on screen
    line = []
    x = self.originX
    ymax = self.height
    for cpx in data:	# cpx is complex raw samples +/- 0 to 2**31-1
      y = cpx.real
      #y = abs(cpx)
      y = self.originY - int(y * self.yscale + 0.5)
      if y > ymax:
        y = ymax
      elif y < 0:
        y = 0
      line.append((x, y))
      x = x + 1
    self.line = line
    self.Refresh()
  def ChangeYscale(self, y_scale):
    self.y_scale = y_scale
    self.doResize = True
  def ChangeYzero(self, y_zero):
    self.y_zero = y_zero
  def SetTxFreq(self, tx_freq, rx_freq):
    pass

class BandscopeScreen(WaterfallScreen):
  def __init__(self, frame, width, data_width, graph_width):
    WaterfallScreen.__init__(self, frame, width, data_width, graph_width)
    try:
      clock = conf.rx_udp_clock
    except:	# In case this is not defined
      clock = 73000000
    self.pane1.sample_rate = self.pane2.sample_rate = clock // 2
    self.VFO = clock // 4
    self.SetVFO(self.VFO)
  def SetTxFreq(self, tx_freq, rx_freq):
    freq = tx_freq + application.VFO - self.VFO
    WaterfallScreen.SetTxFreq(self, freq, freq)
  def SetFrequency(self, freq):		# freq is 7000000, not the offset from VFO
    freq = freq - self.VFO
    WaterfallScreen.SetTxFreq(self, freq, freq)

class FilterScreen(GraphScreen):
  """Create a graph of the receive filter response."""
  def __init__(self, parent, data_width, graph_width):
    GraphScreen.__init__(self, parent, data_width, graph_width)
    self.y_scale = conf.filter_y_scale
    self.y_zero = conf.filter_y_zero
    self.VFO = 0
    self.txFreq = 0
    self.data = []
    self.sample_rate = QS.get_filter_rate(-1, -1)
  def NewFilter(self):
    self.sample_rate = QS.get_filter_rate(-1, -1)
    self.data = QS.get_filter()
    mx = -1000
    for x in self.data:
      if mx < x:
        mx = x
    mx -= 3.0
    f1 = None
    for i in range(len(self.data)):
      x = self.data[i]
      if x > mx:
        if f1 is None:
          f1 = i
        f2 = i
    bw3 = float(f2 - f1) / len(self.data) * self.sample_rate
    mx -= 3.0
    f1 = None
    for i in range(len(self.data)):
      x = self.data[i]
      if x > mx:
        if f1 is None:
          f1 = i
        f2 = i
    bw6 = float(f2 - f1) / len(self.data) * self.sample_rate
    self.display.display_text = "Filter 3 dB bandwidth %.0f, 6 dB %.0f" % (bw3, bw6)
    #self.data = QS.get_tx_filter()
    self.doResize = True
  def OnGraphData(self, data):
    GraphScreen.OnGraphData(self, self.data)
  def ChangeHwFrequency(self, tune, vfo, source='', band='', event=None):
    GraphScreen.SetTxFreq(self, tune, tune)
    application.freqDisplay.Display(tune)
  def SetTxFreq(self, tx_freq, rx_freq):
    pass

class AudioFFTScreen(GraphScreen):
  """Create an FFT graph of the transmit audio."""
  def __init__(self, parent, data_width, graph_width, sample_rate):
    GraphScreen.__init__(self, parent, data_width, graph_width)
    self.y_scale = conf.filter_y_scale
    self.y_zero = conf.filter_y_zero
    self.VFO = 0
    self.txFreq = 0
    self.sample_rate = sample_rate
  def OnGraphData(self, data):
    GraphScreen.OnGraphData(self, data)
  def ChangeHwFrequency(self, tune, vfo, source='', band='', event=None):
    GraphScreen.SetTxFreq(self, tune, tune)
    application.freqDisplay.Display(tune)
  def SetTxFreq(self, tx_freq, rx_freq):
    pass

class HelpScreen(wx.html.HtmlWindow):
  """Create the screen for the Help button."""
  def __init__(self, parent, width, height):
    wx.html.HtmlWindow.__init__(self, parent, -1, size=(width, height))
    self.y_scale = 0
    self.y_zero = 0
    if "gtk2" in wx.PlatformInfo:
      self.SetStandardFonts()
    self.SetFonts("", "", [10, 12, 14, 16, 18, 20, 22])
    # read in text from file help.html in the directory of this module
    self.LoadFile('help.html')
  def OnGraphData(self, data):
    pass
  def ChangeYscale(self, y_scale):
    pass
  def ChangeYzero(self, y_zero):
    pass
  def OnIdle(self, event):
    pass
  def SetTxFreq(self, tx_freq, rx_freq):
    pass
  def OnLinkClicked(self, link):
    webbrowser.open(link.GetHref(), new=2)

class QMainFrame(wx.Frame):
  """Create the main top-level window."""
  def __init__(self, width, height):
    fp = open('__init__.py')		# Read in the title
    self.title = fp.readline().strip()[1:]
    fp.close()
    x = conf.window_posX
    y = conf.window_posY
    wx.Frame.__init__(self, None, -1, self.title, (x, y),
        (width, height), wx.DEFAULT_FRAME_STYLE, 'MainFrame')
    self.SetBackgroundColour(conf.color_bg)
    self.SetForegroundColour(conf.color_bg_txt)
    self.Bind(wx.EVT_CLOSE, self.OnBtnClose)
    if DEBUGSHELL:
      #debugshell = CrustFrame()
      debugshell = ShellFrame(parent=self)
      debugshell.Show()
      debugshell.shell.write("hw=quisk.application.Hardware")
  def OnBtnClose(self, event):
    application.OnBtnClose(event)
    self.Destroy()
  def SetConfigText(self, text):
    if len(text) > 100:
      text = text[0:80] + '|||' + text[-17:]
    self.SetTitle("Radio %s   %s   %s" % (configure.Settings[1], self.title, text))
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
