jmharvey1/SdrCwXcvr/Quisk/quisk.c

#include <Python.h>
#include <stdlib.h>
#include <math.h>
#include <complex.h>	// Use native C99 complex type for fftw3
#include <fftw3.h>
#include <sys/types.h>

#ifdef MS_WINDOWS
#include <Winsock2.h>
#define QUISK_SHUT_RD	SD_RECEIVE
#define QUISK_SHUT_BOTH	SD_BOTH
static int cleanupWSA = 0;			// Must we call WSACleanup() ?
#else
#include <sys/socket.h>
#include <arpa/inet.h>
#include <netinet/in.h>
#define INVALID_SOCKET	-1
#define QUISK_SHUT_RD	SHUT_RD
#define QUISK_SHUT_BOTH	SHUT_RDWR
#endif

#include "quisk.h"
#include "filter.h"

#define DEBUG		0

// These are used for input/output of radio samples from/to a file.  The SAMPLES_FROM_FILE is 0 for
// normal operation, 1 to record samples to a file, 2 to play samples from a file.  Rate must be 48k.
#define SAMPLES_FROM_FILE	0

#define FM_FILTER_DEMPH		300.0				// Frequency of FM lowpass de-emphasis filter
#define AGC_DELAY			15					// Delay in AGC buffer in milliseconds
#define FFT_ARRAY_SIZE		4					// Number of FFTs
#define MULTIRX_FFT_MULT	8					// multirx FFT size is a multiple of graph size
#define MAX_RX_CHANNELS		3					// maximum paths to decode audio
#define MAX_RX_FILTERS		3					// maximum number of receiver filters

static int fft_error;			// fft error count
typedef struct fftd {
	fftw_complex * samples;		// complex data for fft
	int index;					// position of next fft sample
	int filled;					// whether the fft is ready to run
	int block;					// block number 0, 1, ...
} fft_data;

typedef struct mrx_fftd {		// FFT data for sub-receivers
	fftw_complex * samples;		// complex data for fft of size multirx_fft_width
	int index;					// position of next fft sample
} mrx_fft_data;

struct AgcState {		// Store state information for the AGC
	double max_out;		// Must initialize to maximum output level 0.0 to 1.0.
	int sample_rate;	// Must initialize this to the sample rate or zero.
	int buf_size;		// Must initialize this to zero.
	int index_read;
	int index_start;
	int is_clipping;
	double themax;
	double gain;
	double delta;
	double target_gain;
	double time_release;
	complex double * c_samp;
};

static fft_data fft_data_array[FFT_ARRAY_SIZE];		// Data for several FFTs
static int fft_data_index = 0;						// Write the current samples to this FFT
static fftw_plan quisk_fft_plan;

static double * fft_window;		// Window for FFT data
static double * current_graph;	// current graph data as returned
static int use_remove_dc=1;		// Remove DC from samples

static PyObject * QuiskError;		// Exception for this module
static PyObject * pyApp;		// Application instance
static int fft_size;			// size of fft, e.g. 1024
int data_width;				// number of points to return as graph data; fft_size * n
int rxMode;					// 0 to 13: CWL, CWU, LSB, USB, AM, FM, EXT, DGT-U, DGT-L, DGT-IQ, IMD, FDV-U, FDV-L, DGT-FM
int quisk_noise_blanker;		// noise blanker level, 0 for off
int quiskTxHoldState;			// hold Tx until the repeater frequency shift is complete
static int quisk_auto_notch;	// auto notch control
PyObject * quisk_pyConfig=NULL;	// Configuration module instance
long quisk_mainwin_handle;		// Handle of the main window
static int graphX;			// Origin of first X value for graph data
static int graphY;			// Origin of 0 dB for graph data
static double graphScale;		// Scale factor for graph
static complex double testtonePhase;        // Phase increment for test tone
double quisk_audioVolume;		// Audio output level, 0.0 to 1.0
double quisk_ctcss_freq;		// CTCSS repeater access tone frequency in Hertz, or zero
static double cFilterI[MAX_RX_FILTERS][MAX_FILTER_SIZE];	// Digital filter coefficients for receivers
static double cFilterQ[MAX_RX_FILTERS][MAX_FILTER_SIZE];	// Digital filter coefficients
static int sizeFilter;			// Number of coefficients for filters
static int isFDX;			// Are we in full duplex mode?
static int filter_bandwidth;		// Current filter bandwidth in Hertz for filter zero
static int quisk_decim_srate;				// Sample rate after decimation
static int quisk_filter_srate=48000;		// Frequency for filters
static int split_rxtx;						// Are we in split rx/tx mode?
static int kill_audio;					// Replace radio sound with silence
static int quisk_transmit_mode;			// Are we in transmit mode for semi-break-in CW?
static int fft_sample_rate;				// Sample rate on the graph (not the audio channel) -fft_srate/2 < freq < +fft_srate/2
static int scan_blocks=0;			// Number of FFT blocks for scan; or zero
static int scan_sample_rate=1;      // Sample rate to use while scanning
static double scan_valid=0.84;		// Fraction of each FFT block that is valid
static int scan_vfo0;
static int scan_deltaf;
static int graph_refresh;				// Graph refresh rate from the config file
static int multiple_sample_rates=0;     // Hardware supports multiple different sample rates
static int vfo_screen;                  // The VFO (center) frequency on the FFT screen
static int vfo_audio;                   // VFO frequency for the audio channel
static int is_PTT_down;					// state 0/1 of PTT button
static int sample_bytes=3;				// number of bytes in each I or Q sample

static int multirx_data_width;			// width of graph data to return
static int multirx_fft_width;			// size of FFT samples
int quisk_multirx_count;				// number of additional receivers zero or 1, 2, 3, ...
static int quisk_multirx_state;			// state of hermes receivers
static mrx_fft_data multirx_fft_data[QUISK_MAX_RECEIVERS];		// FFT data for the sub-receivers
static int multirx_fft_next_index;								// index of the receiver for the next FFT to return
static double multirx_fft_next_time;							// timing interval for multirx FFT
static int multirx_fft_next_state;								// state of multirx FFT: 0 == filling, 1 == ready, 2 == done
static fftw_plan multirx_fft_next_plan;							// fftw3 plan for multirx FFTs
static fftw_complex * multirx_fft_next_samples;					// sample buffer for multirx FFT
static int multirx_play_method;			// 0== both, 1==left, 2==right
static int multirx_play_channel = -1;	// index of the channel to play; or -1
static int multirx_freq[QUISK_MAX_RECEIVERS];			// tune frequency for channel
static int multirx_mode[QUISK_MAX_RECEIVERS];			// mode CW, SSB, etc. for channel

static complex double * multirx_cSamples[QUISK_MAX_RECEIVERS];		// samples for the sub-receivers
static int multirx_sample_size;					// current size of the sub-receiver sample array

static double sidetoneVolume;		// Audio output level of the CW sidetone, 0.0 to 1.0
static int keyupDelay;			// Play silence after sidetone ends
static complex double sidetonePhase;		// Phase increment for sidetone
int quisk_sidetoneCtrl;			// sidetone control value 0 to 1000

static double agcReleaseGain=80;		// AGC maximum gain
static double agc_release_time = 1.0;	// Release time in seconds
static double squelch_level;			// setting of squelch control
static int quisk_invert_spectrum = 0;	// Invert the input RF spectrum
static void process_agc(struct AgcState *, complex double *, int, int);

static double Smeter;			// Measured RMS signal strength
static int rx_tune_freq;		// Receive tuning frequency as +/- sample_rate / 2
int quisk_tx_tune_freq;			// Transmit tuning frequency as +/- sample_rate / 2
static int rit_freq;			// RIT frequency in Hertz

#define RX_UDP_SIZE		1442		// Expected size of UDP samples packet
static int rx_udp_socket = INVALID_SOCKET;		// Socket for receiving ADC samples from UDP
int quisk_rx_udp_started = 0;		// Have we received any data yet?
int quisk_using_udp = 0;			// Are we using rx_udp_socket?  No longer used, but provided for backward compatibility.
static double rx_udp_gain_correct = 0;		// Small correction for different decimation rates
static double rx_udp_clock;			// Clock frequency for UDP samples
int quisk_use_rx_udp;						// from the config file

static int is_little_endian;		// Test byte order; is it little-endian?
unsigned char quisk_pc_to_hermes[17 * 4];			// data to send from PC to Hermes hardware
static unsigned char quisk_hermes_to_pc[5 * 4];		// data received from the Hermes hardware

enum quisk_rec_state quisk_record_state = IDLE;
static float * quisk_record_buffer;
static int quisk_record_bufsize;
static int quisk_record_index;
static int quisk_play_index;
static int quisk_mic_index;
static int quisk_record_full;

// These are used to measure the frequency of a continuous RF signal.
static void measure_freq(complex double *, int, int);
static double measured_frequency;
static int measure_freq_mode=0;

//These are used to measure the demodulated audio voltage
static double measured_audio;
static double measure_audio_sum;
static int measure_audio_count;
static int measure_audio_time=1;

// These are used for playback of a WAV file.
static int wavStart;			// Sound data starts at this offset
static int wavEnd;				// End of sound data
static FILE * wavFp;			// File pointer for WAV file input
static int wavPosSound;			// Current position for radio sound
static int wavPosMic;			// Current position for microphone

#if SAMPLES_FROM_FILE
static struct QuiskWav hWav;

int QuiskWavWriteOpen(struct QuiskWav * hWav, char * file_name, short format, short nChan, short bytes, int rate, double scale)
{
	unsigned int u;		// must be 4 bytes
	unsigned short s;	// must be 2 bytes

    hWav->format = format;
    hWav->nChan = nChan;
    hWav->bytes_per_sample = bytes;
    hWav->sample_rate = rate;
    hWav->scale = scale;
	hWav->samples = 0;    // number of samples written
	hWav->fp = fopen(file_name, "wb");
	if ( ! hWav->fp)
		return 0;
	if (format == 0)	// RAW format - no header
		return 1;
	if (fwrite("RIFF", 1, 4, hWav->fp) != 4) {
		fclose(hWav->fp);
		hWav->fp = NULL;
		return 0;
	}
    if (format == 1)    // PCM
	    u = 36;
    else
	    u = 50;
	fwrite(&u, 4, 1, hWav->fp);
	fwrite("WAVE", 1, 4, hWav->fp);
	fwrite("fmt ", 1, 4, hWav->fp);
    if (format == 1)    // PCM
	    u = 16;
    else
	    u = 18;
	fwrite(&u, 4, 1, hWav->fp);
	fwrite(&format, 2, 1, hWav->fp);        // format
	fwrite(&nChan, 2, 1, hWav->fp);         // number of channels
	fwrite(&rate, 4, 1, hWav->fp);          // sample rate
	u = rate * bytes * nChan;
	fwrite(&u, 4, 1, hWav->fp);
	s = bytes * nChan; 
	fwrite(&s, 2, 1, hWav->fp);
    s = bytes * 8;
	fwrite(&s, 2, 1, hWav->fp);
    if (format != 1) {
	    s = 0; 
	    fwrite(&s, 2, 1, hWav->fp);
	    fwrite("fact", 1, 4, hWav->fp);
	    u = 4;
	    fwrite(&u, 4, 1, hWav->fp);
	    u = 0;
	    fwrite(&u, 4, 1, hWav->fp);
    }
	fwrite("data", 1, 4, hWav->fp);
	u = 0;
	fwrite(&u, 4, 1, hWav->fp);
    return 1;
}

void QuiskWavWriteC(struct QuiskWav * hWav, complex double * cSamples, int nSamples)
{  // Record the samples to a WAV file, two float samples I/Q.  Always use IEEE format 3.
	int j;	// TODO: add other formats
	float samp;			// must be 4 bytes

    if ( ! hWav->fp)
        return;
    // append the samples
	hWav->samples += (unsigned int)nSamples;
	fseek(hWav->fp, 0, SEEK_END);		// seek to the end
	for (j = 0; j < nSamples; j++) {
		samp = creal(cSamples[j]) * hWav->scale;
		fwrite(&samp, 4, 1, hWav->fp);
		samp = cimag(cSamples[j]) * hWav->scale;
		fwrite(&samp, 4, 1, hWav->fp);
	}
    // write the sizes to the header
    QuiskWavWriteD(hWav, NULL, 0);
}

void QuiskWavWriteD(struct QuiskWav * hWav, double * dSamples, int nSamples)
{  // Record the samples to a file, one channel.
	int j;
	float samp;			// must be 4 bytes
	unsigned int u;		// must be 4 bytes
	int i;      		// must be 4 bytes
    char c;             // must be 1 byte
    short s;            // must be 2 bytes

    if ( ! hWav->fp)
        return;
    // append the samples
	hWav->samples += (unsigned int)nSamples;
	fseek(hWav->fp, 0, SEEK_END);		// seek to the end
    if ( ! dSamples) {
        ;       // Only update the header
    }
    else if (hWav->format == 3) {        // float
    	for (j = 0; j < nSamples; j++) {
		    samp = dSamples[j] * hWav->scale;
		    fwrite(&samp, 4, 1, hWav->fp);
	    }
	}
    else {      // PCM integer
        switch (hWav->bytes_per_sample) {
        case 1:
    	    for (j = 0; j < nSamples; j++) {
                c = (char)(dSamples[j] * hWav->scale);
                fwrite(&c, 1, 1, hWav->fp);
            }
            break;
        case 2:
    	    for (j = 0; j < nSamples; j++) {
                s = (short)(dSamples[j] * hWav->scale);
                fwrite(&s, 2, 1, hWav->fp);
            }
            break;
        case 4:
    	    for (j = 0; j < nSamples; j++) {
                i = (int)(dSamples[j] * hWav->scale);
                fwrite(&i, 4, 1, hWav->fp);
            }
            break;
        }
    }
    // write the sizes to the header
    if (hWav->format == 0) {        // RAW format
		;
	}
    else if (hWav->format == 3) {        // float
	    fseek(hWav->fp, 54, SEEK_SET);	// seek from the beginning
	    u = hWav->bytes_per_sample * hWav->nChan * hWav->samples;
	    fwrite(&u, 4, 1, hWav->fp);
	    fseek(hWav->fp, 4, SEEK_SET);
	    u += 50 ;
	    fwrite(&u, 4, 1, hWav->fp);
	    fseek(hWav->fp, 46, SEEK_SET);
	    u = hWav->samples * hWav->nChan;
	    fwrite(&u, 4, 1, hWav->fp);
    }
    else {
	    fseek(hWav->fp, 40, SEEK_SET);
	    u = hWav->bytes_per_sample * hWav->nChan * hWav->samples;
	    fwrite(&u, 4, 1, hWav->fp);
	    fseek(hWav->fp, 4, SEEK_SET);
	    u += 36 ;
	    fwrite(&u, 4, 1, hWav->fp);
    }
    if (hWav->samples > 536870000)    // 2**32 / 8
		QuiskWavClose(hWav);
}

int QuiskWavReadOpen(struct QuiskWav * hWav, char * file_name, short format, short nChan, short bytes, int rate, double scale)
{	// TODO: Get parameters from the WAV file header.
	char name[5];
	int size;

    hWav->format = format;
    hWav->nChan = nChan;
    hWav->bytes_per_sample = bytes;
    hWav->sample_rate = rate;
    hWav->scale = scale;
    hWav->fp = fopen(file_name, "rb");
   	if (!hWav->fp)
    	return 0;
	if (hWav->format == 0) {	// RAW format
		fseek(hWav->fp, 0, SEEK_END);		// seek to the end
		hWav->fpEnd = ftell(hWav->fp);
		hWav->fpStart = hWav->fpPos = 0;
		return 1;
	}
   	hWav->fpEnd = 0;
   	while (1) {		// WAV format
   		if (fread (name, 4, 1, hWav->fp) != 1)
   			return 0;
   		if (fread (&size, 4, 1, hWav->fp) != 1)
   			return 0;
   		name[4] = 0;
   		//printf("name %s size %d\n", name, size);
   		if (!strncmp(name, "RIFF", 4))
   			fseek (hWav->fp, 4, SEEK_CUR);	// Skip "WAVE"
   		else if (!strncmp(name, "data", 4)) {	// sound data starts here
   			hWav->fpStart = ftell(hWav->fp);
   			hWav->fpEnd = hWav->fpStart + size;
			hWav->fpPos = hWav->fpStart;
   			break;
   		}
   		else	// Skip other records
   			fseek (hWav->fp, size, SEEK_CUR);
   	}
   	//printf("start %d  end %d\n", hWav->fpStart, hWav->fpEnd);
   	if (!hWav->fpEnd) {		// Failure to find "data" record
   		fclose(hWav->fp);
   		hWav->fp = NULL;
		return 0;
   	}
    return 1;
}

void QuiskWavReadC(struct QuiskWav * hWav, complex double * cSamples, int nSamples)
{	// Always uses format 3.  TODO: add other formats.
	int i;
    float fi, fq;
	double di, dq;

#if 0
	double noise;
	noise = 1.6E6;
	for (i = 0; i < nSamples; i++) {
		di = ((float)random() / RAND_MAX - 0.5) * noise;
		dq = ((float)random() / RAND_MAX - 0.5) * noise;
		cSamples[i] = di + I * dq;
	}
#endif
    if (hWav->fp && nSamples > 0) {
    	fseek (hWav->fp, hWav->fpPos, SEEK_SET);
    	for (i = 0; i < nSamples; i++) {
    		if (fread(&fi, 4, 1, hWav->fp) != 1)
    			break;
    		if (fread(&fq, 4, 1, hWav->fp) != 1)
    			break;
    		di = fi * hWav->scale;
    		dq = fq * hWav->scale;
    		cSamples[i] += di + I * dq;
    		hWav->fpPos += hWav->bytes_per_sample * hWav->nChan;
    		if (hWav->fpPos >= hWav->fpEnd)
    			hWav->fpPos = hWav->fpStart;
    	}
    }
}

void QuiskWavReadD(struct QuiskWav * hWav, double * dSamples, int nSamples)
{
	int j;
    float samp;
	int i;      		// must be 4 bytes
    char c;             // must be 1 byte
    short s;            // must be 2 bytes

    if (hWav->fp && nSamples > 0) {
    	fseek (hWav->fp, hWav->fpPos, SEEK_SET);
    	for (j = 0; j < nSamples; j++) {
			if (hWav->format == 3) {		// float
				if (fread(&samp, 4, 1, hWav->fp) != 1)
					return;
			}
			else {      // PCM integer
				switch (hWav->bytes_per_sample) {
				case 1:
					if (fread(&c, 1, 1, hWav->fp) != 1)
						return;
					samp = c;
					break;
				case 2:
					if (fread(&s, 2, 1, hWav->fp) != 1)
						return;
					samp = s;
					break;
				case 4:
					if (fread(&i, 4, 1, hWav->fp) != 1)
						return;
					samp = i;
					break;
				}
			}
    		dSamples[j] = samp * hWav->scale;
    		hWav->fpPos += hWav->bytes_per_sample * hWav->nChan;
    		if (hWav->fpPos >= hWav->fpEnd)
    			hWav->fpPos = hWav->fpStart;
    	}
    }
}

void QuiskWavClose(struct QuiskWav * hWav)
{
    if (hWav->fp) {
        fclose(hWav->fp);
        hWav->fp = NULL;
    }
}
#endif

// These are used for digital voice codecs
ty_dvoice_codec_rx  pt_quisk_freedv_rx;
ty_dvoice_codec_tx  pt_quisk_freedv_tx;

void quisk_dvoice_freedv(ty_dvoice_codec_rx rx, ty_dvoice_codec_tx tx)
{
	pt_quisk_freedv_rx = rx;
	pt_quisk_freedv_tx = tx;
}
#if 0
static int fFracDecim(double * dSamples, int nSamples, double fdecim)
{  // fractional decimation by fdecim > 1.0
	int i, nout;
	double xm0, xm1, xm2, xm3;
	static double dindex = 1;
	static double y0=0, y1=0, y2=0, y3=0;
	static int in=0, out=0;

	in += nSamples;
	nout = 0;
	for (i = 0; i < nSamples; i++) {
		y3 = dSamples[i];
		if (dindex < 1 || dindex >= 2.4)
			printf ("dindex %.5f  fdecim %.8f\n", dindex, fdecim);
		if (dindex < 2) {
#if 0
				dSamples[nout++] = (1 - (dindex - 1)) * y1 + (dindex - 1) * y2;
#else
				xm0 = dindex - 0;
				xm1 = dindex - 1;
				xm2 = dindex - 2;
				xm3 = dindex - 3;
				dSamples[nout++] = xm1 * xm2 * xm3 * y0 / -6.0 + xm0 * xm2 * xm3 * y1 / 2.0 +
					xm0 * xm1 * xm3 * y2 / -2.0 + xm0 * xm1 * xm2 * y3 / 6.0;
#endif
			out++;
			dindex += fdecim - 1;
			y0 = y1;
			y1 = y2;
			y2 = y3;
		}
		else {
			if (dindex > 2.5) printf ("Skip at %.2f\n", dindex);
			y0 = y1;
			y1 = y2;
			y2 = y3;
			dindex -= 1;
		}
	}
	//printf ("in %d out %d\n", in, out);
	return nout;
}
#endif
static int cFracDecim(complex double * cSamples, int nSamples, double fdecim)
{
// Fractional decimation of I/Q signals works poorly because it introduces aliases and birdies.
	int i, nout;
	double xm0, xm1, xm2, xm3;
	static double dindex = 1;
	static complex double c0=0, c1=0, c2=0, c3=0;
	static int in=0, out=0;

	in += nSamples;
	nout = 0;
	for (i = 0; i < nSamples; i++) {
		c3 = cSamples[i];
		if (dindex < 1 || dindex >= 2.4)
			printf ("dindex %.5f  fdecim %.8f\n", dindex, fdecim);
		if (dindex < 2) {
#if 0
				cSamples[nout++] = (1 - (dindex - 1)) * c1 + (dindex - 1) * c2;
#else
				xm0 = dindex - 0;
				xm1 = dindex - 1;
				xm2 = dindex - 2;
				xm3 = dindex - 3;
				cSamples[nout++] =
					(xm1 * xm2 * xm3 * c0 / -6.0 + xm0 * xm2 * xm3 * c1 / 2.0 +
					xm0 * xm1 * xm3 * c2 / -2.0 + xm0 * xm1 * xm2 * c3 / 6.0);
#endif
			out++;
			dindex += fdecim - 1;
			c0 = c1;
			c1 = c2;
			c2 = c3;
		}
		else {
			if (dindex > 2.5) printf ("Skip at %.2f\n", dindex);
			c0 = c1;
			c1 = c2;
			c2 = c3;
			dindex -= 1;
		}
	}
	//printf ("in %d out %d\n", in, out);
	return nout;
}

#define QUISK_NB_HWINDOW_SECS	500.E-6	// half-size of blanking window in seconds
static void NoiseBlanker(complex double * cSamples, int nSamples)
{
	static complex double * cSaved = NULL;
	static double  * dSaved = NULL;
	static double save_sum;
	static int save_size, hwindow_size, state, index, win_index;
	static int sample_rate = -1;
	int i, j, k, is_pulse;
	double mag, limit;
	complex double samp;
#if DEBUG
	static time_t time0 = 0;
	static int debug_count = 0;
#endif

	if (quisk_noise_blanker <= 0)
		return;
	if (quisk_sound_state.sample_rate != sample_rate) {	// Initialization
		sample_rate = quisk_sound_state.sample_rate;
		state = 0;
		index = 0;
		win_index = 0;
		save_sum = 0.0;
		hwindow_size = (int)(sample_rate * QUISK_NB_HWINDOW_SECS + 0.5);
		save_size = hwindow_size * 3;	// number of samples in the average
		i = save_size * sizeof(double);
		dSaved = (double *) realloc(dSaved, i);
		memset (dSaved, 0, i);
		i = save_size * sizeof(complex double);
		cSaved = (complex double *)realloc(cSaved, i);
		memset (cSaved, 0, i);
#if DEBUG
		printf ("Noise blanker: save_size %d  hwindow_size %d\n",
			save_size, hwindow_size);
#endif
	}
	switch(quisk_noise_blanker) {
	case 1:
	default:
		limit = 6.0;
		break;
	case 2:
		limit = 4.0;
		break;
	case 3:
		limit = 2.5;
		break;
	}
	for (i = 0; i < nSamples; i++) {
		// output oldest sample, save newest
		samp = cSamples[i];				// newest sample
		cSamples[i] = cSaved[index];	// oldest sample
		cSaved[index] = samp;
		// use newest sample
		mag = cabs(samp);
		save_sum -= dSaved[index];	// remove oldest sample magnitude
		dSaved[index] = mag;		// save newest sample magnitude
		save_sum += mag;			// update sum of samples
		if (mag <= save_sum / save_size * limit)	// see if we have a large pulse
			is_pulse = 0;
		else
			is_pulse = 1;
		switch (state) {
		case 0:		// Normal state
			if (is_pulse) {		// wait for a pulse
				state = 1;
				k = index;
				for (j = 0; j < hwindow_size; j++) {	// apply window to prior samples
					cSaved[k--] *= (double)j / hwindow_size;
					if (k < 0)
						k = save_size - 1;
				}
			}
			else if (win_index) {		// pulses have stopped, increase window to 1.0
				cSaved[index] *= (double)win_index / hwindow_size;
				if (++win_index >= hwindow_size)
					win_index = 0;	// no more window
			}
			break;
		case 1:		// we got a pulse
			cSaved[index] = 0;	// zero samples until the pulses stop
			if ( ! is_pulse) {
				// start raising the window, but be prepared to window another pulse
				state = 0;
				win_index = 1;
			}
			break;
		}
#if DEBUG
		if (debug_count) {
			printf ("%d", is_pulse);
			if (--debug_count == 0)
				printf ("\n");
		}
		else if (is_pulse && time(NULL) != time0) {
			time0 = time(NULL);
			debug_count = hwindow_size * 2;
			printf ("%d", is_pulse);
		}
#endif
		if (++index >= save_size)
			index = 0;
	}
	return;
}

#define NOTCH_DEBUG			0
#define NOTCH_DATA_SIZE					2048
#define NOTCH_FILTER_DESIGN_SIZE		NOTCH_DATA_SIZE / 4
#define NOTCH_FILTER_SIZE		(NOTCH_FILTER_DESIGN_SIZE - 1)
#define NOTCH_FILTER_FFT_SIZE	(NOTCH_FILTER_SIZE / 2 + 1)
#define NOTCH_DATA_START_SIZE	(NOTCH_FILTER_SIZE - 1)
#define NOTCH_DATA_OUTPUT_SIZE	(NOTCH_DATA_SIZE - NOTCH_DATA_START_SIZE)
#define NOTCH_FFT_SIZE			(NOTCH_DATA_SIZE / 2 + 1)
static void dAutoNotch(double * dsamples, int nSamples, int sidetone, int rate)
{
	int i, j, k, i1, i2, inp, signal, delta_sig, delta_i1, half_width;
	double d, d1, d2, avg;
	static int old1, count1, old2, count2;
	static int index;
	static fftw_plan planFwd=NULL;
	static fftw_plan planRev,fltrFwd, fltrRev;
	static double data_in[NOTCH_DATA_SIZE];
	static double data_out[NOTCH_DATA_SIZE];
	static complex double notch_fft[NOTCH_FFT_SIZE];
	static double fft_window[NOTCH_DATA_SIZE];
	static double fltr_in[NOTCH_DATA_SIZE];
	static double fltr_out[NOTCH_FILTER_DESIGN_SIZE];
	static complex double fltr_fft[NOTCH_FFT_SIZE];
	static double average_fft[NOTCH_FFT_SIZE];
	static int fltrSig;
#if NOTCH_DEBUG
	static char * txt;
	double dmax;
#endif

	if ( ! planFwd) {		// set up FFT plans
		planFwd = fftw_plan_dft_r2c_1d(NOTCH_DATA_SIZE, data_in, notch_fft, FFTW_MEASURE);
		planRev = fftw_plan_dft_c2r_1d(NOTCH_DATA_SIZE, notch_fft, data_out, FFTW_MEASURE);		// destroys notch_fft
		fltrFwd = fftw_plan_dft_r2c_1d(NOTCH_DATA_SIZE, fltr_in, fltr_fft, FFTW_MEASURE);
		fltrRev = fftw_plan_dft_c2r_1d(NOTCH_FILTER_DESIGN_SIZE, fltr_fft, fltr_out, FFTW_MEASURE);
		for (i = 0; i < NOTCH_FILTER_SIZE; i++)
			fft_window[i] = 0.50 - 0.50 * cos(2. * M_PI * i / (NOTCH_FILTER_SIZE));	// Hanning
			//fft_window[i] = 0.54 - 0.46 * cos(2. * M_PI * i / (NOTCH_FILTER_SIZE));	// Hamming
	}
	if ( ! dsamples) {		// initialize
		index = NOTCH_DATA_START_SIZE;
		fltrSig = -1;
		old1 = old2 = 0;
		count1 = count2 = -4;
		memset(data_out, 0, sizeof(double) * NOTCH_DATA_SIZE);
		memset(data_in, 0, sizeof(double) * NOTCH_DATA_SIZE);
		memset(average_fft, 0, sizeof(double) * NOTCH_FFT_SIZE);
		return;
	}
	if ( ! quisk_auto_notch)
		return;
	// index into FFT data = frequency * 2 * NOTCH_FFT_SIZE / rate
	// index into filter design = frequency * 2 * NOTCH_FILTER_FFT_SIZE / rate
	for (inp = 0; inp < nSamples; inp++) {
		data_in[index] = dsamples[inp];
		dsamples[inp] = data_out[index];
		if (++index >= NOTCH_DATA_SIZE) {	// we have a full FFT of samples
			index = NOTCH_DATA_START_SIZE;
			fftw_execute(planFwd);		// Calculate forward FFT
			// Find maximum FFT bins
			delta_sig = (300 * 2 * NOTCH_FFT_SIZE + rate / 2) / rate;	// small frequency interval
			delta_i1 = (400 * 2 * NOTCH_FFT_SIZE + rate / 2) / rate;	// small frequency interval
			if (sidetone != 0)			// For CW, accept a signal at the frequency of the RIT
				signal = (abs(sidetone) * 2 * NOTCH_FFT_SIZE + rate / 2) / rate;
			else
				signal = -999;
			avg = 1;
#if NOTCH_DEBUG
			dmax = 0;
#endif
			d1 = 0;
			i1 = 0;		// First maximum signal
			for (i = 0; i < NOTCH_FFT_SIZE; i++) {
				d = cabs(notch_fft[i]);
				avg += d;
				//average_fft[i] = 0.9 * average_fft[i] + 0.1 * d;
				average_fft[i] = 0.5 * average_fft[i] + 0.5 * d;
				if (abs(i - signal) > delta_sig && average_fft[i] > d1) {
					d1 = average_fft[i];
					i1 = i;
#if NOTCH_DEBUG
					dmax = d;
#endif
				}
			}
			if (abs(i1 - old1) < 3)		// See if the maximum bin i1 is changing
				count1++;
			else
				count1--;
			if (count1 > 4)
				count1 = 4;
			else if (count1 < -1)
				count1 = -1;
			if (count1 < 0)
				old1 = i1;
			avg /= NOTCH_FFT_SIZE;
			d2 = 0;
			i2 = 0;		// Next maximum signal not near the first
			for (i = 0; i < NOTCH_FFT_SIZE; i++) {
				if (abs(i - signal) > delta_sig && abs(i - i1) > delta_i1 && average_fft[i] > d2) {
					d2 = average_fft[i];
					i2 = i;
				}
			}
			if (abs(i2 - old2) < 3)		// See if the maximum bin i2 is changing
				count2++;
			else
				count2--;
			if (count2 > 4)
				count2 = 4;
			else if (count2 < -2)
				count2 = -2;
			if (count2 < 0)
				old2 = i2;

			if (count1 > 0 && count2 > 0)
				k = i1 + 10000 * i2;	// trial filter index
			else if(count1 > 0)
				k = i1;
			else
				k = 0;
			// Make the filter if it is different
			if (fltrSig != k) {
				fltrSig = k;
				half_width = (100 * 2 * NOTCH_FILTER_FFT_SIZE + rate / 2) / rate;	// half the width of the notch
				if (half_width < 3)
					half_width = 3;
				for (i = 0; i < NOTCH_FILTER_FFT_SIZE; i++)
					fltr_fft[i] = 1.0;
				k = (i1 + 2) / 4;		// Ratio of index values is 4
#if NOTCH_DEBUG
				txt = "Fxx";
#endif
				if (count1 > 0) {
#if NOTCH_DEBUG
					txt = "F1";
#endif
					for (i = -half_width; i <= half_width; i++) {
						j = k + i;
						if (j >= 0 && j < NOTCH_FILTER_FFT_SIZE)
							fltr_fft[j] = 0.0;
					}
				}
				k = (i2 + 2) / 4;		// Ratio of index values is 4
				if (count1 > 0 && count2 > 0) {
#if NOTCH_DEBUG
					txt = "F12";
#endif
					for (i = -half_width; i <= half_width; i++) {
						j = k + i;
						if (j >= 0 && j < NOTCH_FILTER_FFT_SIZE)
							fltr_fft[j] = 0.0;
					}
				}
				fftw_execute(fltrRev);
				// center the coefficient zero, make the filter symetric, reduce the size by one
				memmove(fltr_out + NOTCH_FILTER_DESIGN_SIZE / 2 - 1, fltr_out, sizeof(double) * (NOTCH_FILTER_SIZE / 2 - 1));
				for (i = NOTCH_FILTER_DESIGN_SIZE / 2 - 2, j = NOTCH_FILTER_DESIGN_SIZE / 2; i >= 0; i--, j++)
					fltr_out[i] = fltr_out[j];
				for (i = 0; i < NOTCH_FILTER_SIZE; i++)
					fltr_in[i] = fltr_out[i] * fft_window[i] / NOTCH_FILTER_DESIGN_SIZE;
				for (i = NOTCH_FILTER_SIZE; i < NOTCH_DATA_SIZE; i++)
					fltr_in[i] = 0.0;
				fftw_execute(fltrFwd);		// The filter is fltr_fft[]
			}
#if NOTCH_DEBUG
			printf("Max %12.0lf  frequency index1 %3d %5d %12.0lf  index2 %3d %5d %12.0lf  avg %12.0lf  %s\n", dmax, count1, i1, d1, count2, i2, d2, avg, txt);
#endif
			for (i = 0; i < NOTCH_FFT_SIZE; i++)	// Apply the filter
				notch_fft[i] *= fltr_fft[i];
			fftw_execute(planRev);		// Calculate inverse FFT
			memmove(data_in, data_in + NOTCH_DATA_OUTPUT_SIZE, NOTCH_DATA_START_SIZE * sizeof(double));
			for (i = NOTCH_DATA_START_SIZE; i < NOTCH_DATA_SIZE; i++)
				data_out[i] /= NOTCH_DATA_SIZE / 20;	// Empirical
		}
	}
	return;
}

#if 0
static complex double * audio_fft;
static int audio_fft_ready=0;
static void calc_audio_graph(double * dsamples, int nSamples)
{ // Calculate an FFT for the audio data
	int i, inp;
	static int index;
	static int audio_fft_size;
	static fftw_plan plan;
	static double * data_in;
	static double * fft_window;

	if ( ! dsamples) {		// malloc new space and initialize
		index = 0;
		audio_fft_size = data_width;
		data_in = (double *)malloc(audio_fft_size * sizeof(double));
		fft_window = (double *)malloc(audio_fft_size * sizeof(double));
		audio_fft = (complex double *)malloc((audio_fft_size / 2 + 1) * sizeof(complex double));
		plan = fftw_plan_dft_r2c_1d(audio_fft_size, data_in, audio_fft, FFTW_MEASURE);
		for (i = 0; i < audio_fft_size; i++)
			fft_window[i] = 0.50 - 0.50 * cos(2. * M_PI * i / audio_fft_size);	// Hanning
		return;
	}
	for (inp = 0; inp < nSamples; inp++) {
		data_in[index] = dsamples[inp];
		if (++index >= audio_fft_size) {	// we have a full FFT of samples
			index = 0;
			for (i = 0; i < audio_fft_size; i++)
				data_in[i] *= fft_window[i];	// multiply by window
			fftw_execute(plan);		// Calculate forward FFT
			audio_fft_ready = (audio_fft_ready + 1) & 0xff;
			//printf("Audio FFT %d %d %d\n", audio_fft_ready, audio_fft_size, data_width);
		}
	}
}

static PyObject * get_audio_graph(PyObject * self, PyObject * args)
{
	int i, j, k;
	static int seq = 0;
	double d2, scale;
	PyObject * tuple2;

	if (!PyArg_ParseTuple (args, ""))
		return NULL;

	if (seq == audio_fft_ready) {		// a new graph is not yet available
		Py_INCREF (Py_None);
		return Py_None;
	}
	seq = audio_fft_ready;
	tuple2 = PyTuple_New(data_width);
	scale = log10((double)data_width) + 31.0 * log10(2.0);
	scale *= 20.0;
	j = 0;
	k = data_width / 2 - 1;
	for (i = 0; i < data_width / 2; i++, k--) {
		d2 = 20.0 * log10(cabs(audio_fft[k])) - scale;
		if (d2 < -200)
			d2 = -200;
		PyTuple_SetItem(tuple2, j++, PyFloat_FromDouble(d2));
	}
	for (i = 0; i < data_width / 2; i++) {
		d2 = 20.0 * log10(cabs(audio_fft[i])) - scale;
		if (d2 < -200)
			d2 = -200;
		PyTuple_SetItem(tuple2, j++, PyFloat_FromDouble(d2));
	}
	if (j < data_width)
		PyTuple_SetItem(tuple2, j++, PyFloat_FromDouble(-200.0));
	return tuple2;
}
#else
static PyObject * get_audio_graph(PyObject * self, PyObject * args)
{
	if (!PyArg_ParseTuple (args, ""))
		return NULL;

	Py_INCREF (Py_None);
	return Py_None;
}
#endif

static complex double dRxFilterOut(complex double sample, int bank, int nFilter)
{	// Rx FIR filter; bank is the static storage index, and must be different for different data streams.
	// Multiple filters are at nFilter.
	complex double cx;
	int j, k;
	static int init = 0;
	static struct stStorage {
		int indexFilter;						// current index into sample buffer
		complex double bufFilterC[MAX_FILTER_SIZE];	// Digital filter sample buffer
	} Storage[MAX_RX_CHANNELS];
	struct stStorage * ptBuf = Storage + bank;
	double * filtI;

	if ( ! init) {
		init = 1;
		for (j = 0; j < MAX_RX_CHANNELS; j++)
			memset(Storage + j, 0, sizeof(struct stStorage));
	}

	if ( ! sizeFilter)
		return sample;
	if (ptBuf->indexFilter >= sizeFilter)
		ptBuf->indexFilter = 0;
	ptBuf->bufFilterC[ptBuf->indexFilter] = sample;
	cx = 0;
	filtI = cFilterI[nFilter];
	j = ptBuf->indexFilter;
	for (k = 0; k < sizeFilter; k++) {
		cx += ptBuf->bufFilterC[j] * filtI[k];
		if (++j >= sizeFilter)
			j = 0;
	}
	ptBuf->indexFilter++;
	return cx;
}

complex double cRxFilterOut(complex double sample, int bank, int nFilter)
{	// Rx FIR filter; bank is the static storage index, and must be different for different data streams.
	// Multiple filters are at nFilter.
	double accI, accQ;
	double * filtI, * filtQ;
	int j, k;
	static int init = 0;
	static struct stStorage {
		int indexFilter;						// current index into sample buffer
		double bufFilterI[MAX_FILTER_SIZE];		// Digital filter sample buffer
		double bufFilterQ[MAX_FILTER_SIZE];		// Digital filter sample buffer
	} Storage[MAX_RX_CHANNELS];
	struct stStorage * ptBuf = Storage + bank;

	if ( ! init) {
		init = 1;
		for (j = 0; j < MAX_RX_CHANNELS; j++)
			memset(Storage + j, 0, sizeof(struct stStorage));
	}

	if ( ! sizeFilter)
		return sample;
	if (ptBuf->indexFilter >= sizeFilter)
		ptBuf->indexFilter = 0;
	ptBuf->bufFilterI[ptBuf->indexFilter] = creal(sample);
	ptBuf->bufFilterQ[ptBuf->indexFilter] = cimag(sample);
	filtI = cFilterI[nFilter];
	filtQ = cFilterQ[nFilter];
	accI = accQ = 0;
	j = ptBuf->indexFilter;
	for (k = 0; k < sizeFilter; k++) {
		accI += ptBuf->bufFilterI[j] * filtI[k];
		accQ += ptBuf->bufFilterQ[j] * filtQ[k];
		if (++j >= sizeFilter)
			j = 0;
	}
	ptBuf->indexFilter++;
	return accI + I * accQ;
}

static void AddTestTone(complex double * cSamples, int nSamples)
{
	int i;
	static complex double testtoneVector = 21474836.47;	// -40 dB
	static complex double audioVector = 1.0;
	complex double audioPhase;

	switch (rxMode) {
	default:
		//testtonePhase = cexp(I * 2 * M_PI * (quisk_sidetoneCtrl - 500) / 1000.0);
		for (i = 0; i < nSamples; i++) {
			cSamples[i] += testtoneVector;
			testtoneVector *= testtonePhase;
		}
		break;
	case 4:		// AM
		//audioPhase = cexp(I * 2 * M_PI * quisk_sidetoneCtrl * 5 / sample_rate);
		audioPhase = cexp(I * 2.0 * M_PI * 1000 / quisk_sound_state.sample_rate);
		for (i = 0; i < nSamples; i++) {
			cSamples[i] += testtoneVector * (1.0 + creal(audioVector));
			testtoneVector *= testtonePhase;
			audioVector *= audioPhase;
		}
		break;
	case 5:		 // FM
	case 13:
		//audioPhase = cexp(I * 2 * M_PI * quisk_sidetoneCtrl * 5 / sample_rate);
		audioPhase = cexp(I * 2.0 * M_PI * 1000 / quisk_sound_state.sample_rate);
		for (i = 0; i < nSamples; i++) {
			cSamples[i] += testtoneVector * cexp(I * creal(audioVector));
			testtoneVector *= testtonePhase;
			audioVector *= audioPhase;
		}
		break;
	}
}

static int IsSquelch(int freq)
{  // measure the signal level for squelch
	int i, i1, i2, iBandwidth;
	double meter;

	// This uses current_graph with width data_width
	iBandwidth = 5000 * data_width / fft_sample_rate;	// bandwidth determines number of pixels to average
	if (iBandwidth < 1)
		iBandwidth = 1;
	i1 = (int)((double)freq * data_width / fft_sample_rate + data_width / 2.0 - iBandwidth / 2.0 + 0.5);
	i2 = i1 + iBandwidth;
	meter = 0;
	if (i1 >= 0 && i2 < data_width) {	// too close to edge?
		for (i = i1; i < i2; i++)
			meter += current_graph[i];
	}
	meter /= iBandwidth;
	if (meter == 0 || meter < squelch_level)
		return 1;   // meter == 0 means Rx freq is off-screen so squelch is on
	else
		return 0;
}

static PyObject * set_record_state(PyObject * self, PyObject * args)
{  // called when a Record or Play button is pressed, or with -1 to poll
	int button;

	if (!PyArg_ParseTuple (args, "i", &button))
		return NULL;
	switch (button) {
	case 0:			// press record radio
	case 4:			// press record microphone
		if ( ! quisk_record_buffer) {	// initialize
			quisk_record_bufsize = (int)(QuiskGetConfigDouble("max_record_minutes", 0.25) * quisk_sound_state.playback_rate * 60.0 + 0.2);
			quisk_record_buffer = (float *)malloc(sizeof(float) * quisk_record_bufsize);
		}
		quisk_record_index = 0;
		quisk_play_index = 0;
		quisk_mic_index = 0;
		quisk_record_full = 0;
		if (button == 0)
			quisk_record_state = RECORD_RADIO;
		else
			quisk_record_state = RECORD_MIC;
		break;
	case 1:			// release record
		quisk_record_state = IDLE;
		break;
	case 2:			// press play
		if (quisk_record_full) {
			quisk_play_index = quisk_record_index + 1;
			if (quisk_play_index >= quisk_record_bufsize)
				quisk_play_index = 0;
		}
		else {
			quisk_play_index = 0;
		}
		quisk_mic_index = quisk_play_index;
		quisk_record_state = PLAYBACK;
		break;
	case 3:			// release play
		quisk_record_state = IDLE;
		break;
	case 5:			// press play file
		wavPosSound = wavPosMic = wavStart;
		quisk_record_state = PLAY_FILE;
		break;
	}
	return PyInt_FromLong(quisk_record_state != PLAYBACK && quisk_record_state != PLAY_FILE);
}

void quisk_tmp_record(complex double * cSamples, int nSamples, double scale)		// save sound
{
	int i;

	for (i = 0; i < nSamples; i++) {
		quisk_record_buffer[quisk_record_index++] = creal(cSamples[i]) * scale;
		if (quisk_record_index >= quisk_record_bufsize) {
			quisk_record_index = 0;
			quisk_record_full = 1;
		}
	}
}

void quisk_tmp_playback(complex double * cSamples, int nSamples, double volume)
{  // replace radio sound with saved sound
	int i;
	double d;

	for (i = 0; i < nSamples; i++) {
		d = quisk_record_buffer[quisk_play_index++] * volume;
		cSamples[i] = d + I * d;
		if (quisk_play_index >= quisk_record_bufsize)
			quisk_play_index = 0;
		if (quisk_play_index == quisk_record_index) {
			quisk_record_state = IDLE;
			return;
		}
	}
}

void quisk_tmp_microphone(complex double * cSamples, int nSamples)
{  // replace microphone samples with saved sound
	int i;
	double d;

	for (i = 0; i < nSamples; i++) {
		d = quisk_record_buffer[quisk_mic_index++];
		cSamples[i] = d + I * d;
		if (quisk_mic_index >= quisk_record_bufsize)
			quisk_mic_index = 0;
		if (quisk_mic_index == quisk_record_index) {
			quisk_record_state = IDLE;
			return;
		}
	}
}

static PyObject * open_file_play(PyObject * self, PyObject * args)
{
// The WAV file must be recorded at 48000 Hertz in S16_LE format.
	const char * fname;
	char name[5];
	int size;

	if (!PyArg_ParseTuple (args, "s", &fname))
		return NULL;
	if (wavFp)
      fclose(wavFp);
	wavFp = fopen(fname, "rb");
	if (!wavFp) {
		printf("open_wav failed\n");
		return PyInt_FromLong(1);
	}
	wavEnd = 0;
	while (1) {
		if (fread (name, 4, 1, wavFp) != 1)
			break;
		if (fread (&size, 4, 1, wavFp) != 1)
			break;
		name[4] = 0;
		//printf("name %s size %d ret %d\n", name, size, ret);
		if (!strncmp(name, "RIFF", 4))
			fseek (wavFp, 4, SEEK_CUR);	// Skip "WAVE"
		else if (!strncmp(name, "data", 4)) {	// sound data starts here
			wavStart = ftell(wavFp);
			wavEnd = wavStart + size;
			break;
		}
		else	// Skip other records
			fseek (wavFp, size, SEEK_CUR);
	}
	//printf("start %d  end %d\n", wavStart, wavEnd);
	if (!wavEnd) {		// Failure to find "data" record
		fclose(wavFp);
		wavFp = NULL;
		return PyInt_FromLong(2);
	}
	return PyInt_FromLong(0);
}

void quisk_file_playback(complex double * cSamples, int nSamples, double volume)
{
	// Replace radio sound by file samples.
	// The sample rate must equal quisk_sound_state.mic_sample_rate.
	int i;
	short sh;
	double d;

	if (wavFp && wavPosSound < wavEnd) {
		fseek (wavFp, wavPosSound, SEEK_SET);
		for (i = 0; i < nSamples; i++) {
			if (fread(&sh, 2, 1, wavFp) != 1)
				break;
			d = sh * ((double)CLIP32 / CLIP16) * volume;
			cSamples[i] = d + I * d;
			wavPosSound += 2;
			if (wavPosSound >= wavEnd) {
				quisk_record_state = IDLE;
				break;
			}
		}
	}
}

#define BUF2CHAN_SIZE	12000
static int Buffer2Chan(double * samp1, int count1, double * samp2, int count2)
{	// return the minimum of count1 and count2, buffering as necessary
	int nout;
	static int nbuf1=0, nbuf2=0;
	static double buf1[BUF2CHAN_SIZE], buf2[BUF2CHAN_SIZE];

	if (samp1 == NULL) {	// initialize
		nbuf1 = nbuf2 = 0;
		return 0;
	}
	if (nbuf1 == 0 && nbuf2 == 0 && count1 == count2)	// nothing to do
		return count1;
	if (count1 + nbuf1 >= BUF2CHAN_SIZE || count2 + nbuf2 >= BUF2CHAN_SIZE) {	// overflow
		if (DEBUG || DEBUG_IO)
			printf("Overflow in Buffer2Chan nbuf1 %d nbuf2 %d size %d\n", nbuf1, nbuf2, BUF2CHAN_SIZE);
		nbuf1 = nbuf2 = 0;
	}
	memcpy(buf1 + nbuf1, samp1, count1 * sizeof(double));	// add samples to buffer
	nbuf1 += count1;
	memcpy(buf2 + nbuf2, samp2, count2 * sizeof(double));
	nbuf2 += count2;
	if (nbuf1 <= nbuf2)
		nout = nbuf1;		// number of samples to output
	else
		nout = nbuf2;
	//if (count1 + nbuf1 >= 2000 || count2 + nbuf2 >= 2000)
	//	printf("Buffer2Chan nbuf1 %d nbuf2 %d nout %d\n", nbuf1, nbuf2, nout);
	memcpy(samp1, buf1, nout * sizeof(double));			// output samples
	nbuf1 -= nout;
	memmove(buf1, buf1 + nout, nbuf1 * sizeof(double));
	memcpy(samp2, buf2, nout * sizeof(double));
	nbuf2 -= nout;
	memmove(buf2, buf2 + nout, nbuf2 * sizeof(double));
	return nout;
}

void quisk_file_microphone(complex double * cSamples, int nSamples)
{
	// Replace mic samples by file samples.
	// The sample rate must equal quisk_sound_state.mic_sample_rate.
	int i;
	short sh;
	double d;

	if (wavFp && wavPosMic < wavEnd) {
		fseek (wavFp, wavPosMic, SEEK_SET);
		for (i = 0; i < nSamples; i++) {
			if (fread(&sh, 2, 1, wavFp) != 1)
				break;
			d = sh * ((double)CLIP32 / CLIP16);
			cSamples[i] = d + I * d;
			wavPosMic += 2;
			if (wavPosMic >= wavEnd) {
				quisk_record_state = IDLE;
				break;
			}
		}
	}
}

static int quisk_process_decimate(complex double * cSamples, int nSamples, int bank, int rx_mode)
{	// Changes here will require changes to get_filter_rate();
	int i, final_filter;
	static struct stStorage {
		struct quisk_cHB45Filter HalfBand1;
		struct quisk_cHB45Filter HalfBand2;
		struct quisk_cHB45Filter HalfBand3;
		struct quisk_cHB45Filter HalfBand4;
		struct quisk_cHB45Filter HalfBand5;
		struct quisk_cFilter filtSdriq111;
		struct quisk_cFilter filtSdriq53;
		struct quisk_cFilter filtSdriq133;
		struct quisk_cFilter filtSdriq167;
		struct quisk_cFilter filtSdriq185;
		struct quisk_cFilter filtDecim3;
		struct quisk_cFilter filtDecim5;
		struct quisk_cFilter filtDecim5S;
		struct quisk_cFilter filtDecim48to24;
		struct quisk_cFilter filtI3D25;
	} Storage[MAX_RX_CHANNELS] ;

	if ( ! cSamples) {	// Initialize all filters
		for (i = 0; i < MAX_RX_CHANNELS; i++) {
			memset(&Storage[i].HalfBand1, 0, sizeof(struct quisk_cHB45Filter));
			memset(&Storage[i].HalfBand2, 0, sizeof(struct quisk_cHB45Filter));
			memset(&Storage[i].HalfBand3, 0, sizeof(struct quisk_cHB45Filter));
			memset(&Storage[i].HalfBand4, 0, sizeof(struct quisk_cHB45Filter));
			memset(&Storage[i].HalfBand5, 0, sizeof(struct quisk_cHB45Filter));
			quisk_filt_cInit(&Storage[i].filtSdriq111, quiskFilt111D2Coefs, sizeof(quiskFilt111D2Coefs)/sizeof(double));
			quisk_filt_cInit(&Storage[i].filtSdriq53, quiskFilt53D1Coefs, sizeof(quiskFilt53D1Coefs)/sizeof(double));
			quisk_filt_cInit(&Storage[i].filtSdriq133, quiskFilt133D2Coefs, sizeof(quiskFilt133D2Coefs)/sizeof(double));
			quisk_filt_cInit(&Storage[i].filtSdriq167, quiskFilt167D3Coefs, sizeof(quiskFilt167D3Coefs)/sizeof(double));
			quisk_filt_cInit(&Storage[i].filtSdriq185, quiskFilt185D3Coefs, sizeof(quiskFilt185D3Coefs)/sizeof(double));
			quisk_filt_cInit(&Storage[i].filtDecim3, quiskFilt144D3Coefs, sizeof(quiskFilt144D3Coefs)/sizeof(double));
			quisk_filt_cInit(&Storage[i].filtDecim5, quiskFilt240D5Coefs, sizeof(quiskFilt240D5Coefs)/sizeof(double));
			quisk_filt_cInit(&Storage[i].filtDecim5S, quiskFilt240D5CoefsSharp, sizeof(quiskFilt240D5CoefsSharp)/sizeof(double));
			quisk_filt_cInit(&Storage[i].filtDecim48to24, quiskFilt48dec24Coefs, sizeof(quiskFilt48dec24Coefs)/sizeof(double));
			quisk_filt_cInit(&Storage[i].filtI3D25, quiskFiltI3D25Coefs, sizeof(quiskFiltI3D25Coefs)/sizeof(double));
		}
		return 0;
	}
	// Decimate: Lower the sample rate to 48000 sps (or approx).  Filters are designed for
	// a pass bandwidth of 20 kHz and a stop bandwidth of 24 kHz.
	// We use 48 ksps to accommodate wide digital modes.
	final_filter = (rx_mode == 7 || rx_mode == 8 || rx_mode == 9);	// Use sharp FIR final filter for decimate
	quisk_decim_srate = 48000;
	switch((quisk_sound_state.sample_rate + 100) / 1000) {
	case 41:
	case 48:
		break;
	case 53:	// SDR-IQ
		quisk_decim_srate = quisk_sound_state.sample_rate;
		nSamples = quisk_cDecimate(cSamples, nSamples, &Storage[bank].filtSdriq53, 1);
		break;
	case 96:
		if (final_filter)
			nSamples = quisk_cDecimate(cSamples, nSamples, &Storage[bank].filtDecim48to24, 2);
		else
			nSamples = quisk_cDecim2HB45(cSamples, nSamples, &Storage[bank].HalfBand1);
		break;
	case 111:	// SDR-IQ
		quisk_decim_srate = quisk_sound_state.sample_rate / 2;
		nSamples = quisk_cDecimate(cSamples, nSamples, &Storage[bank].filtSdriq111, 2);
		break;
	case 133:	// SDR-IQ
		quisk_decim_srate = quisk_sound_state.sample_rate / 2;
		nSamples = quisk_cDecimate(cSamples, nSamples, &Storage[bank].filtSdriq133, 2);
		break;
	case 185:	// SDR-IQ
		quisk_decim_srate = quisk_sound_state.sample_rate / 3;
		nSamples = quisk_cDecimate(cSamples, nSamples, &Storage[bank].filtSdriq185, 3);
		break;
	case 192:
		nSamples = quisk_cDecim2HB45(cSamples, nSamples, &Storage[bank].HalfBand2);
		if (final_filter)
			nSamples = quisk_cDecimate(cSamples, nSamples, &Storage[bank].filtDecim48to24, 2);
		else
			nSamples = quisk_cDecim2HB45(cSamples, nSamples, &Storage[bank].HalfBand1);
		break;
	case 240:
		if (final_filter)
			nSamples = quisk_cDecimate(cSamples, nSamples, &Storage[bank].filtDecim5S, 5);
		else
			nSamples = quisk_cDecimate(cSamples, nSamples, &Storage[bank].filtDecim5, 5);
		break;
    case 288:
		nSamples = quisk_cDecim2HB45(cSamples, nSamples, &Storage[bank].HalfBand2);
		nSamples = quisk_cDecimate(cSamples, nSamples, &Storage[bank].filtDecim3, 3);
		break;
	case 370:
		quisk_decim_srate = quisk_sound_state.sample_rate / 6;
		nSamples = quisk_cDecim2HB45(cSamples, nSamples, &Storage[bank].HalfBand2);
		nSamples = quisk_cDecimate(cSamples, nSamples, &Storage[bank].filtSdriq185, 3);
		break;
	case 384:
		nSamples = quisk_cDecim2HB45(cSamples, nSamples, &Storage[bank].HalfBand2);
		nSamples = quisk_cDecim2HB45(cSamples, nSamples, &Storage[bank].HalfBand3);
		if (final_filter)
			nSamples = quisk_cDecimate(cSamples, nSamples, &Storage[bank].filtDecim48to24, 2);
		else
			nSamples = quisk_cDecim2HB45(cSamples, nSamples, &Storage[bank].HalfBand1);
		break;
	case 400:
		nSamples = quisk_cInterpDecim(cSamples, nSamples, &Storage[bank].filtI3D25, 3, 25);
		break;
	case 480:
		nSamples = quisk_cDecimate(cSamples, nSamples, &Storage[bank].filtDecim5, 5);
		if (final_filter)
			nSamples = quisk_cDecimate(cSamples, nSamples, &Storage[bank].filtDecim48to24, 2);
		else
			nSamples = quisk_cDecim2HB45(cSamples, nSamples, &Storage[bank].HalfBand1);
		break;
	case 740:
		quisk_decim_srate = quisk_sound_state.sample_rate / 12;
		nSamples = quisk_cDecim2HB45(cSamples, nSamples, &Storage[bank].HalfBand2);
		nSamples = quisk_cDecim2HB45(cSamples, nSamples, &Storage[bank].HalfBand3);
		nSamples = quisk_cDecimate(cSamples, nSamples, &Storage[bank].filtSdriq185, 3);
		break;
    case 768:
		nSamples = quisk_cDecim2HB45(cSamples, nSamples, &Storage[bank].HalfBand2);
		nSamples = quisk_cDecim2HB45(cSamples, nSamples, &Storage[bank].HalfBand3);
		nSamples = quisk_cDecim2HB45(cSamples, nSamples, &Storage[bank].HalfBand4);
		if (final_filter)
			nSamples = quisk_cDecimate(cSamples, nSamples, &Storage[bank].filtDecim48to24, 2);
		else
			nSamples = quisk_cDecim2HB45(cSamples, nSamples, &Storage[bank].HalfBand1);
		break;
	case 960:
		nSamples = quisk_cDecim2HB45(cSamples, nSamples, &Storage[bank].HalfBand2);
		nSamples = quisk_cDecimate(cSamples, nSamples, &Storage[bank].filtDecim5, 5);
		if (final_filter)
			nSamples = quisk_cDecimate(cSamples, nSamples, &Storage[bank].filtDecim48to24, 2);
		else
			nSamples = quisk_cDecim2HB45(cSamples, nSamples, &Storage[bank].HalfBand1);
		break;
    case 1152:
		nSamples = quisk_cDecim2HB45(cSamples, nSamples, &Storage[bank].HalfBand1);
		nSamples = quisk_cDecim2HB45(cSamples, nSamples, &Storage[bank].HalfBand2);
		nSamples = quisk_cDecim2HB45(cSamples, nSamples, &Storage[bank].HalfBand3);
		nSamples = quisk_cDecimate(cSamples, nSamples, &Storage[bank].filtDecim3, 3);
		break;
	case 1333:
		quisk_decim_srate = quisk_sound_state.sample_rate / 24;
		nSamples = quisk_cDecim2HB45(cSamples, nSamples, &Storage[bank].HalfBand1);
		nSamples = quisk_cDecim2HB45(cSamples, nSamples, &Storage[bank].HalfBand2);
		nSamples = quisk_cDecim2HB45(cSamples, nSamples, &Storage[bank].HalfBand3);
		nSamples = quisk_cDecimate(cSamples, nSamples, &Storage[bank].filtSdriq167, 3);
		break;
	case 1536:
		nSamples = quisk_cDecim2HB45(cSamples, nSamples, &Storage[bank].HalfBand2);
		nSamples = quisk_cDecim2HB45(cSamples, nSamples, &Storage[bank].HalfBand3);
		nSamples = quisk_cDecim2HB45(cSamples, nSamples, &Storage[bank].HalfBand4);
		nSamples = quisk_cDecim2HB45(cSamples, nSamples, &Storage[bank].HalfBand5);
		if (final_filter)
			nSamples = quisk_cDecimate(cSamples, nSamples, &Storage[bank].filtDecim48to24, 2);
		else
			nSamples = quisk_cDecim2HB45(cSamples, nSamples, &Storage[bank].HalfBand1);
		break;
	case 1920:
		nSamples = quisk_cDecim2HB45(cSamples, nSamples, &Storage[bank].HalfBand1);
		nSamples = quisk_cDecim2HB45(cSamples, nSamples, &Storage[bank].HalfBand2);
		nSamples = quisk_cDecim2HB45(cSamples, nSamples, &Storage[bank].HalfBand3);
		nSamples = quisk_cDecimate(cSamples, nSamples, &Storage[bank].filtDecim5, 5);
		break;
    case 2304:
		nSamples = quisk_cDecim2HB45(cSamples, nSamples, &Storage[bank].HalfBand1);
		nSamples = quisk_cDecim2HB45(cSamples, nSamples, &Storage[bank].HalfBand2);
		nSamples = quisk_cDecim2HB45(cSamples, nSamples, &Storage[bank].HalfBand3);
		nSamples = quisk_cDecim2HB45(cSamples, nSamples, &Storage[bank].HalfBand4);
		nSamples = quisk_cDecimate(cSamples, nSamples, &Storage[bank].filtDecim3, 3);
		break;
	default:
		printf ("Failure in quisk.c in integer decimation for rate %d\n", quisk_sound_state.sample_rate);
		break;
	}
	return nSamples;
}

static int quisk_process_demodulate(complex double * cSamples, double * dsamples, int nSamples, int bank, int nFilter, int rx_mode)
{	// Changes here will require changes to get_filter_rate();
	int i;
	complex double cx, cpx;
	double d, di, dd;
	static struct AgcState Agc1 = {0.3, 16000, 0}, Agc2 = {0.3, 16000, 0};
	static struct stStorage {
		complex double fm_1;			// Sample delayed by one
		double dc_remove;		// DC removal for AM
		double FM_www;
		double FM_nnn, FM_a_0, FM_a_1, FM_b_1, FM_x_1, FM_y_1;   // filter for FM
		struct quisk_cHB45Filter HalfBand4;
		struct quisk_cHB45Filter HalfBand5;
		struct quisk_dHB45Filter HalfBand6;
		struct quisk_dHB45Filter HalfBand7;
		struct quisk_dFilter filtAudio24p3;
		struct quisk_dFilter filtAudio24p4;
		struct quisk_dFilter filtAudio12p2;
		struct quisk_dFilter filtAudio24p6;
		struct quisk_dFilter filtAudioFmHp;
		struct quisk_cFilter filtDecim16to8;
		struct quisk_cFilter filtDecim48to24;
		struct quisk_cFilter filtDecim48to16;
	} Storage[MAX_RX_CHANNELS] ;

	if ( ! cSamples) {	// Initialize all filters
		for (i = 0; i < MAX_RX_CHANNELS; i++) {
			memset(&Storage[i].HalfBand4, 0, sizeof(struct quisk_cHB45Filter));
			memset(&Storage[i].HalfBand5, 0, sizeof(struct quisk_cHB45Filter));
			memset(&Storage[i].HalfBand6, 0, sizeof(struct quisk_dHB45Filter));
			memset(&Storage[i].HalfBand7, 0, sizeof(struct quisk_dHB45Filter));
			quisk_filt_dInit(&Storage[i].filtAudio24p3, quiskAudio24p3Coefs, sizeof(quiskAudio24p3Coefs)/sizeof(double));
			quisk_filt_dInit(&Storage[i].filtAudio24p4, quiskAudio24p4Coefs, sizeof(quiskAudio24p4Coefs)/sizeof(double));
			quisk_filt_dInit(&Storage[i].filtAudio12p2, quiskAudio24p4Coefs, sizeof(quiskAudio24p4Coefs)/sizeof(double));
			quisk_filt_dInit(&Storage[i].filtAudio24p6, quiskAudio24p6Coefs, sizeof(quiskAudio24p6Coefs)/sizeof(double));
			quisk_filt_dInit(&Storage[i].filtAudioFmHp, quiskAudioFmHpCoefs, sizeof(quiskAudioFmHpCoefs)/sizeof(double));
			quisk_filt_cInit(&Storage[i].filtDecim16to8, quiskFilt16dec8Coefs, sizeof(quiskFilt16dec8Coefs)/sizeof(double));
			quisk_filt_cInit(&Storage[i].filtDecim48to24, quiskFilt48dec24Coefs, sizeof(quiskFilt48dec24Coefs)/sizeof(double));
			quisk_filt_cInit(&Storage[i].filtDecim48to16, quiskAudio24p3Coefs, sizeof(quiskAudio24p3Coefs)/sizeof(double));
			Storage[i].fm_1 = 10;
			Storage[i].FM_www = tan(M_PI * FM_FILTER_DEMPH / 24000);   // filter for FM
			Storage[i].FM_nnn = 1.0 / (1.0 + Storage[i].FM_www);
			Storage[i].FM_a_0 = Storage[i].FM_www * Storage[i].FM_nnn;
			Storage[i].FM_a_1 = Storage[i].FM_a_0;
			Storage[i].FM_b_1 = Storage[i].FM_nnn * (Storage[i].FM_www - 1.0);
			//printf ("dsamples[i] = y_1 = di * %12.6lf + x_1 * %12.6lf - y_1 * %12.6lf\n", FM_a_0, FM_a_1, FM_b_1);
		}
		return 0;
	}

	// Filter and demodulate signal, copy capture buffer cSamples to play buffer dsamples.
	// quisk_decim_srate is the sample rate after integer decimation.
	switch(rx_mode) {
	case 0:		// lower sideband CW at 6 ksps
		quisk_filter_srate = quisk_decim_srate / 8;
		nSamples = quisk_cDecim2HB45(cSamples, nSamples, &Storage[bank].HalfBand5);
		nSamples = quisk_cDecim2HB45(cSamples, nSamples, &Storage[bank].HalfBand4);
		nSamples = quisk_cDecimate(cSamples, nSamples, &Storage[bank].filtDecim48to24, 2);
		for (i = 0; i < nSamples; i++) {
			cx = cRxFilterOut(cSamples[i], bank, nFilter);
			dsamples[i] = dd = creal(cx) + cimag(cx);
			if(bank == 0) {
				measure_audio_sum += dd * dd;
				measure_audio_count += 1;
			}
		}
		if(bank == 0)
			dAutoNotch(dsamples, nSamples, rit_freq, quisk_filter_srate);
		nSamples = quisk_dInterpolate(dsamples, nSamples, &Storage[bank].filtAudio12p2, 2);
		nSamples = quisk_dInterp2HB45(dsamples, nSamples, &Storage[bank].HalfBand6);
		nSamples = quisk_dInterp2HB45(dsamples, nSamples, &Storage[bank].HalfBand7);
		break;
	case 1:		// upper sideband CW at 6 ksps
		quisk_filter_srate = quisk_decim_srate / 8;
		nSamples = quisk_cDecim2HB45(cSamples, nSamples, &Storage[bank].HalfBand5);
		nSamples = quisk_cDecim2HB45(cSamples, nSamples, &Storage[bank].HalfBand4);
		nSamples = quisk_cDecimate(cSamples, nSamples, &Storage[bank].filtDecim48to24, 2);
		for (i = 0; i < nSamples; i++) {
			cx = cRxFilterOut(cSamples[i], bank, nFilter);
			dsamples[i] = dd = creal(cx) - cimag(cx);
			if(bank == 0) {
				measure_audio_sum += dd * dd;
				measure_audio_count += 1;
			}
		}
		if(bank == 0)
			dAutoNotch(dsamples, nSamples, rit_freq, quisk_filter_srate);
		nSamples = quisk_dInterpolate(dsamples, nSamples, &Storage[bank].filtAudio12p2, 2);
		nSamples = quisk_dInterp2HB45(dsamples, nSamples, &Storage[bank].HalfBand6);
		nSamples = quisk_dInterp2HB45(dsamples, nSamples, &Storage[bank].HalfBand7);
		break;
	case 2:	 // lower sideband SSB at 12 ksps
		quisk_filter_srate = quisk_decim_srate / 4;
		nSamples = quisk_cDecim2HB45(cSamples, nSamples, &Storage[bank].HalfBand5);
		nSamples = quisk_cDecimate(cSamples, nSamples, &Storage[bank].filtDecim48to24, 2);
		for (i = 0; i < nSamples; i++) {
			cx = cRxFilterOut(cSamples[i], bank, nFilter);
			dsamples[i] = dd = creal(cx) + cimag(cx);
			if(bank == 0) {
				measure_audio_sum += dd * dd;
				measure_audio_count += 1;
			}
		}
		if(bank == 0)
			dAutoNotch(dsamples, nSamples, 0, quisk_filter_srate);
		//calc_audio_graph(dsamples, nSamples);
		nSamples = quisk_dInterpolate(dsamples, nSamples, &Storage[bank].filtAudio24p4, 2);
		nSamples = quisk_dInterp2HB45(dsamples, nSamples, &Storage[bank].HalfBand7);
		break;
	case 3:	 // upper sideband SSB at 12 ksps
	default:
		quisk_filter_srate = quisk_decim_srate / 4;
		nSamples = quisk_cDecim2HB45(cSamples, nSamples, &Storage[bank].HalfBand5);
		nSamples = quisk_cDecimate(cSamples, nSamples, &Storage[bank].filtDecim48to24, 2);
		for (i = 0; i < nSamples; i++) {
			cx = cRxFilterOut(cSamples[i], bank, nFilter);
			dsamples[i] = dd = creal(cx) - cimag(cx);
			if(bank == 0) {
				measure_audio_sum += dd * dd;
				measure_audio_count += 1;
			}
		}
		if(bank == 0)
			dAutoNotch(dsamples, nSamples, 0, quisk_filter_srate);
		//calc_audio_graph(dsamples, nSamples);
		nSamples = quisk_dInterpolate(dsamples, nSamples, &Storage[bank].filtAudio24p4, 2);
		nSamples = quisk_dInterp2HB45(dsamples, nSamples, &Storage[bank].HalfBand7);
		break;
	case 4:		// AM at 24 ksps
		quisk_filter_srate = quisk_decim_srate / 2;
		nSamples = quisk_cDecimate(cSamples, nSamples, &Storage[bank].filtDecim48to24, 2);
		for (i = 0; i < nSamples; i++) {
			cx = dRxFilterOut(cSamples[i], bank, nFilter);
			di = cabs(cx);
			d = di + Storage[bank].dc_remove * 0.99;	// DC removal; R.G. Lyons page 553
			di = d - Storage[bank].dc_remove;
			Storage[bank].dc_remove = d;
			dsamples[i] = di;
			if(bank == 0) {
				measure_audio_sum += di * di;
				measure_audio_count += 1;
			}
		}
		nSamples = quisk_dFilter(dsamples, nSamples, &Storage[bank].filtAudio24p6);
		if(bank == 0)
			dAutoNotch(dsamples, nSamples, 0, quisk_filter_srate);
		nSamples = quisk_dInterp2HB45(dsamples, nSamples, &Storage[bank].HalfBand7);
		break;
	case 5:		// FM at 24 ksps
	case 13:
		quisk_filter_srate = quisk_decim_srate / 2;
		nSamples = quisk_cDecimate(cSamples, nSamples, &Storage[bank].filtDecim48to24, 2);
		for (i = 0; i < nSamples; i++) {
			cx = dRxFilterOut(cSamples[i], bank, nFilter);
			cpx = cx * conj(Storage[bank].fm_1);
			Storage[bank].fm_1 = cx;
			di = quisk_filter_srate * carg(cpx);
			// FM de-emphasis
			dsamples[i] = dd = Storage[bank].FM_y_1 = di * Storage[bank].FM_a_0 +
				Storage[bank].FM_x_1 * Storage[bank].FM_a_1 - Storage[bank].FM_y_1 * Storage[bank].FM_b_1;
			Storage[bank].FM_x_1 = di;
			if(bank == 0) {
				measure_audio_sum += dd * dd;
				measure_audio_count += 1;
			}
		}
		nSamples = quisk_dDecimate(dsamples, nSamples, &Storage[bank].filtAudio24p3, 2);
		nSamples = quisk_dFilter(dsamples, nSamples, &Storage[bank].filtAudioFmHp);
		nSamples = quisk_dInterp2HB45(dsamples, nSamples, &Storage[bank].HalfBand6);
		nSamples = quisk_dInterp2HB45(dsamples, nSamples, &Storage[bank].HalfBand7);
		if(bank == 0)
			dAutoNotch(dsamples, nSamples, 0, quisk_filter_srate);
		break;
	case 7:     // digital mode DGT-U at 48 ksps
		quisk_filter_srate = quisk_decim_srate;
		for (i = 0; i < nSamples; i++) {
			cx = cRxFilterOut(cSamples[i], bank, nFilter);
			dsamples[i] = dd = creal(cx) - cimag(cx);
			if(bank == 0) {
				measure_audio_sum += dd * dd;
				measure_audio_count += 1;
			}
		}
		if(bank == 0)
			dAutoNotch(dsamples, nSamples, 0, quisk_filter_srate);
		break;
	case 8:     // digital mode DGT-L at 48 ksps
		quisk_filter_srate = quisk_decim_srate;
		for (i = 0; i < nSamples; i++) {
			cx = cRxFilterOut(cSamples[i], bank, nFilter);
			dsamples[i] = dd = creal(cx) + cimag(cx);
			if(bank == 0) {
				measure_audio_sum += dd * dd;
				measure_audio_count += 1;
			}
		}
		if(bank == 0)
			dAutoNotch(dsamples, nSamples, 0, quisk_filter_srate);
		break;
	case 9:     // digital mode DGT-IQ at 48 ksps
		quisk_filter_srate = quisk_decim_srate;
		if (filter_bandwidth < 19000) {		// No filtering for wide bandwidth
			for (i = 0; i < nSamples; i++)
				cSamples[i] = dRxFilterOut(cSamples[i], bank, nFilter);
		}
		if(bank == 0) {
			for (i = 0; i < nSamples; i++) {
				measure_audio_sum = measure_audio_sum + cSamples[i] * conj(cSamples[i]);
				measure_audio_count += 1;
			}
		}
		break;
	case 11:	 // digital voice at 8 ksps
	case 12:
		quisk_check_freedv_mode();
		nSamples = quisk_cDecimate(cSamples, nSamples, &Storage[bank].filtDecim48to16, 3);
		if (bank == 0)
			process_agc(&Agc1, cSamples, nSamples, 1);
		else
			process_agc(&Agc2, cSamples, nSamples, 1);
		if(bank == 0)
			dAutoNotch(dsamples, nSamples, 0, quisk_decim_srate / 3);
		// Perhaps decimate by an additional fraction
		if (quisk_decim_srate != 48000) {
			dd = quisk_decim_srate / 48000.0;
			nSamples = cFracDecim(cSamples, nSamples, dd);
			quisk_decim_srate = 48000;
		}
		quisk_filter_srate =8000;
		nSamples = quisk_cDecimate(cSamples, nSamples, &Storage[bank].filtDecim16to8, 2);
		if (pt_quisk_freedv_rx)
			nSamples = (* pt_quisk_freedv_rx)(cSamples, dsamples, nSamples, bank);
		if(bank == 0) {
			for (i = 0; i < nSamples; i++) {
				measure_audio_sum += dsamples[i] * dsamples[i];
				measure_audio_count += 1;
			}
		}
		nSamples = quisk_dInterpolate(dsamples, nSamples, &Storage[bank].filtAudio24p3, 3);
		nSamples = quisk_dInterp2HB45(dsamples, nSamples, &Storage[bank].HalfBand7);
		break;
	}
	if (bank == 0 && measure_audio_count >= quisk_filter_srate * measure_audio_time) {
		measured_audio = sqrt(measure_audio_sum / measure_audio_count) / CLIP32 * 1e6;
		measure_audio_sum = measure_audio_count = 0;
	}
	return nSamples;
}

static void process_agc(struct AgcState * dat, complex double * csamples, int count, int is_cpx)
{
	int i;
	double out_magn, buf_magn, dtmp, clip_gain;
	complex double csample;
#if DEBUG
	static int printit=0;
	static double maxout=1;
	char * clip;
#endif

	if ( ! dat->buf_size) {		// initialize
		if (dat->sample_rate == 0)
			dat->sample_rate = quisk_sound_state.playback_rate;
		dat->buf_size = dat->sample_rate * AGC_DELAY / 1000;	// total delay in samples
		//printf("play rate %d  buf_size %d\n", dat->sample_rate, dat->buf_size);
		dat->index_read = 0;				// Index to output; and then write a new sample here
		dat->index_start = 0;				// Start index for measure of maximum sample
		dat->is_clipping = 0;				// Are we decreasing gain to handle a clipping condition?
		dat->themax = 1.0;					// Maximum sample in the buffer
		dat->gain = 100;					// Current output gain
		dat->delta = 0;						// Amount to change dat->gain at each sample
		dat->target_gain = 100;				// Move to this gain unless we clip
		dat->time_release = 1.0 - exp( - 1.0 / dat->sample_rate / agc_release_time);			// long time constant for AGC release
		dat->c_samp = (complex double *) malloc(dat->buf_size * sizeof(complex double));		// buffer for complex samples
		for (i = 0; i < dat->buf_size; i++)
			dat->c_samp[i] = 0;
		return;
	}
	for (i = 0; i < count; i++) {
		csample = csamples[i];
		csamples[i] = dat->c_samp[dat->index_read] * dat->gain;		// FIFO output
		if (is_cpx)
			out_magn = cabs(csamples[i]);
		else
			out_magn = fabs(creal(csamples[i]));
		//if(dat->is_clipping == 1)
			//printf("      index %5d  out_magn %.5lf  gain %.2lf  delta  %.5lf\n",dat->index_read, out_magn / CLIP32, dat->gain, dat->delta);
#if DEBUG
		if (out_magn > maxout)
			maxout = out_magn;
#endif
		if (out_magn > CLIP32)	{
			csamples[i] /= out_magn;
#if DEBUG
			printf("Clip out_magn %8.5lf  is_clipping %d  index_read %5d  index_start %5d  gain %8.5lf\n",
				out_magn / CLIP32, dat->is_clipping, dat->index_read, dat->index_start, dat->gain);
#endif
		}
		dat->c_samp[dat->index_read] = csample;		// write new sample at read index
		if (is_cpx)
			buf_magn = cabs(csample);
		else
			buf_magn = fabs(creal(csample));
		if (dat->is_clipping == 0) {
			if (buf_magn * dat->gain > dat->max_out * CLIP32) {
				dat->target_gain = dat->max_out * CLIP32 / buf_magn;
				dat->delta = (dat->gain - dat->target_gain) / dat->buf_size;
				dat->is_clipping = 1;
				dat->themax = buf_magn;
				// printf("Start index %5d  buf_magn %10.8lf  target %8.2lf  gain %8.2lf  delta  %8.5lf\n",
				// 	dat->index_read, buf_magn / CLIP32, dat->target_gain, dat->gain, dat->delta);
				dat->gain -= dat->delta;
			}
			else if (dat->index_read == dat->index_start) {
				clip_gain = dat->max_out * CLIP32 / dat->themax;		// clip gain based on the maximum sample in the buffer
				if (rxMode == 5 || rxMode == 13)		// mode is FM
					dat->target_gain = clip_gain;
				else if (agcReleaseGain > clip_gain)
					dat->target_gain = clip_gain;
				else
					dat->target_gain = agcReleaseGain;
				dat->themax = buf_magn;
				dat->gain = dat->gain * (1.0 - dat->time_release) + dat->target_gain * dat->time_release;
				// printf("New   index %5d  themax %7.5lf  clip_gain %5.0lf  agcReleaseGain %5.0lf\n",
				// 	dat->index_start, dat->themax / CLIP32, clip_gain, agcReleaseGain);
			}
			else {
				if (dat->themax < buf_magn)
					dat->themax = buf_magn;
				dat->gain = dat->gain * (1.0 - dat->time_release) + dat->target_gain * dat->time_release;
			}
		}
		else {		// dat->is_clipping == 1;  we are handling a clip condition
			if (buf_magn > dat->themax) {
				dat->themax = buf_magn;
				dat->target_gain = dat->max_out * CLIP32 / buf_magn;
				dtmp = (dat->gain - dat->target_gain) / dat->buf_size;	// new value of delta
				if (dtmp > dat->delta) {
					dat->delta = dtmp;
					// printf(" Strt index %5d  buf_magn %10.8lf  target %8.2lf  gain %8.2lf  delta  %8.5lf\n",
					// 	dat->index_read, buf_magn / CLIP32, dat->target_gain, dat->gain, dat->delta);
				}
				else {
					// printf(" Plus index %5d  buf_magn %10.8lf  target %8.2lf  gain %8.2lf  delta  %8.5lf\n",
					// 	dat->index_read, buf_magn / CLIP32, dat->target_gain, dat->gain, dat->delta);
				}
			}
			dat->gain -= dat->delta;
			if (dat->gain <= dat->target_gain) {
				dat->is_clipping = 0;
				dat->gain = dat->target_gain;
				// printf("End   index %5d  buf_magn %10.8lf  target %8.2lf  gain %8.2lf  delta  %8.5lf  themax %10.8lf\n",
				// 	dat->index_read, buf_magn / CLIP32, dat->target_gain, dat->gain, dat->delta, dat->themax / CLIP32);
				dat->themax = buf_magn;
				dat->index_start = dat->index_read;
			}
		}
		if (++dat->index_read >= dat->buf_size)
			dat->index_read = 0;
#if DEBUG
		if (printit++ >= dat->sample_rate * 500 / 1000) {
			printit = 0;
			dtmp = 20 * log10(maxout / CLIP32);
			if (dtmp >= 0)
				clip = "Clip";
			else
				clip = "";
			printf("Out agcGain %5.0lf   target_gain %9.0lf   gain %9.0lf  output %7.2lf %s\n",
				agcReleaseGain, dat->target_gain, dat->gain, dtmp, clip);
			maxout = 1;
		}
#endif
	}
	return;
}

int quisk_process_samples(complex double * cSamples, int nSamples)
{
// Called when samples are available.
// Samples range from about 2^16 to a max of 2^31.
	int i, m, n, nout, is_key_down;
	double d, di, tune;
	double double_filter_decim;
	complex double phase;
	int orig_nSamples;
	fft_data * ptFFT;

	static int size_dsamples = 0;		// Current dimension of dsamples, dsamples2, orig_cSamples, buf_cSamples
	static int old_split_rxtx = 0;		// Prior value of split_rxtx
	static int old_multirx_play_channel = 0;		// Prior value of multirx_play_channel
	static double * dsamples = NULL;
	static double * dsamples2 = NULL;
	static complex double * orig_cSamples = NULL;
	static complex double * buf_cSamples = NULL;
	static complex double rxTuneVector = 1;
	static complex double txTuneVector = 1;
	static complex double aux1TuneVector = 1;
	static complex double aux2TuneVector = 1;
	static complex double sidetoneVector = BIG_VOLUME;
	static double dOutCounter = 0;		// Cumulative net output samples for sidetone etc.
	static int sidetoneIsOn = 0;		// The status of the sidetone
	static double sidetoneEnvelope;		// Shape the rise and fall times of the sidetone
	static double keyupEnvelope = 1.0;	// Shape the rise time on key up
	static int playSilence;
	static int is_squelch = 0;		// Are we squelched?
	static struct quisk_cHB45Filter HalfBand7 = {NULL, 0, 0};
	static struct quisk_cHB45Filter HalfBand8 = {NULL, 0, 0};
	static struct quisk_cHB45Filter HalfBand9 = {NULL, 0, 0};
	static struct AgcState Agc1 = {0.7, 0, 0}, Agc2 = {0.7, 0, 0}, Agc3 = {0.7, 0, 0};

#if DEBUG
	static int printit;
	static time_t time0;
	static double levelA=0, levelB=0, levelC=0, levelD=0, levelE=0;

	if (time(NULL) != time0) {
		time0 = time(NULL);
		printit = 1;
	}
	else {
		printit = 0;
	}
#endif
	if (nSamples <= 0)
		return nSamples;
	if (nSamples > size_dsamples) {
		if (dsamples)
			free(dsamples);
		if (dsamples2)
			free(dsamples2);
		if (orig_cSamples)
			free(orig_cSamples);
		if (buf_cSamples)
			free(buf_cSamples);
		size_dsamples = nSamples * 2;
		dsamples = (double *)malloc(size_dsamples * sizeof(double));
		dsamples2 = (double *)malloc(size_dsamples * sizeof(double));
		orig_cSamples = (complex double *)malloc(size_dsamples * sizeof(complex double));
		buf_cSamples = (complex double *)malloc(size_dsamples * sizeof(complex double));
	}

#if SAMPLES_FROM_FILE == 1
    QuiskWavWriteC(&hWav, cSamples, nSamples);
#elif SAMPLES_FROM_FILE == 2
    QuiskWavReadC(&hWav, cSamples, nSamples);
#endif

	is_key_down = quisk_transmit_mode || quisk_is_key_down();
	orig_nSamples = nSamples;
	if (split_rxtx) {
		memcpy(orig_cSamples, cSamples, nSamples * sizeof(complex double));
		if ( ! old_split_rxtx)		// start of new split mode
			Buffer2Chan(NULL, 0, NULL, 0);
	}
	if (multirx_play_channel != old_multirx_play_channel)	// change in play channel
		Buffer2Chan(NULL, 0, NULL, 0);
	old_split_rxtx = split_rxtx;
	old_multirx_play_channel = multirx_play_channel;

	if (is_key_down && !isFDX) {	// The key is down; replace this data block
		dOutCounter += (double)nSamples * quisk_sound_state.playback_rate /
				quisk_sound_state.sample_rate;
		nout = (int)dOutCounter;			// number of samples to output
		dOutCounter -= nout;
		playSilence = keyupDelay;
		keyupEnvelope = 0;
		if (rxMode == 0 || rxMode == 1) {	// Play sidetone instead of radio for CW
			if (! sidetoneIsOn) {			// turn on sidetone
				sidetoneIsOn = 1;
				sidetoneEnvelope = 0;
				sidetoneVector = BIG_VOLUME;
			}
			for (i = 0 ; i < nout; i++) {
				if (sidetoneEnvelope < 1.0) {
					sidetoneEnvelope += 1. / (quisk_sound_state.playback_rate * 5e-3);	// 5 milliseconds
					if (sidetoneEnvelope > 1.0)
						sidetoneEnvelope = 1.0;
				}
				d = creal(sidetoneVector) * sidetoneVolume * sidetoneEnvelope;
				cSamples[i] = d + I * d;
				sidetoneVector *= sidetonePhase;
			}
		}
		else {			// Otherwise play silence
			for (i = 0 ; i < nout; i++)
				cSamples[i] = 0;
		}
		return nout;
	}
	// Key is up
	if(sidetoneIsOn) {		// decrease sidetone until it is off
		dOutCounter += (double)nSamples * quisk_sound_state.playback_rate /
				quisk_sound_state.sample_rate;
		nout = (int)dOutCounter;			// number of samples to output
		dOutCounter -= nout;
		for (i = 0; i < nout; i++) {
			sidetoneEnvelope -= 1. / (quisk_sound_state.playback_rate * 5e-3);	// 5 milliseconds
			if (sidetoneEnvelope < 0) {
				sidetoneIsOn = 0;
				sidetoneEnvelope = 0;
				break;		// sidetone is zero
			}
			d = creal(sidetoneVector) * sidetoneVolume * sidetoneEnvelope;
			cSamples[i] = d + I * d;
			sidetoneVector *= sidetonePhase;
		}
		for ( ; i < nout; i++) {	// continue with playSilence, even if zero
			cSamples[i] = 0;
			playSilence--;
		}
		return nout;
	}
	if (playSilence > 0) {		// Continue to play silence after the key is up
		dOutCounter += (double)nSamples * quisk_sound_state.playback_rate /
				quisk_sound_state.sample_rate;
		nout = (int)dOutCounter;			// number of samples to output
		dOutCounter -= nout;
		for (i = 0; i < nout; i++)
			cSamples[i] = 0;
		playSilence -= nout;
		return nout;
	}
	// We are done replacing sound with a sidetone or silence.  Filter and
	// demodulate the samples as radio sound.

	// Add a test tone to the data
	if (testtonePhase)
		AddTestTone(cSamples, nSamples);

	// Invert spectrum
	if (quisk_invert_spectrum) {
		for (i = 0; i < nSamples; i++) {
			cSamples[i] = conj(cSamples[i]);
			}
	}

	NoiseBlanker(cSamples, nSamples);

	// Put samples into the fft input array.
	// Thanks to WB4JFI for the code to add a third FFT buffer, July 2010.
	// Changed to multiple FFTs May 2014.
	if (multiple_sample_rates == 0) {
	    ptFFT = fft_data_array + fft_data_index;
	    for (i = 0; i < nSamples; i++) {
		    ptFFT->samples[ptFFT->index] = cSamples[i];
		    if (++(ptFFT->index) >= fft_size) {		// check sample count
			    n = fft_data_index + 1;				// next FFT data location
			    if (n >= FFT_ARRAY_SIZE)
				    n = 0;
			    if (fft_data_array[n].filled == 0) {				// Is the next buffer empty?
				    fft_data_array[n].index = 0;
				    fft_data_array[n].block = 0;
				    fft_data_array[fft_data_index].filled = 1;	// Mark the previous buffer ready.
				    fft_data_index = n;							// Write samples into the new buffer.
				    ptFFT = fft_data_array + fft_data_index;
			    }
			    else {				// no place to write samples
				    ptFFT->index = 0;
				    fft_error++;
			    }
		    }
	    }
	}

	// Tune the data to frequency
	if (multiple_sample_rates == 0)
        tune = rx_tune_freq;
    else
        tune = rx_tune_freq + vfo_screen - vfo_audio;
	if (tune != 0) {
		phase = cexp((I * -2.0 * M_PI * tune) / quisk_sound_state.sample_rate);
		for (i = 0; i < nSamples; i++) {
			cSamples[i] *= rxTuneVector;
			rxTuneVector *= phase;
		}
	}

	if (rxMode == 6) {		// External filter and demodulate
		d = (double)quisk_sound_state.sample_rate / quisk_sound_state.playback_rate;	// total decimation needed
		nSamples = quisk_extern_demod(cSamples, nSamples, d);
		goto start_agc;
	}

	// Perhaps write sample data to the soundcard output without decimation
	if (TEST_AUDIO == 1) {		// Copy I channel capture to playback
		di = 1.e4 * quisk_audioVolume;
		for (i = 0; i < nSamples; i++)
			cSamples[i] = creal(cSamples[i]) * di;
		return nSamples;
	}
	else if (TEST_AUDIO == 2) {	// Copy Q channel capture to playback
		di = 1.e4 * quisk_audioVolume;
		for (i = 0; i < nSamples; i++)
			cSamples[i] = cimag(cSamples[i]) * di;
		return nSamples;
	}
#if DEBUG
	for (i = 0; i < nSamples; i++) {
		d = cabs(cSamples[i]);
		if (levelA < d)
			levelA = d;
	}
#endif

	nSamples = quisk_process_decimate(cSamples, nSamples, 0, rxMode);

#if DEBUG
	for (i = 0; i < nSamples; i++) {
		d = cabs(cSamples[i]);
		if (levelB < d)
			levelB = d;
	}
#endif

	if (measure_freq_mode)
		measure_freq(cSamples, nSamples, quisk_decim_srate);

	nSamples = quisk_process_demodulate(cSamples, dsamples, nSamples, 0, 0, rxMode);

	if (rxMode == 9) {
		;		// This mode is already stereo
	}
	else if (split_rxtx) {		// Demodulate a second channel from the same receiver
		phase = cexp((I * -2.0 * M_PI * (quisk_tx_tune_freq + rit_freq)) / quisk_sound_state.sample_rate);
		// Tune the second channel to frequency
		for (i = 0; i < orig_nSamples; i++) {
			orig_cSamples[i] *= txTuneVector;
			txTuneVector *= phase;
		}
		n = quisk_process_decimate(orig_cSamples, orig_nSamples, 1, rxMode);
		n = quisk_process_demodulate(orig_cSamples, dsamples2, n, 1, 0, rxMode);
		nSamples = Buffer2Chan(dsamples, nSamples, dsamples2, n);		// buffer dsamples and dsamples2 so the count is equal
		switch(split_rxtx) {
		default:
		case 1:		// stereo, higher frequency is real
			if (quisk_tx_tune_freq < rx_tune_freq) {
				for (i = 0; i < nSamples; i++)
					cSamples[i] = dsamples[i] + I * dsamples2[i];
			}
			else {
				for (i = 0; i < nSamples; i++)
					cSamples[i] = dsamples2[i] + I * dsamples[i];
			}
			break;
		case 2:		// stereo, lower frequency is real
			if (quisk_tx_tune_freq >= rx_tune_freq) {
				for (i = 0; i < nSamples; i++)
					cSamples[i] = dsamples[i] + I * dsamples2[i];
			}
			else {
				for (i = 0; i < nSamples; i++)
					cSamples[i] = dsamples2[i] + I * dsamples[i];
			}
			break;
		case 3:		// mono receive channel
			for (i = 0; i < nSamples; i++)
				cSamples[i] = dsamples[i] + I * dsamples[i];
			break;
		case 4:		// mono transmit channel
			for (i = 0; i < nSamples; i++)
				cSamples[i] = dsamples2[i] + I * dsamples2[i];
			break;
		}
	}
	else if (multirx_play_channel >= 0) {		// Demodulate a second channel from a different receiver
		memcpy(buf_cSamples, multirx_cSamples[multirx_play_channel], orig_nSamples * sizeof(complex double));
		phase = cexp((I * -2.0 * M_PI * (multirx_freq[multirx_play_channel])) / quisk_sound_state.sample_rate);
		// Tune the second channel to frequency
		for (i = 0; i < orig_nSamples; i++) {
			buf_cSamples[i] *= aux1TuneVector;
			aux1TuneVector *= phase;
		}
		n = quisk_process_decimate(buf_cSamples, orig_nSamples, 1, multirx_mode[multirx_play_channel]);
		n = quisk_process_demodulate(buf_cSamples, dsamples2, n, 1, 1, multirx_mode[multirx_play_channel]);
		nSamples = Buffer2Chan(dsamples, nSamples, dsamples2, n);		// buffer dsamples and dsamples2 so the count is equal
		switch(multirx_play_method) {
		default:
		case 0:		// play both
			for (i = 0; i < nSamples; i++)
				cSamples[i] = dsamples2[i] + I * dsamples2[i];
			break;
		case 1:		// play left
			for (i = 0; i < nSamples; i++)
				cSamples[i] = dsamples[i] + I * dsamples2[i];
			break;
		case 2:		// play right
			for (i = 0; i < nSamples; i++)
				cSamples[i] = dsamples2[i] + I * dsamples[i];
			break;
		}
	}
	else {		// monophonic sound played on both channels
		for (i = 0; i < nSamples; i++) {
			d = dsamples[i];
			cSamples[i] = d + I * d;
		}
	}

	// play sub-receiver 1 audio on a digital output device
	m = multirx_mode[0];
	if (quisk_multirx_count > 0 &&
	(m == 7 || m == 8 || m == 9 || m == 13)  &&
	quisk_DigitalRx1Output.driver) {
		phase = cexp((I * -2.0 * M_PI * (multirx_freq[0])) / quisk_sound_state.sample_rate);
		// Tune the channel to frequency
		for (i = 0; i < orig_nSamples; i++) {
			multirx_cSamples[0][i] *= aux2TuneVector;
			aux2TuneVector *= phase;
		}
		n = quisk_process_decimate(multirx_cSamples[0], orig_nSamples, 2, m);
		n = quisk_process_demodulate(multirx_cSamples[0], dsamples2, n, 2, 2, m);
		if (m == 9) {		// DGT-IQ
			process_agc(&Agc3, multirx_cSamples[0], n, 1);
		}
		else {
			for (i = 0; i < n; i++)
				multirx_cSamples[0][i] = dsamples2[i] + I * dsamples2[i];
			process_agc(&Agc3, multirx_cSamples[0], n, 0);
		}
		play_sound_interface(&quisk_DigitalRx1Output, n, multirx_cSamples[0], 1, 1.0);
	}

	// Perhaps decimate by an additional fraction
	if (quisk_decim_srate != 48000) {
		double_filter_decim = quisk_decim_srate / 48000.0;
		nSamples = cFracDecim(cSamples, nSamples, double_filter_decim);
		quisk_decim_srate = 48000;
	}

	// Interpolate the samples from 48000 sps to the play rate.
	switch (quisk_sound_state.playback_rate / 48000) {
	case 1:
		break;
	case 2:
		nSamples = quisk_cInterp2HB45(cSamples, nSamples, &HalfBand7);
		break;
	case 4:
		nSamples = quisk_cInterp2HB45(cSamples, nSamples, &HalfBand7);
		nSamples = quisk_cInterp2HB45(cSamples, nSamples, &HalfBand8);
		break;
	case 8:
		nSamples = quisk_cInterp2HB45(cSamples, nSamples, &HalfBand7);
		nSamples = quisk_cInterp2HB45(cSamples, nSamples, &HalfBand8);
		nSamples = quisk_cInterp2HB45(cSamples, nSamples, &HalfBand9);
		break;
	default:
		printf ("Failure in quisk.c in integer interpolation %d %d\n", quisk_decim_srate, quisk_sound_state.playback_rate);
		break;
	}

	// Find the peak signal amplitude
start_agc:
	if (rxMode == 6 || rxMode == 9) {		// Ext and DGT-IQ stereo sound
		process_agc(&Agc1, cSamples, nSamples, 1);
	}
	else if (rxMode == 11 || rxMode == 12) {	// Agc already done
		;
	}
	else if (split_rxtx || multirx_play_channel >= 0) {		// separate AGC for left and right channels
		for (i = 0; i < nSamples; i++) {
			orig_cSamples[i] = cimag(cSamples[i]);
			cSamples[i] = creal(cSamples[i]);
		}
		process_agc(&Agc1, cSamples, nSamples, 0);
		process_agc(&Agc2, orig_cSamples, nSamples, 0);
		for (i = 0; i < nSamples; i++)
			cSamples[i] = creal(cSamples[i]) + I * creal(orig_cSamples[i]);
	}
	else {					// monophonic sound
		process_agc(&Agc1, cSamples, nSamples, 0);
	}
#if DEBUG
	if (printit) {
		d = CLIP32;
		//printf ("Levels: %12.8lf  %12.8lf %12.8lf  %12.8lf  %12.8lf\n",
		//	levelA/d, levelB/d, levelC/d, levelD/d, levelE/d);
		levelA = levelB = levelC = levelD = levelE = 0;
	}
#endif

	if (kill_audio) {
		is_squelch = 1;
	}
	else if (rxMode == 5) {		// mode is FM
		if (IsSquelch(quisk_tx_tune_freq))
			is_squelch = 1;
		else
			is_squelch = 0;
	}
	else {
		is_squelch = 0;
	}
	if (is_squelch) {
		for (i = 0; i < nSamples; i++)
			cSamples[i] = 0;
	}
	if (keyupEnvelope < 1.0) {		// raise volume slowly after the key goes up
		di = 1. / (quisk_sound_state.playback_rate * 5e-3);		// 5 milliseconds
		for (i = 0; i < nSamples; i++) {
			keyupEnvelope += di;
			if (keyupEnvelope > 1.0) {
				keyupEnvelope = 1.0;
				break;
			}
			cSamples[i] *= keyupEnvelope;
		}
	}
	if (quisk_record_state == RECORD_RADIO && ! is_squelch)
		quisk_tmp_record(cSamples, nSamples, 1.0);		// save radio sound
	return nSamples;
}

static PyObject * get_state(PyObject * self, PyObject * args)
{
	int unused = 0;

	if (args && !PyArg_ParseTuple (args, ""))	// args=NULL internal call
		return NULL;
	return  Py_BuildValue("iiiiisisiiiiiiiii",
		quisk_sound_state.rate_min,
		quisk_sound_state.rate_max,
		quisk_sound_state.sample_rate,
		quisk_sound_state.chan_min,
		quisk_sound_state.chan_max,
		&quisk_sound_state.msg1,
		unused,
		&quisk_sound_state.err_msg,
		quisk_sound_state.read_error,
		quisk_sound_state.write_error,
		quisk_sound_state.underrun_error,
		quisk_sound_state.latencyCapt,
		quisk_sound_state.latencyPlay,
		quisk_sound_state.interupts,
		fft_error,
		mic_max_display,
		quisk_sound_state.data_poll_usec
		);
}

static PyObject * get_squelch(PyObject * self, PyObject * args)
{
	int freq;

	if (!PyArg_ParseTuple (args, "i", &freq))
		return NULL;
	return PyInt_FromLong(IsSquelch(freq));
}

static PyObject * get_overrange(PyObject * self, PyObject * args)
{
	if (!PyArg_ParseTuple (args, ""))
		return NULL;
	return PyInt_FromLong(quisk_get_overrange());
}

static PyObject * get_filter_rate(PyObject * self, PyObject * args)
{	// Return the filter sample rate as used by quisk_process_samples.
	// Changes to quisk_process_decimate or quisk_process_demodulate will require changes here.
	// Duplicate logic is used for sub-receivers.
	int rate, decim_srate, filter_srate;
	if (!PyArg_ParseTuple (args, ""))
		return NULL;
	rate = quisk_sound_state.sample_rate;
	switch((rate + 100) / 1000) {
	case 53:	// SDR-IQ
		decim_srate = rate;
		break;
	case 111:	// SDR-IQ
		decim_srate = rate / 2;
		break;
	case 133:	// SDR-IQ
		decim_srate = rate / 2;
		break;
	case 185:	// SDR-IQ
		decim_srate = rate / 3;
		break;
	case 370:
		decim_srate = rate / 6;
		break;
	case 740:
		decim_srate = rate / 12;
		break;
	case 1333:
		decim_srate = rate / 24;
		break;
	default:
		decim_srate = 48000;
		break;
	}
	switch(rxMode) {
	case 0:		// lower sideband CW at 6 ksps
	case 1:		// upper sideband CW at 6 ksps
		filter_srate = decim_srate / 8;
		break;
	case 2:	 // lower sideband SSB at 12 ksps
	case 3:	 // upper sideband SSB at 12 ksps
	default:
		filter_srate = decim_srate / 4;
		break;
	case 4:		// AM at 24 ksps
	case 5:		// FM at 24 ksps
	case 13:	// digital FM at 24 ksps
		filter_srate = decim_srate / 2;
		break;
	case 7:     // digital modes DGT-* at 48 ksps
	case 8:
	case 9:
		filter_srate = decim_srate;
		break;
	case 11:	 // digital voice at 8 ksps
	case 12:
		filter_srate = 8000;
		break;
	}
	//printf("Filter rate %d\n", filter_srate);
	return PyInt_FromLong(filter_srate);
}

static PyObject * get_smeter(PyObject * self, PyObject * args)
{
	if (!PyArg_ParseTuple (args, ""))
		return NULL;
	return PyFloat_FromDouble(Smeter);
}

static PyObject * measure_frequency(PyObject * self, PyObject * args)
{
	int mode;

	if (!PyArg_ParseTuple (args, "i", &mode))
		return NULL;
	if (mode >= 0)	// mode >= 0 set the mode; mode < 0, just return the frequency
		measure_freq_mode = mode;
	return PyFloat_FromDouble(measured_frequency);
}

static PyObject * measure_audio(PyObject * self, PyObject * args)
{
	int time;

	if (!PyArg_ParseTuple (args, "i", &time))
		return NULL;
	if (time > 0)	// set the average time
		measure_audio_time = time;
	return PyFloat_FromDouble(measured_audio);
}

static PyObject * add_tone(PyObject * self, PyObject * args)
{  /* Add a test tone to the captured audio data */
	int freq;

	if (!PyArg_ParseTuple (args, "i", &freq))
		return NULL;
	if (freq && quisk_sound_state.sample_rate)
		testtonePhase = cexp((I * 2.0 * M_PI * freq) / quisk_sound_state.sample_rate);
	else
		testtonePhase = 0;
	Py_INCREF (Py_None);
	return Py_None;
}

static PyObject * open_key(PyObject * self, PyObject * args)
{
	const char * name;

	if (!PyArg_ParseTuple (args, "s", &name))
		return NULL;

	return PyInt_FromLong(quisk_open_key(name));
}

static void close_udp(void)
{
	short msg = 0x7373;		// shutdown

	quisk_using_udp = 0;
	if (rx_udp_socket != INVALID_SOCKET) {
		shutdown(rx_udp_socket, QUISK_SHUT_RD);
		send(rx_udp_socket, (char *)&msg, 2, 0);
		send(rx_udp_socket, (char *)&msg, 2, 0);
		QuiskSleepMicrosec(3000000);
		close(rx_udp_socket);
		rx_udp_socket = INVALID_SOCKET;
	}
	quisk_rx_udp_started = 0;
#ifdef MS_WINDOWS
	if (cleanupWSA) {
		cleanupWSA = 0;
		WSACleanup();
	}
#endif
}

static void close_udp10(void)		// Metis-Hermes protocol
{
	int i;
	unsigned char buf[64];

	quisk_using_udp = 0;
	if (rx_udp_socket != INVALID_SOCKET) {
		shutdown(rx_udp_socket, QUISK_SHUT_RD);
		buf[0] = 0xEF;
		buf[1] = 0xFE;
		buf[2] = 0x04;
		buf[3] = 0x00;
		for (i = 4; i < 64; i++)
			buf[i] = 0;
		send(rx_udp_socket, (char *)buf, 64, 0);
		QuiskSleepMicrosec(5000);
		send(rx_udp_socket, (char *)buf, 64, 0);
		QuiskSleepMicrosec(2000000);
		close(rx_udp_socket);
		rx_udp_socket = INVALID_SOCKET;
	}
	quisk_rx_udp_started = 0;
#ifdef MS_WINDOWS
	if (cleanupWSA) {
		cleanupWSA = 0;
		WSACleanup();
	}
#endif
}

static PyObject * close_rx_udp(PyObject * self, PyObject * args)
{  // Not necessary to call from Python because close_udp() is called from sound.c
	if (!PyArg_ParseTuple (args, ""))
		return NULL;
	//close_udp();
	Py_INCREF (Py_None);
	return Py_None;
}

static int quisk_read_rx_udp(complex double * samp)	// Read samples from UDP
{		// Size of complex sample array is SAMP_BUFFER_SIZE
	ssize_t bytes;
	unsigned char buf[1500];	// Maximum Ethernet is 1500 bytes.
	static unsigned char seq0;	// must be 8 bits
	int i, nSamples, xr, xi, index, want_samples;
	unsigned char * ptxr, * ptxi;
	struct timeval tm_wait;
	fd_set fds;
	static complex double dc_average = 0;		// Average DC component in samples
	static complex double dc_sum = 0;
	static int dc_count = 0;
	static int dc_key_delay = 0;

	// Data from the receiver is little-endian
	if ( ! rx_udp_gain_correct) {
		int dec;
		dec = (int)(rx_udp_clock / quisk_sound_state.sample_rate + 0.5);
		if ((dec / 5) * 5 == dec)		// Decimation by a factor of 5
			rx_udp_gain_correct = 1.31072;
		else						// Decimation by factors of two
			rx_udp_gain_correct = 1.0;
	}
	if ( ! quisk_rx_udp_started) {	// we never received any data
		// send our return address until we receive UDP blocks
		tm_wait.tv_sec = 0;
		tm_wait.tv_usec = 5000;
		FD_ZERO (&fds);
		FD_SET (rx_udp_socket, &fds);
		if (select (rx_udp_socket + 1, &fds, NULL, NULL, &tm_wait) == 1) {	// see if data is available
			bytes = recv(rx_udp_socket, (char *)buf, 1500,  0);	// throw away the first block
			seq0 = buf[0] + 1;	// Next expected sequence number
			quisk_rx_udp_started = 1;
#if DEBUG_IO
			printf("Udp data started\n");
#endif
		}
		else {		// send our return address to the sample source
			buf[0] = buf[1] = 0x72;	// UDP command "register return address"
			send(rx_udp_socket, (char *)buf, 2, 0);
			return 0;
		}
	}
	nSamples = 0;
	want_samples = (int)(quisk_sound_state.data_poll_usec * 1e-6 * quisk_sound_state.sample_rate + 0.5);
	while (nSamples < want_samples) {		// read several UDP blocks
		tm_wait.tv_sec = 0;
		tm_wait.tv_usec = 100000; // Linux seems to have problems with very small time intervals
		FD_ZERO (&fds);
		FD_SET (rx_udp_socket, &fds);
		i = select (rx_udp_socket + 1, &fds, NULL, NULL, &tm_wait);
		if (i == 1)
			;
		else if (i == 0) {
#if DEBUG_IO
			printf("Udp socket timeout\n");
#endif
			return 0;
		}
		else {
#if DEBUG_IO
			printf("Udp select error %d\n", i);
#endif
			return 0;
		}
		bytes = recv(rx_udp_socket, (char *)buf, 1500,  0);	// blocking read
		if (bytes != RX_UDP_SIZE) {		// Known size of sample block
			quisk_sound_state.read_error++;
#if DEBUG_IO
			printf("read_rx_udp: Bad block size\n");
#endif
			continue;
		}
		// buf[0] is the sequence number
		// buf[1] is the status:
		//		bit 0:  key up/down state
		//		bit 1:	set for ADC overrange (clip)
		if (buf[0] != seq0) {
#if DEBUG_IO
			printf("read_rx_udp: Bad sequence want %3d got %3d\n",
					(unsigned int)seq0, (unsigned int)buf[0]);
#endif
			quisk_sound_state.read_error++;
		}
		seq0 = buf[0] + 1;		// Next expected sequence number
		quisk_set_key_down(buf[1] & 0x01);	// bit zero is key state
		if (buf[1] & 0x02)					// bit one is ADC overrange
			quisk_sound_state.overrange++;
		index = 2;
		ptxr = (unsigned char *)&xr;
		ptxi = (unsigned char *)&xi;
		// convert 24-bit samples to 32-bit samples; int must be 32 bits.
		if (is_little_endian) {
			while (index < bytes) {		// This works for 3, 2, 1 byte samples
				xr = xi = 0;
				memcpy (ptxr + (4 - sample_bytes), buf + index, sample_bytes);
				index += sample_bytes;
				memcpy (ptxi + (4 - sample_bytes), buf + index, sample_bytes);
				index += sample_bytes;
				samp[nSamples++] = (xr + xi * I) * rx_udp_gain_correct;
				xr = xi = 0;
				memcpy (ptxr + (4 - sample_bytes), buf + index, sample_bytes);
				index += sample_bytes;
				memcpy (ptxi + (4 - sample_bytes), buf + index, sample_bytes);
				index += sample_bytes;
				samp[nSamples++] = (xr + xi * I) * rx_udp_gain_correct;
			}
		}
		else {		// big-endian
			while (index < bytes) {		// This works for 3-byte samples only
				*(ptxr    ) = buf[index + 2];
				*(ptxr + 1) = buf[index + 1];
				*(ptxr + 2) = buf[index    ];
				*(ptxr + 3) = 0;
				index += 3;
				*(ptxi    ) = buf[index + 2];
				*(ptxi + 1) = buf[index + 1];
				*(ptxi + 2) = buf[index    ];
				*(ptxi + 3) = 0;
				index += 3;
				samp[nSamples++] = (xr + xi * I) * rx_udp_gain_correct;;
				*(ptxr    ) = buf[index + 2];
				*(ptxr + 1) = buf[index + 1];
				*(ptxr + 2) = buf[index    ];
				*(ptxr + 3) = 0;
				index += 3;
				*(ptxi    ) = buf[index + 2];
				*(ptxi + 1) = buf[index + 1];
				*(ptxi + 2) = buf[index    ];
				*(ptxi + 3) = 0;
				index += 3;
				samp[nSamples++] = (xr + xi * I) * rx_udp_gain_correct;;

			}
		}
	}
	if (quisk_is_key_down()) {
		dc_key_delay = 0;
		dc_sum = 0;
		dc_count = 0;
	}
	else if (dc_key_delay < quisk_sound_state.sample_rate) {
		dc_key_delay += nSamples;
	}
	else {
		dc_count += nSamples;
		for (i = 0; i < nSamples; i++)		// Correction for DC offset in samples
			dc_sum += samp[i];
		if (dc_count > quisk_sound_state.sample_rate * 2) {
			dc_average = dc_sum / dc_count;
			dc_sum = 0;
			dc_count = 0;
			//printf("dc average %lf   %lf %d\n", creal(dc_average), cimag(dc_average), dc_count);
			//printf("dc polar %.0lf   %d\n", cabs(dc_average),
			   		//	(int)(360.0 / 2 / M_PI * atan2(cimag(dc_average), creal(dc_average))));
		}
	}
	if (use_remove_dc)
		for (i = 0; i < nSamples; i++)	// Correction for DC offset in samples
			samp[i] -= dc_average;
	return nSamples;
}

static int quisk_hermes_is_ready(int rx_udp_socket)
{		// Start Hermes; return 1 when we are ready to receive data
	unsigned char buf[1500];
	int i, dummy;
	struct timeval tm_wait;
	fd_set fds;

	if (rx_udp_socket == INVALID_SOCKET)
		return 0;
	switch (quisk_multirx_state) {
	case 0:			// Start or restart
		buf[0] = 0xEF;
		buf[1] = 0xFE;
		buf[2] = 0x04;
		buf[3] = 0x00;
		for (i = 4; i < 64; i++)
			buf[i] = 0;
		send(rx_udp_socket, (char *)buf, 64, 0);		// send Stop
		quisk_multirx_state++;
		QuiskSleepMicrosec(2000);
		return 0;
	case 1:
		buf[0] = 0xEF;
		buf[1] = 0xFE;
		buf[2] = 0x04;
		buf[3] = 0x00;
		for (i = 4; i < 64; i++)
			buf[i] = 0;
		send(rx_udp_socket, (char *)buf, 64, 0);		// send Stop
		quisk_multirx_state++;
		QuiskSleepMicrosec(9000);
		return 0;
	case 2:
		while (1) {
			tm_wait.tv_sec = 0;			// throw away all pending records
			tm_wait.tv_usec = 0;
			FD_ZERO (&fds);
			FD_SET (rx_udp_socket, &fds);
			if (select (rx_udp_socket + 1, &fds, NULL, NULL, &tm_wait) != 1)
				break;
			recv(rx_udp_socket, (char *)buf, 1500,  0);
		}
		quisk_multirx_state++;
		return 0;
	case 3:
		quisk_multirx_count = quisk_pc_to_hermes[3] >> 3 & 0x7;		// number of receivers
		for (i = 0; i < quisk_multirx_count; i++)
			if ( ! multirx_fft_data[i].samples)		// Check that buffer exists
				multirx_fft_data[i].samples = (fftw_complex *)malloc(multirx_fft_width * sizeof(fftw_complex));
		quisk_hermes_tx_send(0, NULL);
		quisk_multirx_state++;
		return 0;
	case 4:
	case 5:
	case 6:
	case 7:
		dummy = 999999;		// enable transmit
		quisk_hermes_tx_send(rx_udp_socket, &dummy);	// send packets with number of receivers
		quisk_multirx_state++;
		QuiskSleepMicrosec(2000);
		return 0;
	case 8:
		if (quisk_rx_udp_started) {
			quisk_multirx_state++;
		}
		else {
			// send our return address until we receive UDP blocks
			buf[0] = 0xEF;
			buf[1] = 0xFE;
			buf[2] = 0x04;
			buf[3] = 0x01;
			for (i = 4; i < 64; i++)
				buf[i] = 0;
			send(rx_udp_socket, (char *)buf, 64, 0);
			QuiskSleepMicrosec(2000);
		}
		return 1;
	default:
		return 1;
	}
}

static int read_rx_udp10(complex double * samp)	// Read samples from UDP using the Hermes protocol.
{		// Size of complex sample array is SAMP_BUFFER_SIZE.  Called from the sound thread.
	ssize_t bytes;
	unsigned char buf[1500];
	unsigned int seq;
	static unsigned int seq0;
	static int key_state;
	static int tx_records;
	static int max_multirx_count=0;
	int i, j, nSamples, xr, xi, index, start, want_samples, dindex, state, num_records;
	complex double c;
	struct timeval tm_wait;
	fd_set fds;

	if ( ! quisk_hermes_is_ready(rx_udp_socket)) {
		seq0 = 0;
		key_state = 0;
		tx_records = 0;
		quisk_rx_udp_started = 0;
		multirx_fft_next_index = 0;
		multirx_fft_next_state = 0;
		for (i = 0; i < QUISK_MAX_RECEIVERS; i++)
			multirx_fft_data[i].index = 0;
		return 0;
	}
	nSamples = 0;
	want_samples = (int)(quisk_sound_state.data_poll_usec * 1e-6 * quisk_sound_state.sample_rate + 0.5);
	num_records = 504 / ((quisk_multirx_count + 1) * 6 + 2);	// number of samples in each of two blocks for each receiver
	if (quisk_multirx_count) {
		if (multirx_sample_size < want_samples + 2000) {
			multirx_sample_size = want_samples * 2 + 2000;
			for (i = 0; i < max_multirx_count; i++) {
				free(multirx_cSamples[i]);
				multirx_cSamples[i] = (complex double *)malloc(multirx_sample_size * sizeof(complex double));
			}
		}
		if (quisk_multirx_count > max_multirx_count) {
			for (i = max_multirx_count; i < quisk_multirx_count; i++)
				multirx_cSamples[i] = (complex double *)malloc(multirx_sample_size * sizeof(complex double));
			max_multirx_count = quisk_multirx_count;
		}
	}
	while (nSamples < want_samples) {		// read several UDP blocks
		tm_wait.tv_sec = 0;
		tm_wait.tv_usec = 100000; // Linux seems to have problems with very small time intervals
		FD_ZERO (&fds);
		FD_SET (rx_udp_socket, &fds);
		i = select (rx_udp_socket + 1, &fds, NULL, NULL, &tm_wait);		// blocking wait
		if (i == 1)
			;
		else if (i == 0) {
#if DEBUG_IO
			printf("Udp socket timeout\n");
#endif
			return 0;
		}
		else {
#if DEBUG_IO
			printf("Udp select error %d\n", i);
#endif
			return 0;
		}
		bytes = recv(rx_udp_socket, (char *)buf, 1500,  0);			// blocking read
		if (bytes != 1032 || buf[0] != 0xEF || buf[1] != 0xFE || buf[2] != 0x01) {		// Known size of sample block
			quisk_sound_state.read_error++;
#if DEBUG_IO
			printf("read_rx_udp10: Bad block size %d or header\n", (int)bytes);
#endif
			return 0;
		}
		if (buf[3] != 0x06)		// End point 6: I/Q and mic samples
			return 0;
		seq = buf[4] << 24 | buf[5] << 16 | buf[6] << 8 | buf[7];	// sequence number
		quisk_rx_udp_started = 1;
		tx_records += num_records * 2;		// total samples for each receiver
		quisk_hermes_tx_send(rx_udp_socket, &tx_records);		// send Tx samples, decrement tx_records
		if (seq != seq0) {
#if DEBUG_IO
			printf("read_rx_udp10: Bad sequence want %d got %d\n", seq0, seq);
#endif
			quisk_sound_state.read_error++;
		}
		seq0 = seq + 1;		// Next expected sequence number
		for (start = 11; start < 1000; start += 512) {
			// check the sync bytes
			if (buf[start - 3] != 0x7F || buf[start - 2] != 0x7F || buf[start - 1] != 0x7F) {
#if DEBUG_IO
				printf("read_rx_udp10: Bad sync byte\n");
#endif
				quisk_sound_state.read_error++;
			}
			// read five bytes of control information.  start is the index of C0.
			dindex = buf[start] >> 3;
			if (dindex >= 0 && dindex <= 4) {		// Save the data returned by the hardware
				quisk_hermes_to_pc[dindex * 4    ] = buf[start + 1];	// C1 to C4
				quisk_hermes_to_pc[dindex * 4 + 1] = buf[start + 2];
				quisk_hermes_to_pc[dindex * 4 + 2] = buf[start + 3];
				quisk_hermes_to_pc[dindex * 4 + 3] = buf[start + 4];
			}
			if (dindex == 0) {		// C0 is 0b00000xxx
				if ((quisk_hermes_to_pc[0] & 0x01) != 0)	// C1
					quisk_sound_state.overrange++;
				if (rxMode == 0 || rxMode == 1) {
					state = buf[start] & 0x01;	// C0 bit zero is CW key state
					state |= is_PTT_down;
				}
				else {
					state = is_PTT_down;
				}
				if (state != key_state) {
					key_state = state;
					quisk_set_key_down(state);
				}
			}
			// convert 24-bit samples to 32-bit samples; int must be 32 bits.
			index = start + 5;
			for (i = 0; i < num_records; i++) {		// read records
				xi = buf[index    ] << 24 | buf[index + 1] << 16 | buf[index + 2] << 8;
				xr = buf[index + 3] << 24 | buf[index + 4] << 16 | buf[index + 5] << 8;
				samp[nSamples] = xr + xi * I;		// first receiver
				index += 6;
				for (j = 0; j < quisk_multirx_count; j++) {		// multirx receivers
					xi = buf[index    ] << 24 | buf[index + 1] << 16 | buf[index + 2] << 8;
					xr = buf[index + 3] << 24 | buf[index + 4] << 16 | buf[index + 5] << 8;
					c = xr + xi * I;
					multirx_cSamples[j][nSamples] = c;
					if (multirx_fft_data[j].index < multirx_fft_width)
						multirx_fft_data[j].samples[multirx_fft_data[j].index++] = c;
					index += 6;
				}
				nSamples++;
				index += 2;
			}
		}
	}
	if ((quisk_pc_to_hermes[3] >> 3 & 0x7) != quisk_multirx_count &&	// change in number of receivers
		( ! quisk_multirx_count || multirx_fft_next_state == 2)) {		// wait until the current FFT is finished
			quisk_multirx_state = 0;		// Do not change receiver count without stopping Hermes and restarting
	}
	if (multirx_fft_next_state == 2) {		// previous FFT is done
		if (++multirx_fft_next_index >= quisk_multirx_count)
			multirx_fft_next_index = 0;
		multirx_fft_next_state = 0;
	}
	if (quisk_multirx_count && multirx_fft_next_state == 0 && multirx_fft_data[multirx_fft_next_index].index >= multirx_fft_width) {		// FFT is read to run
		memcpy(multirx_fft_next_samples, multirx_fft_data[multirx_fft_next_index].samples, multirx_fft_width * sizeof(fftw_complex));
		multirx_fft_data[multirx_fft_next_index].index = 0;
		multirx_fft_next_time = 1.0 / graph_refresh / quisk_multirx_count;
		multirx_fft_next_state = 1;			// this FFT is ready to run
	}
	return nSamples;
}

static int read_rx_udp17(complex double * cSamples0)	// Read samples from UDP
{		// Size of complex sample array is SAMP_BUFFER_SIZE
	ssize_t bytes;
	unsigned char buf[1500];	// Maximum Ethernet is 1500 bytes.
	static unsigned char seq0;	// must be 8 bits
	int i, n, nSamples0, xr, xi, index, want_samples, key_down;
	complex double sample;
	unsigned char * ptxr, * ptxi;
	struct timeval tm_wait;
	fft_data * ptFFT;
	fd_set fds;
	static complex double dc_average = 0;		// Average DC component in samples
	static complex double dc_sum = 0;
	static int dc_count = 0;
	static int dc_key_delay = 0;
	static int block_number=0;
	// Data from the receiver is little-endian

	if ( ! rx_udp_gain_correct) {	// correct for second stage CIC decimation JIM JIM
		int dec;
		dec = (int)(rx_udp_clock / 30.0 / fft_sample_rate + 0.5);
		if ((dec / 3) * 3 == dec)		// Decimation by a factor of 3
			rx_udp_gain_correct = 1.053497942;
		else						// Decimation by factors of two
			rx_udp_gain_correct = 1.0;
		//printf ("Gain %d %.8lf\n", dec, rx_udp_gain_correct);
	}
	if ( ! quisk_rx_udp_started) {	// we never received any data
		// send our return address until we receive UDP blocks
		tm_wait.tv_sec = 0;
		tm_wait.tv_usec = 5000;
		FD_ZERO (&fds);
		FD_SET (rx_udp_socket, &fds);
		if (select (rx_udp_socket + 1, &fds, NULL, NULL, &tm_wait) == 1) {	// see if data is available
			bytes = recv(rx_udp_socket, (char *)buf, 1500,  0);	// throw away the first block
			seq0 = buf[0] + 1;	// Next expected sequence number
			quisk_rx_udp_started = 1;
#if DEBUG_IO
			printf("Udp data started\n");
#endif
		}
		else {		// send our return address to the sample source
			buf[0] = buf[1] = 0x72;	// UDP command "register return address"
			send(rx_udp_socket, (char *)buf, 2, 0);
			return 0;
		}
	}
	nSamples0 = 0;
	want_samples = (int)(quisk_sound_state.data_poll_usec * 1e-6 * quisk_sound_state.sample_rate + 0.5);
	key_down = quisk_is_key_down();
	while (nSamples0 < want_samples) {		// read several UDP blocks
		tm_wait.tv_sec = 0;
		tm_wait.tv_usec = 100000; // Linux seems to have problems with very small time intervals
		FD_ZERO (&fds);
		FD_SET (rx_udp_socket, &fds);
		i = select (rx_udp_socket + 1, &fds, NULL, NULL, &tm_wait);
		if (i == 1)
			;
		else if (i == 0) {
#if DEBUG_IO
			printf("Udp socket timeout\n");
#endif
			return 0;
		}
		else {
#if DEBUG_IO
			printf("Udp select error %d\n", i);
#endif
			return 0;
		}
		bytes = recv(rx_udp_socket, (char *)buf, 1500,  0);	// blocking read
		if (bytes != RX_UDP_SIZE) {		// Known size of sample block
			quisk_sound_state.read_error++;
#if DEBUG_IO
			printf("read_rx_udp: Bad block size\n");
#endif
			continue;
		}
		// buf[0] is the sequence number
		// buf[1] is the status:
		//		bit 0:  key up/down state
		//		bit 1:	set for ADC overrange (clip)
		if (buf[0] != seq0) {
#if DEBUG_IO
			printf("read_rx_udp: Bad sequence want %3d got %3d\n",
					(unsigned int)seq0, (unsigned int)buf[0]);
#endif
			quisk_sound_state.read_error++;
		}
		seq0 = buf[0] + 1;		// Next expected sequence number
		//quisk_set_key_down(buf[1] & 0x01);	// bit zero is key state
		if (buf[1] & 0x02)					// bit one is ADC overrange
			quisk_sound_state.overrange++;
		index = 2;
		ptxr = (unsigned char *)&xr;
		ptxi = (unsigned char *)&xi;
		// convert 24-bit samples to 32-bit samples; int must be 32 bits.
		while (index < bytes) {
			if (is_little_endian) {
				xr = xi = 0;
				memcpy (ptxr + 1, buf + index, 3);
				index += 3;
				memcpy (ptxi + 1, buf + index, 3);
				index += 3;
				sample = (xr + xi * I) * rx_udp_gain_correct;
			}
			else {		// big-endian
				*(ptxr    ) = buf[index + 2];
				*(ptxr + 1) = buf[index + 1];
				*(ptxr + 2) = buf[index    ];
				*(ptxr + 3) = 0;
				index += 3;
				*(ptxi    ) = buf[index + 2];
				*(ptxi + 1) = buf[index + 1];
				*(ptxi + 2) = buf[index    ];
				*(ptxi + 3) = 0;
				index += 3;
				sample = (xr + xi * I) * rx_udp_gain_correct;
			}
			if (xr & 0x100) {		// channel 1
				if (quisk_invert_spectrum)		// Invert spectrum
					sample = conj(sample);
				// Put samples into the fft input array.
				ptFFT = fft_data_array + fft_data_index;
				if ( ! (xi & 0x100)) {		// zero marker for start of first block
					if (ptFFT->index != 0) {
						//printf("Resync block\n");
						fft_error++;
						ptFFT->index = 0;
					}
					ptFFT->block = block_number = 0;
				}
				else if (ptFFT->index == 0) {
					if (scan_blocks) {
						if (++block_number < scan_blocks)
							ptFFT->block = block_number;
						else
							ptFFT->block = block_number = 0;
					}
					else {
						ptFFT->block = block_number = 0;
					}
					if (scan_blocks && block_number >= scan_blocks)
						printf("Bad block_number %d\n", block_number);
				}
				ptFFT->samples[ptFFT->index] = sample;
				if ((isFDX || ! key_down) && ++(ptFFT->index) >= fft_size) {		// check sample count
					n = fft_data_index + 1;				// next FFT data location
					if (n >= FFT_ARRAY_SIZE)
						n = 0;
					if (fft_data_array[n].filled == 0) {				// Is the next buffer empty?
						fft_data_array[n].index = 0;
						fft_data_array[n].block = 0;
						fft_data_array[fft_data_index].filled = 1;	// Mark the previous buffer ready.
						fft_data_index = n;							// Write samples into the new buffer.
						ptFFT = fft_data_array + fft_data_index;
					}
					else {				// no place to write samples
						ptFFT->index = 0;
						ptFFT->block = 0;
						fft_error++;
					}
				}
			}
			else {					// channel 0
				cSamples0[nSamples0++] = sample;
			}
		}
	}
	if (key_down) {
		dc_key_delay = 0;
		dc_sum = 0;
		dc_count = 0;
	}
	else if (dc_key_delay < quisk_sound_state.sample_rate) {
		dc_key_delay += nSamples0;
	}
	else {
		dc_count += nSamples0;
		for (i = 0; i < nSamples0; i++)		// Correction for DC offset in samples
			dc_sum += cSamples0[i];
		if (dc_count > quisk_sound_state.sample_rate * 2) {
			dc_average = dc_sum / dc_count;
			dc_sum = 0;
			dc_count = 0;
			//printf("dc average %lf   %lf %d\n", creal(dc_average), cimag(dc_average), dc_count);
			//printf("dc polar %.0lf   %d\n", cabs(dc_average),
			   		//	(int)(360.0 / 2 / M_PI * atan2(cimag(dc_average), creal(dc_average))));
		}
	}
	if (use_remove_dc)
		for (i = 0; i < nSamples0; i++)	// Correction for DC offset in samples
			cSamples0[i] -= dc_average;
	return nSamples0;
}

static PyObject * open_rx_udp(PyObject * self, PyObject * args)
{
	const char * ip;
	int port;
	char buf[128];
	struct sockaddr_in Addr;
	int recvsize;

#if DEBUG_IO
	int intbuf;
#ifdef MS_WINDOWS
	int bufsize = sizeof(int);
#else
	socklen_t bufsize = sizeof(int);
#endif
#endif

#ifdef MS_WINDOWS
	WORD wVersionRequested;
	WSADATA wsaData;
#endif

	if (!PyArg_ParseTuple (args, "si", &ip, &port))
		return NULL;
#ifdef MS_WINDOWS
	wVersionRequested = MAKEWORD(2, 2);
	if (WSAStartup(wVersionRequested, &wsaData) != 0) {
		sprintf(buf, "Failed to initialize Winsock (WSAStartup)");
		return PyString_FromString(buf);
	}
	else {
		cleanupWSA = 1;
	}
#endif
#if DEBUG_IO
    printf("open_rx_udp to IP %s port 0x%X\n", ip, port);
#endif
	quisk_using_udp = 1;
	rx_udp_socket = socket(PF_INET, SOCK_DGRAM, 0);
	if (rx_udp_socket != INVALID_SOCKET) {
		recvsize = 256000;
		setsockopt(rx_udp_socket, SOL_SOCKET, SO_RCVBUF, (char *)&recvsize, sizeof(recvsize));
		memset(&Addr, 0, sizeof(Addr)); 
		Addr.sin_family = AF_INET;
		Addr.sin_port = htons(port);
#ifdef MS_WINDOWS
		Addr.sin_addr.S_un.S_addr = inet_addr(ip);
#else
		inet_aton(ip, &Addr.sin_addr);
#endif
		if (connect(rx_udp_socket, (const struct sockaddr *)&Addr, sizeof(Addr)) != 0) {
			shutdown(rx_udp_socket, QUISK_SHUT_BOTH);
			close(rx_udp_socket);
			rx_udp_socket = INVALID_SOCKET;
			sprintf(buf, "Failed to connect to UDP %s port 0x%X", ip, port);
		}
		else {
			sprintf(buf, "Capture from UDP %s port 0x%X", ip, port);
			if (quisk_use_rx_udp == 17)
				quisk_sample_source(NULL, close_udp, read_rx_udp17);
			else if (quisk_use_rx_udp == 10)
				quisk_sample_source(NULL, close_udp10, read_rx_udp10);
			else
				quisk_sample_source(NULL, close_udp, quisk_read_rx_udp);
#if DEBUG_IO
			if (getsockopt(rx_udp_socket, SOL_SOCKET, SO_RCVBUF, (char *)&intbuf, &bufsize) == 0)
				printf("UDP socket receive buffer size %d\n", intbuf);
			else
				printf ("Failure SO_RCVBUF\n");
#endif
		}
	}
	else {
		sprintf(buf, "Failed to open socket");
	}
	return PyString_FromString(buf);
}

static PyObject * open_sound(PyObject * self, PyObject * args)
{
    int rate;
	char * capt, * play, * mname, * mip, * mpname;

	if (!PyArg_ParseTuple (args, "ssiiissiiiidsi", &capt, &play,
				&rate,
				&quisk_sound_state.data_poll_usec,
				&quisk_sound_state.latency_millisecs,
				&mname, &mip,
				&quisk_sound_state.tx_audio_port,
				&quisk_sound_state.mic_sample_rate,
				&quisk_sound_state.mic_channel_I,
				&quisk_sound_state.mic_channel_Q,
				&quisk_sound_state.mic_out_volume,
				&mpname,
				&quisk_sound_state.mic_playback_rate
				))
		return NULL;

#if SAMPLES_FROM_FILE == 1
    QuiskWavWriteOpen(&hWav, "band.wav", 3, 2, 4, 48000, 1E3 / CLIP32);
#elif SAMPLES_FROM_FILE == 2
    QuiskWavReadOpen(&hWav, "band.wav", 3, 2, 4, 48000, CLIP32 / 1E6);
#endif
	if (quisk_sound_state.mic_out_volume > 0.7)	// maximum value must leave headroom for
		quisk_sound_state.mic_out_volume = 0.7;	//   the amplitude and phase adjustments
	quisk_sound_state.playback_rate = QuiskGetConfigInt("playback_rate", 48000);
	quisk_mic_preemphasis = QuiskGetConfigDouble("mic_preemphasis", 0.6);
	//if (quisk_mic_preemphasis < 0.0 || quisk_mic_preemphasis > 1.0)
	//	quisk_mic_preemphasis = 1.0;
	quisk_mic_clip = QuiskGetConfigDouble("mic_clip", 3.0);
	agc_release_time = QuiskGetConfigDouble("agc_release_time", 1.0);
	strncpy(quisk_sound_state.dev_capt_name, capt, QUISK_SC_SIZE);
	strncpy(quisk_sound_state.dev_play_name, play, QUISK_SC_SIZE);
	strncpy(quisk_sound_state.mic_dev_name, mname, QUISK_SC_SIZE);
	strncpy(quisk_sound_state.name_of_mic_play, mpname, QUISK_SC_SIZE);
	strncpy(quisk_sound_state.mic_ip, mip, IP_SIZE);
	strncpy(quisk_sound_state.IQ_server, QuiskGetConfigString("IQ_Server_IP", ""), IP_SIZE);
	quisk_sound_state.verbose_pulse = QuiskGetConfigInt("pulse_audio_verbose_output", 0);
	fft_error = 0;
	quisk_open_sound();
	quisk_open_mic();
	return get_state(NULL, NULL);
}

static PyObject * close_sound(PyObject * self, PyObject * args)
{
	if (!PyArg_ParseTuple (args, ""))
		return NULL;
	quisk_close_mic();
	quisk_close_sound();
	quisk_close_key();
#if SAMPLES_FROM_FILE
    QuiskWavClose(&hWav);
#endif
	Py_INCREF (Py_None);
	return Py_None;
}

static PyObject * change_scan(PyObject * self, PyObject * args)	// Called from GUI thread
{	// Change to a new FFT rate

	if (!PyArg_ParseTuple (args, "iidii", &scan_blocks, &scan_sample_rate, &scan_valid, &scan_vfo0, &scan_deltaf))
		return NULL;
	Py_INCREF (Py_None);
	return Py_None;
}

static PyObject * change_rates(PyObject * self, PyObject * args)	// Called from GUI thread
{	// Change to new sample rates

    multiple_sample_rates = 1;
	if (!PyArg_ParseTuple (args, "iiii", &quisk_sound_state.sample_rate, &vfo_audio, &fft_sample_rate, &vfo_screen))
		return NULL;
	Py_INCREF (Py_None);
	return Py_None;
}

static PyObject * change_rate(PyObject * self, PyObject * args)	// Called from GUI thread
{	// Change to a new sample rate
	int rate, avg;

	if (!PyArg_ParseTuple (args, "ii", &rate, &avg))
		return NULL;
	if (multiple_sample_rates) {
		fft_sample_rate = rate;
	}
	else {
		quisk_sound_state.sample_rate = rate;
		fft_sample_rate = rate;
	}
	rx_udp_gain_correct = 0;	// re-calculate JIM
	Py_INCREF (Py_None);
	return Py_None;
}

static PyObject * read_sound(PyObject * self, PyObject * args)
{
	int n;

	if (!PyArg_ParseTuple (args, ""))
		return NULL;
Py_BEGIN_ALLOW_THREADS
	n = quisk_read_sound();
Py_END_ALLOW_THREADS
	return PyInt_FromLong(n);
}

static PyObject * start_sound(PyObject * self, PyObject * args)
{
	if (!PyArg_ParseTuple (args, ""))
		return NULL;
	quisk_start_sound();
	Py_INCREF (Py_None);
	return Py_None;
}

static PyObject * mixer_set(PyObject * self, PyObject * args)
{
	char * card_name;
	int numid;
	PyObject * value;
	char err_msg[QUISK_SC_SIZE];

	if (!PyArg_ParseTuple (args, "siO", &card_name, &numid, &value))
		return NULL;

	quisk_mixer_set(card_name, numid, value, err_msg, QUISK_SC_SIZE);
	return PyString_FromString(err_msg);
}

static PyObject * pc_to_hermes(PyObject * self, PyObject * args)
{
	PyObject * byteArray;

	if (!PyArg_ParseTuple (args, "O", &byteArray))
		return NULL;
	if ( ! PyByteArray_Check(byteArray)) {
		PyErr_SetString (QuiskError, "Object is not a bytearray.");
		return NULL;
	}
	if (PyByteArray_Size(byteArray) != 17 * 4) {
		PyErr_SetString (QuiskError, "Bytearray size must be 17 * 4.");
		return NULL;
	}
	memmove(quisk_pc_to_hermes, PyByteArray_AsString(byteArray), 17 * 4);
	Py_INCREF (Py_None);
	return Py_None;
}

static PyObject * hermes_to_pc(PyObject * self, PyObject * args)
{
	if (!PyArg_ParseTuple (args, ""))
		return NULL;
	return PyByteArray_FromStringAndSize((char *)quisk_hermes_to_pc, 5 * 4);
}

static PyObject * invert_spectrum(PyObject * self, PyObject * args)
{
	if (!PyArg_ParseTuple (args, "i", &quisk_invert_spectrum))
		return NULL;
	Py_INCREF (Py_None);
	return Py_None;
}

static PyObject * set_agc(PyObject * self, PyObject * args)
{  /* Change the AGC level */
	if (!PyArg_ParseTuple (args, "d", &agcReleaseGain))
		return NULL;
	Py_INCREF (Py_None);
	return Py_None;
}

static PyObject * set_filters(PyObject * self, PyObject * args)
{  // Enter the coefficients of the I and Q digital filters.  The storage for
   // filters is not malloc'd because filters may be changed while being used.
   // Multiple filters are available at nFilter.
	PyObject * filterI, * filterQ;
	int i, size, nFilter, bw;
	PyObject * obj;
	char buf98[98];

	if (!PyArg_ParseTuple (args, "OOii", &filterI, &filterQ, &bw, &nFilter))
		return NULL;
	if (PySequence_Check(filterI) != 1) {
		PyErr_SetString (QuiskError, "Filter I is not a sequence");
		return NULL;
	}
	if (PySequence_Check(filterQ) != 1) {
		PyErr_SetString (QuiskError, "Filter Q is not a sequence");
		return NULL;
	}
	size = PySequence_Size(filterI);
	if (size != PySequence_Size(filterQ)) {
		PyErr_SetString (QuiskError, "The size of filters I and Q must be equal");
		return NULL;
	}
	if (size >= MAX_FILTER_SIZE) {
		snprintf(buf98, 98, "Filter size must be less than %d", MAX_FILTER_SIZE);
		PyErr_SetString (QuiskError, buf98);
		return NULL;
	}
	if (nFilter == 0)
		filter_bandwidth = bw;
	for (i = 0; i < size; i++) {
		obj = PySequence_GetItem(filterI, i);
		cFilterI[nFilter][i] = PyFloat_AsDouble(obj);
		Py_XDECREF(obj);
		obj = PySequence_GetItem(filterQ, i);
		cFilterQ[nFilter][i] = PyFloat_AsDouble(obj);
		Py_XDECREF(obj);
	}
	sizeFilter = size;
	Py_INCREF (Py_None);
	return Py_None;
}

static PyObject * set_auto_notch(PyObject * self, PyObject * args)
{
	if (!PyArg_ParseTuple (args, "i", &quisk_auto_notch))
		return NULL;
	dAutoNotch(NULL, 0, 0, 0);
	Py_INCREF (Py_None);
	return Py_None;
}

static PyObject * set_noise_blanker(PyObject * self, PyObject * args)
{
	if (!PyArg_ParseTuple (args, "i", &quisk_noise_blanker))
		return NULL;
	Py_INCREF (Py_None);
	return Py_None;
}

static PyObject * set_rx_mode(PyObject * self, PyObject * args)
{
	if (!PyArg_ParseTuple (args, "i", &rxMode))
		return NULL;
	quisk_set_tx_mode();
	Py_INCREF (Py_None);
	return Py_None;
}

static PyObject * set_spot_level(PyObject * self, PyObject * args)
{
	if (!PyArg_ParseTuple (args, "i", &quiskSpotLevel))
		return NULL;
	Py_INCREF (Py_None);
	return Py_None;
}

static PyObject * set_imd_level(PyObject * self, PyObject * args)
{
	if (!PyArg_ParseTuple (args, "i", &quiskImdLevel))
		return NULL;
	Py_INCREF (Py_None);
	return Py_None;
}

static PyObject * set_mic_out_volume(PyObject * self, PyObject * args)
{
	int level;

	if (!PyArg_ParseTuple (args, "i", &level))
		return NULL;
	quisk_sound_state.mic_out_volume = level / 100.0;
	Py_INCREF (Py_None);
	return Py_None;
}

static PyObject * set_split_rxtx(PyObject * self, PyObject * args)
{
	if (!PyArg_ParseTuple (args, "i", &split_rxtx))
		return NULL;
	Py_INCREF (Py_None);
	return Py_None;
}

static PyObject * set_tune(PyObject * self, PyObject * args)
{  /* Change the tuning frequency */
	if (!PyArg_ParseTuple (args, "ii", &rx_tune_freq, &quisk_tx_tune_freq))
		return NULL;
	Py_INCREF (Py_None);
	return Py_None;
}

static PyObject * set_sidetone(PyObject * self, PyObject * args)
{
	double delay;	// play extra silence after key-up, in milliseconds

	if (!PyArg_ParseTuple (args, "idid", &quisk_sidetoneCtrl, &sidetoneVolume, &rit_freq, &delay))
		return NULL;
	sidetonePhase = cexp((I * 2.0 * M_PI * abs(rit_freq)) / quisk_sound_state.playback_rate);
	keyupDelay = (int)(quisk_sound_state.playback_rate *1e-3 * delay + 0.5);
	if (rxMode == 0 || rxMode == 1)
		dAutoNotch(NULL, 0, 0, 0);		// for CW, changing the RIT affects autonotch
	Py_INCREF (Py_None);
	return Py_None;
}

static PyObject * set_squelch(PyObject * self, PyObject * args)
{  /* Change the squelch parameter */
	if (!PyArg_ParseTuple (args, "d", &squelch_level))
		return NULL;
	Py_INCREF (Py_None);
	return Py_None;
}

static PyObject * set_kill_audio(PyObject * self, PyObject * args)
{	/* replace radio sound with silence */
	if (!PyArg_ParseTuple (args, "i", &kill_audio))
		return NULL;
	Py_INCREF (Py_None);
	return Py_None;
}

static PyObject * tx_hold_state(PyObject * self, PyObject * args)
{	// Query or set the transmit hold state
	int i;

	if (!PyArg_ParseTuple (args, "i", &i))
		return NULL;
	if (i >= 0)		// arg < 0 is a Query for the current value
		quiskTxHoldState = i;
	return PyInt_FromLong(quiskTxHoldState);
}

static PyObject * set_transmit_mode(PyObject * self, PyObject * args)
{	/* Set the radio to transmit mode */
	if (!PyArg_ParseTuple (args, "i", &quisk_transmit_mode))
		return NULL;
	Py_INCREF (Py_None);
	return Py_None;
}

static PyObject * set_volume(PyObject * self, PyObject * args)
{
	if (!PyArg_ParseTuple (args, "d", &quisk_audioVolume))
		return NULL;
	Py_INCREF (Py_None);
	return Py_None;
}

static PyObject * set_ctcss(PyObject * self, PyObject * args)
{
	if (!PyArg_ParseTuple (args, "d", &quisk_ctcss_freq))
		return NULL;
	Py_INCREF (Py_None);
	return Py_None;
}

static PyObject * set_key_down(PyObject * self, PyObject * args)
{
	int down;

	if (!PyArg_ParseTuple (args, "i", &down))
		return NULL;
	quisk_set_key_down(down);
	Py_INCREF (Py_None);
	return Py_None;
}

static PyObject * set_PTT(PyObject * self, PyObject * args)
{
	if (!PyArg_ParseTuple (args, "i", &is_PTT_down))
		return NULL;
	Py_INCREF (Py_None);
	return Py_None;
}

static PyObject * set_multirx_mode(PyObject * self, PyObject * args)
{
	int index, mode;

	if (!PyArg_ParseTuple (args, "ii", &index, &mode))
		return NULL;
	if (index < QUISK_MAX_RECEIVERS)
		multirx_mode[index] = mode;
	Py_INCREF (Py_None);
	return Py_None;
}

static PyObject * set_multirx_freq(PyObject * self, PyObject * args)
{
	int index, freq;

	if (!PyArg_ParseTuple (args, "ii", &index, &freq))
		return NULL;
	if (index < QUISK_MAX_RECEIVERS)
		multirx_freq[index] = freq;
	Py_INCREF (Py_None);
	return Py_None;
}

static PyObject * set_multirx_play_method(PyObject * self, PyObject * args)
{
	if (!PyArg_ParseTuple (args, "i", &multirx_play_method))
		return NULL;
	Py_INCREF (Py_None);
	return Py_None;
}

static PyObject * set_multirx_play_channel(PyObject * self, PyObject * args)
{
	if (!PyArg_ParseTuple (args, "i", &multirx_play_channel))
		return NULL;
	if (multirx_play_channel >= QUISK_MAX_RECEIVERS)
		multirx_play_channel = -1;
	Py_INCREF (Py_None);
	return Py_None;
}

static PyObject * get_multirx_graph(PyObject * self, PyObject * args)	// Called by the GUI thread
{
	int i, j, k;
	double d1, d2, scale;
	static double * fft_window=NULL;		// Window for FFT data
	PyObject * retrn, * data;
	static double time0=0;			// time of last graph

	if (!PyArg_ParseTuple (args, ""))
		return NULL;
	if ( ! fft_window) {
		// Create the fft window
		fft_window = (double *) malloc(sizeof(double) * multirx_fft_width);
		for (i = 0, j = -multirx_fft_width / 2; i < multirx_fft_width; i++, j++)
			fft_window[i] = 0.5 + 0.5 * cos(2. * M_PI * j / multirx_fft_width);	// Hanning
	}
	retrn = PyTuple_New(2);
	if (multirx_fft_next_state == 1 && QuiskTimeSec() - time0 >= multirx_fft_next_time) {
		time0 = QuiskTimeSec();
		// The FFT is ready to run.  Calculate FFT.
		for (i = 0; i < multirx_fft_width; i++)		// multiply by window
			multirx_fft_next_samples[i] *= fft_window[i];
		fftw_execute(multirx_fft_next_plan);
		// Average the fft data into the graph in order of frequency
		data = PyTuple_New(multirx_data_width);
		scale = log10(multirx_fft_width) + 31.0 * log10(2.0);
		scale *= 20.0;
		j = MULTIRX_FFT_MULT;
		k = 0;
		d1 = 0;
		for (i = multirx_fft_width / 2; i < multirx_fft_width; i++) {			// Negative frequencies
			d1 += cabs(multirx_fft_next_samples[i]);
			if (--j == 0) {
				d2 = 20.0 * log10(d1) - scale;
				if (d2 < -200)
					d2 = -200;
				PyTuple_SetItem(data, k++, PyFloat_FromDouble(d2));
				d1 = 0;
				j = MULTIRX_FFT_MULT;
			}
		}
		for (i = 0; i < multirx_fft_width / 2; i++) {					// Positive frequencies
			d1 += cabs(multirx_fft_next_samples[i]);
			if (--j == 0) {
				d2 = 20.0 * log10(d1) - scale;
				if (d2 < -200)
					d2 = -200;
				PyTuple_SetItem(data, k++, PyFloat_FromDouble(d2));
				d1 = 0;
				j = MULTIRX_FFT_MULT;
			}
		}
		PyTuple_SetItem(retrn, 0, data);
		PyTuple_SetItem(retrn, 1, PyInt_FromLong(multirx_fft_next_index));
		multirx_fft_next_state = 2;			// This FFT is done.
	}
	else {
		data = PyTuple_New(0);
		PyTuple_SetItem(retrn, 0, data);
		PyTuple_SetItem(retrn, 1, PyInt_FromLong(-1));
	}
	return retrn;
}
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
