jmharvey1/SdrCwXcvr/Quisk/microphone.c

#include <Python.h>
#include <stdlib.h>
#include <math.h>
#include <sys/time.h>
#include <complex.h>
#include <fftw3.h>
#include "quisk.h"
#include <sys/types.h>
#include "microphone.h"
#include "filter.h"

#ifdef MS_WINDOWS
#include <Winsock2.h>
static int mic_cleanup = 0;		// must clean up winsock
#else
#include <sys/socket.h>
#include <arpa/inet.h>
#include <netinet/in.h>
#define		INVALID_SOCKET	-1
#endif

#if DEBUG_IO
static int debug_timer = 1;		// count up number of samples
#endif

// The microphone samples must be 48000 sps or 8000 sps.  The output sample
//  rate is always MIC_OUT_RATE samples per second

// FM needs pre-emphasis and de-emphasis.  See vk1od.net/FM/FM.htm for details.
// For IIR design, see http://www.abvolt.com/research/publications2.htm.

// Microhone preemphasis: boost high frequencies 0.00 to 1.00
double quisk_mic_preemphasis;
// Microphone clipping; try 3.0 or 4.0
double quisk_mic_clip;

// If true, decimate 48000 sps mic samples to 8000 sps for processing
#define DECIM_8000	1

// These are external:
int mic_max_display;				// display value of maximum microphone signal level 0 to 2**15 - 1
int quiskSpotLevel = -1;			// level is -1 for Spot button Off; else the Spot level 0 to 1000.
int quiskImdLevel = 500;			// level for rxMode IMD, 0 to 1000

static int mic_socket = INVALID_SOCKET;	// send microphone samples to a socket
static double mic_agc_level = 0.10;		// Mic levels below this are noise and are ignored

static int mic_level;			// maximum microphone signal level for display
static int mic_timer;			// time to display maximum mic level
static int align4;			// add two bytes to start of audio samples to align to 4 bytes
static double modulation_index = 1.6;	// For FM transmit, the modulation index

static int is_vox = 0;					// Is the VOX level exceeded?
static int vox_level = CLIP16;			// VOX trigger level as a number 0 to CLIP16
static int timeVOX = 2000;				// VOX hang time in milliseconds

static int doTxCorrect = 0;				// Corrections for UDP sample transmit
static double TxCorrectLevel;
static complex TxCorrectDc;

// Used for the Hermes protocol
#define HERMES_TX_BUF_SAMPLES	4800	// buffer size in I/Q samples (two shorts)
#define HERMES_TX_BUF_SHORTS	(HERMES_TX_BUF_SAMPLES * 2)
static int hermes_read_index;			// index to read from buffer
static int hermes_write_index;			// index to write to buffer
static int hermes_num_samples;			// number of samples in the buffer
static short hermes_buf[HERMES_TX_BUF_SHORTS];		// buffer to store Tx I/Q samples waiting to be sent at 48 ksps

#define TX_BLOCK_SHORTS		600		// transmit UDP packet with this many shorts (two bytes) (perhaps + 1)
#define MIC_MAX_HOLD_TIME	400		// Time to hold the maximum mic level on the Status screen in milliseconds

// If USE_GET_SIN is not zero, replace mic samples with a sin wave at a
// frequency determined by the sidetone slider and an amplitude determined
// by the Spot button level.
// If USE_GET_SIN is 1, pass these samples through the transmit filters.
// If USE_GET_SIN is 2, transmit these samples directly.
#define USE_GET_SIN		0

// If USE_2TONE is not zero, replace samples with a 2-tone test signal.
#define USE_2TONE		0

#if USE_GET_SIN
static void get_sin(complex double * cSamples, int count)
{	// replace mic samples with a sin wave
	int i;
	double freq;
	complex double phase1;		// Phase increment
	static complex double vector1 = CLIP32 / 2;

	// Use the sidetone slider 0 to 1000 to set frequency
	//freq = (quisk_sidetoneCtrl - 500) / 1000.0 * MIC_OUT_RATE;
	freq = quisk_sidetoneCtrl * 5;
	freq = ((int)freq / 50) * 50;
#if USE_GET_SIN == 2
	phase1 = cexp(I * 2.0 * M_PI * freq / MIC_OUT_RATE);
	count *= MIC_OUT_RATE / quisk_sound_state.mic_sample_rate;
#else
	phase1 = cexp(I * 2.0 * M_PI * freq / quisk_sound_state.mic_sample_rate);
#endif
	for (i = 0; i < count; i++) {
		vector1 *= phase1;
		cSamples[i] = vector1;
	}
#if DEBUG_IO
	if (debug_timer == 0)
		printf ("get_sin freq %.0lf\n", freq);
#endif
}
#endif

#if USE_2TONE
static void get_2tone(complex double * cSamples, int count)
{	// replace mic samples
	int i;
	static complex double phase1=0, phase2;		// Phase increment
	static complex double vector1;
	static complex double vector2;

	if (phase1 == 0) {		// initialize
		phase1 = cexp((I * 2.0 * M_PI * IMD_TONE_1) / quisk_sound_state.mic_sample_rate);
		phase2 = cexp((I * 2.0 * M_PI * IMD_TONE_2) / quisk_sound_state.mic_sample_rate);
		vector1 = CLIP32 / 2.0;
		vector2 = CLIP32 / 2.0;
	}
	for (i = 0; i < count; i++) {
		vector1 *= phase1;
		vector2 *= phase2;
		cSamples[i] = (vector1 + vector2);
	}
}
#endif

static double CcmPeak(double * dsamples, complex double * csamples, int count)
{
	int i, j;
	complex double csample;
	double dtmp, dsample, newlevel, oldlevel;
	static double out_short, out_long;
	static struct Ccmpr {
		int buf_size;
		int index_read;
		double themax;
		double level;
		double * d_samp;
		complex double * c_samp;
		double * levl;
	} dat = {0};

	if ( ! dat.buf_size) {		// initialize; the sample rate is 8000
		dat.buf_size = 8000 * 30 / 1000;	// total delay in samples
		dat.index_read = 0;					// index to output; and then write a new sample here
		dat.themax = 1.0;					// maximum level in the buffer
		dat.level = 1.0;					// current output level
		dat.d_samp = (double *) malloc(dat.buf_size * sizeof(double));		// buffer for double samples
		dat.c_samp = (complex double *) malloc(dat.buf_size * sizeof(complex double));	// buffer for complex samples
		dat.levl = (double *) malloc(dat.buf_size * sizeof(double));		// magnitude of the samples
		for (i = 0; i < dat.buf_size; i++) {
			dat.d_samp[i] = 0;
			dat.c_samp[i] = 0;
			dat.levl[i] = 1.0;
		}
		dtmp = 1.0 / 8000;		// sample time
		out_short  = 1.0 - exp(- dtmp / 0.010);		// short time constant
		out_long   = 1.0 - exp(- dtmp / 3.000);		// long time constant
		return 1.0;
	}
	for (i = 0; i < count; i++) {
		if (dsamples) {
			dsample = dsamples[i];
			dsamples[i] = dat.d_samp[dat.index_read] / dat.level;	// FIFO output
			dat.d_samp[dat.index_read] = dsample;		// write new sample at read index
			newlevel = fabs(dsample);
		}
		else {
			csample = csamples[i];
			csamples[i] = dat.c_samp[dat.index_read] / dat.level;	// FIFO output
			dat.c_samp[dat.index_read] = csample;		// write new sample at read index
			newlevel = cabs(csample);
		}
		oldlevel = dat.levl[dat.index_read];
		dat.levl[dat.index_read] = newlevel;
		if (newlevel < dat.themax && oldlevel < dat.themax) {		// some other sample is the maximum
			// no change to dat.themax
		}
		else if (newlevel > dat.themax && newlevel > oldlevel) {	// newlevel is the maximum
			dat.themax = newlevel;
		}
		else {		// search for the maximum level
			dat.themax = 0;		// Find the maximim level in the buffer
			for (j = 0; j < dat.buf_size; j++) {
				if (dat.levl[j] > dat.themax)
					dat.themax = dat.levl[j];
			}
		}
// Increase dat.level if the maximum level is greater than 1.0;
// decrease it slowly back to 1.0 if it is lower.  Output is modulated by dat.level.
		if (dat.themax > 1.0)	// increase rapidly to the peak level
			dat.level = dat.level * (1.0 - out_short) + dat.themax * out_short;
		else				// decrease slowly back to 1.0
			dat.level = dat.level * (1.0 - out_long) + 1.0 * out_long;
		if (++dat.index_read >= dat.buf_size)
			dat.index_read = 0;
	}
	return dat.level;
}

static int tx_filter(complex double * filtered, int count)
{	// Input samples are creal(filtered), output is filtered.  The input rate must be 8000 or 48000 sps.
	int i, is_ssb;
	int sample_rate = 8000;
	double dsample, dtmp, magn;
	complex double csample;
	static double inMax=0.3;
	static double x_1=0;
	static double aaa, bbb, ccc, Xmin, Xmax, Ymax;
	static int samples_size = 0;
	static double * dsamples = NULL;
	static complex double * csamples = NULL;
	static double time_long, time_short;
	static struct quisk_dFilter filtDecim, dfiltInterp;
	static struct quisk_dFilter filtAudio1, filtAudio2, dfiltAudio3;
	static struct quisk_cFilter cfiltAudio3, cfiltInterp;
	static struct quisk_dFilter filter1={NULL}, filter2;
#if DEBUG_IO
	char * clip;
	static double dbOut = 0, Level0 = 0, Level1 = 0, Level2 = 0, Level3 = 0, Level4 = 0;
#endif
	is_ssb = (rxMode == 2 || rxMode == 3);
	if (!filtered) {		// initialization
		if (! filter1.dCoefs) {
			quisk_filt_dInit(&filter1, quiskMicFilt8Coefs, sizeof(quiskMicFilt8Coefs)/sizeof(double));
			quisk_filt_dInit(&filter2, quiskMicFilt8Coefs, sizeof(quiskMicFilt8Coefs)/sizeof(double));
			quisk_filt_dInit(&filtDecim,  quiskLpFilt48Coefs, sizeof(quiskLpFilt48Coefs)/sizeof(double));
			quisk_filt_dInit(&dfiltInterp, quiskLpFilt48Coefs, sizeof(quiskLpFilt48Coefs)/sizeof(double));
			quisk_filt_cInit(&cfiltInterp, quiskLpFilt48Coefs, sizeof(quiskLpFilt48Coefs)/sizeof(double));
			quisk_filt_dInit(&filtAudio1, quiskFiltTx8kAudioB, sizeof(quiskFiltTx8kAudioB)/sizeof(double));
			quisk_filt_dInit(&filtAudio2, quiskFiltTx8kAudioB, sizeof(quiskFiltTx8kAudioB)/sizeof(double));
			quisk_filt_dInit(&dfiltAudio3, quiskFiltTx8kAudioB, sizeof(quiskFiltTx8kAudioB)/sizeof(double));
			quisk_filt_cInit(&cfiltAudio3, quiskFiltTx8kAudioB, sizeof(quiskFiltTx8kAudioB)/sizeof(double));
			dtmp = 1.0 / sample_rate;		// sample time
			time_long   = 1.0 - exp(- dtmp / 3.000);
			time_short  = 1.0 - exp(- dtmp / 0.005);
			Ymax = pow(10.0,  - 1 / 20.0);				// maximum y
			Xmax = pow(10.0,  3 / 20.0);				// x where slope is zero; for x > Xmax, y == Ymax
			Xmin = Ymax - fabs(Ymax - Xmax);		// x where slope is 1 and y = x; start of compression
			aaa = 1.0 / (2.0 * (Xmin - Xmax));		// quadratic
			bbb = -2.0 * aaa * Xmax;
			ccc = Ymax - aaa * Xmax * Xmax - bbb * Xmax;
#if DEBUG_IO
			printf("Compress to %.2lf dB from %.2lf to %.2lf dB\n",
				20 * log10(Ymax), 20 * log10(Xmin), 20 * log10(Xmax));
#endif
		}
		if (is_ssb) {
		  quisk_filt_tune(&filter1, 1650.0 / sample_rate, rxMode != 2);
		  quisk_filt_tune(&filter2, 1650.0 / sample_rate, rxMode != 2);
		}
		return 0;
	}
	// check size of dsamples[] and csamples[] buffer
	if (count > samples_size) {
		samples_size = count * 2;
		if (dsamples)
			free(dsamples);
		if (csamples)
			free(csamples);
		dsamples = (double *)malloc(samples_size * sizeof(double));
		csamples = (complex double *)malloc(samples_size * sizeof(complex double));
	}
	// copy to dsamples[], normalize to +/- 1.0
	for (i = 0; i < count; i++)
		dsamples[i] = creal(filtered[i]) / CLIP16;
	// Decimate to 8000 Hz
	if (quisk_sound_state.mic_sample_rate != sample_rate)
		count = quisk_dDecimate(dsamples, count, &filtDecim, quisk_sound_state.mic_sample_rate / sample_rate);
	// restrict bandwidth 300 to 2700 Hz
	count = quisk_dFilter(dsamples, count, &filtAudio1);
#if DEBUG_IO
	// Measure peak input audio level
	for (i = 0; i < count; i++) {
		magn = fabs(dsamples[i]);
		if (magn > Level0)
			Level0 = magn;
	}
#endif
	// high pass filter for preemphasis: See Radcom, January 2010, page 76.
	// quisk_mic_preemphasis == 1 was measured as 6 dB / octave.
	// gain at 800 Hz was measured as 0.104672.
	for (i = 0; i < count; i++) {
		dtmp = dsamples[i];
		dsamples[i] = dtmp - quisk_mic_preemphasis * x_1;
		x_1 = dtmp;	// delayed sample
		dsamples[i] *= 2;		// compensate for loss
#if DEBUG_IO
		magn = fabs(dsamples[i]);
		if (magn > Level1)
			Level1 = magn;
#endif
	}
	if (is_ssb) {	// SSB
		// FIR bandpass filter; separate into I and Q
		for (i = 0; i < count; i++) {
			csample = quisk_dC_out(dsamples[i], &filter1);
			// Measure average peak input audio level and normalize
			magn = cabs(csample);
			if (magn > inMax)
				inMax = inMax * (1 - time_short) + time_short * magn;
			else if(magn > mic_agc_level)
				inMax = inMax * (1 - time_long) + time_long * magn;
			else
				inMax = inMax * (1 - time_long) + time_long * mic_agc_level;
			csample /= inMax;
			magn /= inMax;
#if DEBUG_IO
			if (magn > Level2)
				Level2 = magn;
#endif
			// Audio compression.
			csample *= quisk_mic_clip;
			magn *= quisk_mic_clip;
			if (magn > 1.0)
				csample = csample / magn;
			dsamples[i] = creal(csample);
		}
	}
	else {		// AM and FM
		// Measure average peak input audio level and normalize
		for (i = 0; i < count; i++) {
			dsample = dsamples[i];
			magn = fabs(dsample);
			if (magn > inMax)
				inMax = inMax * (1 - time_short) + time_short * magn;
			else if(magn > mic_agc_level)
				inMax = inMax * (1 - time_long) + time_long * magn;
			else
				inMax = inMax * (1 - time_long) + time_long * mic_agc_level;
			dsample /= inMax;
			magn /= inMax;
#if DEBUG_IO
			if (magn > Level2)
				Level2 = magn;
#endif
		// Audio compression.
			dsample *= quisk_mic_clip;
			magn *= quisk_mic_clip;
			if (magn < Xmin)
				dsamples[i] = dsample;
			else if (magn > Xmax)
				dsamples[i] = copysign(Ymax, dsample);
			else
				dsamples[i] = copysign(aaa * magn * magn + bbb * magn + ccc, dsample);
		}
	}
	// remove clipping distortion; restrict bandwidth 300 to 2700 Hz
	count = quisk_dFilter(dsamples, count, &filtAudio2);
	if (is_ssb) {	// SSB
		// FIR bandpass filter; separate into I and Q
		for (i = 0; i < count; i++) {
			csamples[i] = quisk_dC_out(dsamples[i], &filter2);
#if DEBUG_IO
			magn = cabs(csamples[i]);
			if (magn > Level3)
				Level3 = magn;
#endif
		}
		// round off peaks
		CcmPeak(NULL, csamples, count);
#if DEBUG_IO
		for (i = 0; i < count; i++) {
			magn = cabs(csamples[i]);
			if (magn > Level4)
				Level4 = magn;
		}
#endif
		// remove clipping distortion
		count = quisk_cDecimate(csamples, count, &cfiltAudio3, 1);
		// Interpolate up to 48000
		if (MIC_OUT_RATE != sample_rate)
			count = quisk_cInterpolate(csamples, count, &cfiltInterp, MIC_OUT_RATE / sample_rate);
		// convert back to 16 bits and reduce level to allow headroom
		for (i = 0; i < count; i++) {
			csamples[i] /= 1.3;
			magn = cabs(csamples[i]);
			if (magn > 1.0)
				filtered[i] = csamples[i] / magn * CLIP16;
			else
				filtered[i] = csamples[i] * CLIP16;
#if DEBUG_IO
			if (magn > dbOut)
				dbOut = magn;
#endif
		}
	}
	else {		// AM and FM
#if DEBUG_IO
		for (i = 0; i < count; i++) {
			magn = fabs(dsamples[i]);
			if (magn > Level3)
				Level3 = magn;
		}
#endif
		// round off peaks
		CcmPeak(dsamples, NULL, count);
#if DEBUG_IO
		for (i = 0; i < count; i++) {
			magn = fabs(dsamples[i]);
			if (magn > Level4)
				Level4 = magn;
		}
#endif
		// remove clipping distortion
		count = quisk_dFilter(dsamples, count, &dfiltAudio3);
		// Interpolate up to 48000
		if (MIC_OUT_RATE != sample_rate)
			count = quisk_dInterpolate(dsamples, count, &dfiltInterp, MIC_OUT_RATE / sample_rate);
		// convert back to 16 bits and reduce level to allow headroom
		for (i = 0; i < count; i++) {
			dsamples[i] /= 1.3;
			magn = fabs(dsamples[i]);
#if DEBUG_IO
			if (magn > dbOut)
				dbOut = magn;
#endif
			if (magn > 1.0)
				filtered[i] = dsamples[i] / magn * CLIP16;
			else
				filtered[i] = dsamples[i] * CLIP16;
		}
	}
#if DEBUG_IO
	if (debug_timer == 0) {
		if (dbOut > 1.0)
			clip = "Clip";
		else
			clip = "";
		dbOut = 20 * log10(dbOut);
		printf ("pre %3.1lf dB clip %2.0lf InMax %6.2lf   Level0 %6.2lf  Level1 %6.2lf  Level2 %6.2lf  Level3 %6.2lf  Level4 %6.2lf  dbOut %6.2lf  %s\n",
			quisk_mic_preemphasis, 20 * log10(quisk_mic_clip), 20 * log10(inMax), 20 * log10(Level0),
			20 * log10(Level1), 20 * log10(Level2), 20 * log10(Level3),  20 * log10(Level4), dbOut, clip);
		Level0 = Level1 = Level2 = Level3 = Level4 = dbOut = 0;
	}
	//QuiskPrintTime("    tx_filter", 2);
#endif
	return count;
}

static int tx_filter_digital(complex double * filtered, int count, double volume)
{	// Input samples are creal(filtered), output is filtered.
	// This filter has minimal processing and is used for digital modes.
	int i;
	double dsample, amplitude;
	complex double csample;

	static struct quisk_dFilter filter1;
#if DEBUG_IO
	double x;
	static double peakIn = 0, peakOut2 = 0;		// input/output level
#endif
	if (!filtered) {		// initialization
		quisk_filt_dInit(&filter1, quiskMic5Filt48Coefs, sizeof(quiskMic5Filt48Coefs)/sizeof(double));
		quisk_filt_tune(&filter1, 2650.0 / 48000, rxMode != 8 && rxMode != 2);
		return 0;
	}
#if DEBUG_IO
	//QuiskPrintTime("", -2);
#endif
	for (i = 0; i < count; i++) {
		dsample = creal(filtered[i]) / CLIP16;		// normalize to +/- 1.0
#if DEBUG_IO
		x = fabs(dsample);
		if (x > peakIn)
			peakIn = x;
#endif
		// FIR bandpass filter; separate into I and Q
		csample = quisk_dC_out(dsample, &filter1);
		amplitude = cabs(csample);
#if DEBUG_IO
		if (amplitude > peakOut2)
			peakOut2 = amplitude;
#endif
		if (amplitude > 1.0)
			csample /= amplitude;
		filtered[i] = csample * CLIP16 * volume;		// convert back to 16 bits
	}

//printf("%5.2lf\n", increasing);
#if DEBUG_IO
	if (debug_timer == 0) {
		printf ("peakIn %10.6lf  peakOut2 %10.6lf", peakIn, peakOut2);
		if (peakOut2 > 1.0)
			printf ("  CLIP\n");
		else
			printf ("\n");
		peakIn = peakOut2 = 0;
	}
	//QuiskPrintTime("    tx_filter", 2);
#endif
	return count;
}

static int tx_filter_freedv(complex double * filtered, int count, int encode)
{	// Input samples are creal(filtered), output is filtered.
	// This filter is used for digital voice.
	int i;
	int sample_rate = 8000;
	double dtmp, magn, dsample;
	static int samples_size = 0;
	static double aaa, bbb, ccc, Xmin, Xmax, Ymax;
	static double time_long, time_short;
	static double x_1=0;
	static double inMax=0.3;
	static double * dsamples = NULL;
	static struct quisk_dFilter filter2, filtDecim;
	static struct quisk_cFilter cfiltInterp;
#if DEBUG_IO
	double x;
	static double peakIn = 0, peakOut2 = 0;		// input/output level
#endif

	if (!filtered) {		// initialization
		quisk_filt_dInit(&filter2, quiskMicFilt8Coefs, sizeof(quiskMicFilt8Coefs)/sizeof(double));
		quisk_filt_tune(&filter2, 1650.0 / sample_rate, rxMode != 12);
		quisk_filt_dInit(&filtDecim,  quiskLpFilt48Coefs, sizeof(quiskLpFilt48Coefs)/sizeof(double));
		quisk_filt_cInit(&cfiltInterp, quiskLpFilt48Coefs, sizeof(quiskLpFilt48Coefs)/sizeof(double));
		dtmp = 1.0 / sample_rate;		// sample time
		time_long   = 1.0 - exp(- dtmp / 3.000);
		time_short  = 1.0 - exp(- dtmp / 0.005);
		Ymax = pow(10.0,  - 1 / 20.0);				// maximum y
		Xmax = pow(10.0,  3 / 20.0);				// x where slope is zero; for x > Xmax, y == Ymax
		Xmin = Ymax - fabs(Ymax - Xmax);			// x where slope is 1 and y = x; start of compression
		aaa = 1.0 / (2.0 * (Xmin - Xmax));			// quadratic
		bbb = -2.0 * aaa * Xmax;
		ccc = Ymax - aaa * Xmax * Xmax - bbb * Xmax;
		return 0;
	}
	// check size of dsamples[] buffer
	if (count > samples_size) {
		samples_size = count * 2;
		if (dsamples)
			free(dsamples);
		dsamples = (double *)malloc(samples_size * sizeof(double));
	}
	// copy to dsamples[]
	for (i = 0; i < count; i++)
		dsamples[i] = creal(filtered[i]) / CLIP16;
	// Decimate to 8000 Hz
	if (quisk_sound_state.mic_sample_rate != sample_rate)
		count = quisk_dDecimate(dsamples, count, &filtDecim, quisk_sound_state.mic_sample_rate / sample_rate);
	// high pass filter for preemphasis: See Radcom, January 2010, page 76.
	// quisk_mic_preemphasis == 1 was measured as 6 dB / octave.
	// gain at 800 Hz was measured as 0.104672.
	for (i = 0; i < count; i++) {
		dtmp = dsamples[i];
		dsamples[i] = dtmp - quisk_mic_preemphasis * x_1;
		x_1 = dtmp;	// delayed sample
		dsamples[i] *= 2;		// compensate for loss
	}
	// Measure average peak input audio level and normalize
	for (i = 0; i < count; i++) {
		dsample = dsamples[i];
		magn = fabs(dsample);
		if (magn > inMax)
			inMax = inMax * (1 - time_short) + time_short * magn;
		else if(magn > mic_agc_level)
			inMax = inMax * (1 - time_long) + time_long * magn;
		else
			inMax = inMax * (1 - time_long) + time_long * mic_agc_level;
		dsample /= inMax;
		magn /= inMax;
		// Audio compression.
		dsample *= quisk_mic_clip;
		magn *= quisk_mic_clip;
		if (magn < Xmin)
			dsamples[i] = dsample;
		else if (magn > Xmax)
			dsamples[i] = copysign(Ymax, dsample);
		else
			dsamples[i] = copysign(aaa * magn * magn + bbb * magn + ccc, dsample);
#if DEBUG_IO
		x = fabs(dsamples[i]);
		if (x > peakIn)
			peakIn = x;
#endif
		dsamples[i] = dsamples[i] * CLIP16;
	}
	if (encode && pt_quisk_freedv_tx)   // Encode audio into digital modulation
		count = (* pt_quisk_freedv_tx)(filtered, dsamples, count);
	// Interpolate up to 48000
	if (MIC_OUT_RATE != sample_rate)
		count = quisk_cInterpolate(filtered, count, &cfiltInterp, MIC_OUT_RATE / sample_rate);
#if DEBUG_IO
	for (i = 0; i < count; i++) {
		magn = cabs(filtered[i]) / CLIP16;
		if (magn > peakOut2)
			peakOut2 = magn;
	}
	if (debug_timer == 0) {
		printf ("peakIn %10.6lf  peakOut2 %10.6lf", peakIn, peakOut2);
		if (peakOut2 > 1.0)
			printf ("  CLIP\n");
		else
			printf ("\n");
		peakIn = peakOut2 = 0;
	}
#endif
	return count;
}

PyObject * quisk_get_tx_filter(PyObject * self, PyObject * args)
{  // return the TX filter response to display on the graph
// This is for debugging.  Change quisk.py to call QS.get_tx_filter() instead
// of QS.get_filter().
	int i, j, k;
	int freq, time;
	PyObject * tuple2;
	complex double cx;
	double scale;
	double * average, * fft_window, * bufI, * bufQ;
	fftw_complex * samples, * pt;		// complex data for fft
	fftw_plan plan;						// fft plan
	double phase, delta;
	int nTaps = 325;

	if (!PyArg_ParseTuple (args, ""))
		return NULL;

	// Create space for the fft of size data_width
	pt = samples = (fftw_complex *) fftw_malloc(sizeof(fftw_complex) * data_width);
	plan = fftw_plan_dft_1d(data_width, pt, pt, FFTW_FORWARD, FFTW_MEASURE);
	average = (double *) malloc(sizeof(double) * (data_width + nTaps));
	fft_window = (double *) malloc(sizeof(double) * data_width);
	bufI = (double *) malloc(sizeof(double) * nTaps);
	bufQ = (double *) malloc(sizeof(double) * nTaps);

	for (i = 0, j = -data_width / 2; i < data_width; i++, j++)	// Hanning
		fft_window[i] = 0.5 + 0.5 * cos(2. * M_PI * j / data_width);

	for (i = 0; i < data_width + nTaps; i++)
		average[i] = 0.5;	// Value for freq == 0
	for (freq = 1; freq < data_width / 2.0 - 10.0; freq++) {
	//freq = data_width * 0.2 / 48.0;
		delta = 2 * M_PI / data_width * freq;
		phase = 0;
		// generate some initial samples to fill the filter pipeline
		for (time = 0; time < data_width + nTaps; time++) {
			average[time] += cos(phase);	// current sample
			phase += delta;
			if (phase > 2 * M_PI)
				phase -= 2 * M_PI;
		}
	}
	// now filter the signal using the transmit filter
	tx_filter(NULL, 0);				// initialize
	scale = 1.0;
	for (i = 0; i < data_width; i++)
		if (fabs(average[i + nTaps]) > scale)
			scale = fabs(average[i + nTaps]);
	scale = CLIP16 / scale;		// limit to CLIP16
	for (i = 0; i < nTaps; i++)
		samples[i] = average[i] * scale;
	tx_filter(samples, nTaps);			// process initial samples
	for (i = 0; i < data_width; i++)
		samples[i] = average[i + nTaps] * scale;
	tx_filter(samples, data_width);	// process the samples

	for (i = 0; i < data_width; i++)	// multiply by window
		samples[i] *= fft_window[i];
	fftw_execute(plan);		// Calculate FFT
	// Normalize and convert to log10
	scale = 0.3 / data_width / scale;
	for (k = 0; k < data_width; k++) {
		cx = samples[k];
		average[k] = cabs(cx) * scale;
		if (average[k] <= 1e-7)		// limit to -140 dB
			average[k] = -7;
		else
			average[k] = log10(average[k]);
	}
	// Return the graph data
	tuple2 = PyTuple_New(data_width);
	i = 0;
	// Negative frequencies:
	for (k = data_width / 2; k < data_width; k++, i++)
		PyTuple_SetItem(tuple2, i, PyFloat_FromDouble(20.0 * average[k]));

	// Positive frequencies:
	for (k = 0; k < data_width / 2; k++, i++)
		PyTuple_SetItem(tuple2, i, PyFloat_FromDouble(20.0 * average[k]));

	free(bufQ);
	free(bufI);
	free(average);
	free(fft_window);
	fftw_destroy_plan(plan);
	fftw_free(samples);

	return tuple2;
}

// Send samples using the Metis-Hermes protocol.  A frame is 8 bytes: L/R audio and I/Q mic samples.
// All samples are 2 bytes.  The 1032 byte UDP packet contains 63*2 radio sound samples, and 63*2 mic I/Q samples.
// Samples are sent synchronously with the input samples.

void quisk_hermes_tx_add(complex double * cSamples, int tx_count)
{	// Add samples to the Tx buffer
	int i;

	if (hermes_num_samples + tx_count >= HERMES_TX_BUF_SAMPLES) {	// no more space; throw away half the samples
		quisk_udp_mic_error("Tx hermes buffer overflow");
		//printf("Tx hermes buffer overflow\n");
		i = HERMES_TX_BUF_SAMPLES / 2;
		hermes_num_samples -= i;
		hermes_write_index -= i * 2;
		if (hermes_write_index < 0)
			hermes_write_index += HERMES_TX_BUF_SHORTS;
	}
	hermes_num_samples += tx_count;
	if (cSamples) {
		for (i = 0; i < tx_count; i++) {			// Put transmit mic samples into the buffer
			hermes_buf[hermes_write_index++] = (short)cimag(cSamples[i]);
			hermes_buf[hermes_write_index++] = (short)creal(cSamples[i]);
			if (hermes_write_index >= HERMES_TX_BUF_SHORTS)
				hermes_write_index = 0;
		}
	}
	else {
		for (i = 0; i < tx_count; i++) {			// Put zero mic samples into the buffer
			hermes_buf[hermes_write_index++] = 0;
			hermes_buf[hermes_write_index++] = 0;
			if (hermes_write_index >= HERMES_TX_BUF_SHORTS)
				hermes_write_index = 0;
		}
	}
}
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
