jmharvey1/SdrCwXcvr/Quisk/quisk_conf_defaults.py

from __future__ import absolute_import
from __future__ import division
#  ** This is the file quisk_conf_defaults.py which contains defaults for Quisk. **
#  
# Please do not change this configuration file quisk_conf_defaults.py.
# Instead copy one of the other quisk_conf_*.py files to your own
# configuration file and make changes there.
#
# For Linux, your standard configuration file name is .quisk_conf.py in your home directory.
#
# For Windows, your standard comfiguration file name is quisk_conf.py in your Documents folder.
#
# You can specify a different configuration file with the -c or --config command line argument.
#
# Check the config screen to make sure that the correct configuration file is in use.
#
#
# PLEASE DO **NOT** COPY THIS FILE AND USE IT AS A START FOR YOUR CONFIGURATION FILE!
# YOUR CONFIGURATION FILE SHOULD ONLY HAVE LINES THAT DIFFER FROM THIS FILE.  QUISK
# IMPORTS THIS FILE FIRST, AND THEN YOUR CONFIG FILE OVERWRITES A FEW ITEMS SUCH AS
# SOUND CARD NAMES.
#
# Quisk imports quisk_conf_defaults.py to set its configuration.
# If you have a configuration file, it then overwrites the defaults
# with your parameters.
#
# Quisk uses a hardware file to control your transceiver and optionally other station hardware.
# Your config file specifies the hardware file to use.  Quisk comes with several hardware
# files, and you can write your own hardware file in Python to do anything you want.
#
# Quisk has a custom decimation scheme for each sample rate.  The allowable sample rates
# are the four SDR-IQ rates plus 24, 48, 96, 192, 240, 384, 480, and 960 ksps.  Other rates
# can be added.

import sys
import wx

# Import the default Hardware module.  You can import a different module in
# your configuration file.
import quisk_hardware_model as quisk_hardware

# Module for additional widgets (advanced usage).  See n2adr/quisk_widgets.py for an example.
# import n2adr.quisk_widgets as quisk_widgets
quisk_widgets = None
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
