jmharvey1/SdrCwXcvr/(commit log)

2018-12-14 Initial file upload
    1st upload
    [74145SDRbandCntrlBd.brd, 74145SDRbandCntrlBd.sch, SDR 74HC4052_Si5351R0.brd, SDR 74HC4052_Si5351R0.sch]
2018-12-15 Add 100mw pa eagle files
    5 volt 100 mw pa using discrete transistors and through hole
    consturction; A companion xmt brd for the SDR CW Xcvr project
    [40M_100mWattWSPRamp.brd, 40M_100mWattWSPRamp.sch]
2019-04-18 Update project related files
    Updating project files to mirror the current configuration of the SDR
    [SDR 74HC4052_Si5351R0.brd, SDR 74HC4052_Si5351R1.brd, SDR 74HC4052_Si5351R1.sch]
2019-08-06 Files needed to build _quisk.so
    added just the files needed to build the current version of _quisk.so
2020-12-13 More tweaks to FLDIGI code
    these code changes further reduce background process switching during CW
    TX periods
2021-01-03 Added Quisk source files back to repository
    Collective changes made today revise the methods used to steam keying
    data from FLDIGI to the Arduino SSmicro thruogh QUISK. this updates
    FLDIGI to conform to the standards/techniques employed in version 4.1.17
2021-01-30 Fixed SSMicro Sketch to handle FLDIGI "TUNE" stream
    FLDIGI Tune stream ended with keydown command. This left old ss micro
    sketch in an indeterment state. At times leaving the T/R in the TX state
    and could also leave QUISK hung in "send/tx" mode. This small change
    ensures that both QUISK and the T/R control lead are set to receive when
    the key steaming stops
    [si5351_SSMicro_SDR_QUISK.ino]
2021-11-13 Change to SSMicro Sketch to fix timeout issue when Manually Keying the Transmitter
    Added "if" condition to block "streaming timeout" from forcing the SDR
    in to receive mode while being manually keyed
    [si5351_SSMicro_SDR_QUISK.ino]
2024-12-06 Added SDR 74HC4052_Si5351R2_2020-03-30.zip for PCB service support
