jmharvey1/SdrCwXcvr/(notices)

Notices in the files:
Quisk/quisk_vna.py:
All QUISK software is Copyright (C) 2006-2016 by James C. Ahlstrom.
License (GPL), see http://www.opensource.org.
Quisk/quisk.py:
All QUISK software is Copyright (C) 2006-2018 by James C. Ahlstrom.
Arduino/si5351_SSMicro_SDR_QUISK/si5351_SSMicro_SDR_QUISK.ino:
This program is free software: you can redistribute it and/or modify
it under the terms of the GNU General Public License as published by
the Free Software Foundation, either version 3 of the License, or
(at your option) any later version.
